azonenberg/integralstick/host-full/host-full.kicad_pcb

## KiCad design host-full/host-full.kicad_pcb (2019-11-11)

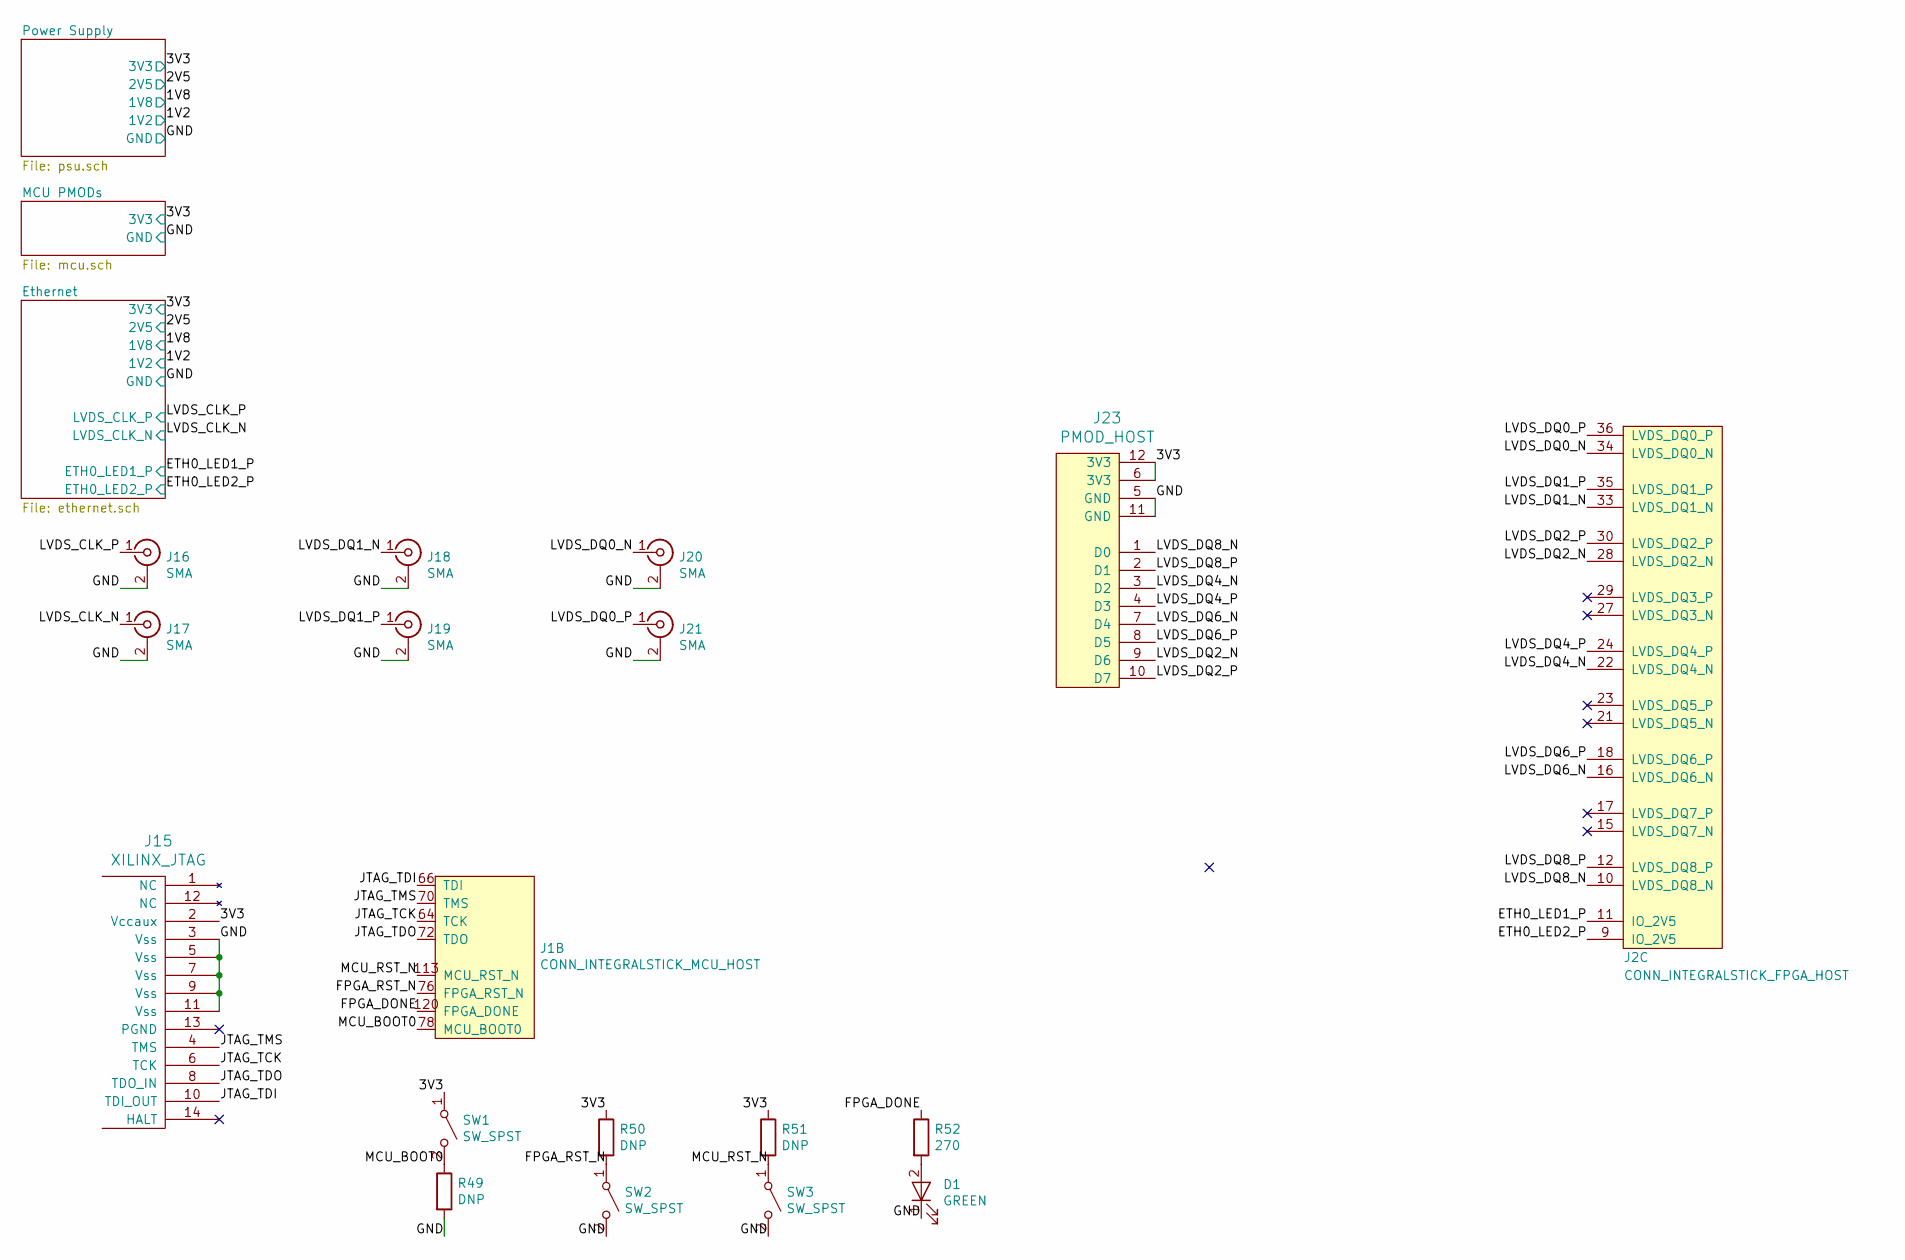
[picture p1: schematic host-full.sch, INTEGRALSTICK Full Host]

Parts:
D1: GREEN; EIA_0603_LED
J1: CONN_INTEGRALSTICK_MCU_HOST; CONN_SAMTEC_QSH-060-01-L-D-A
J2: CONN_INTEGRALSTICK_FPGA_HOST; CONN_SAMTEC_QSH-060-01-L-D-A
J15: XILINX_JTAG; XILINX_JTAG_PTH_MOLEX_0878311420
J16, J17, J18, J19, J20, J21: SMA; CONN_SMA_EDGE_SAMTEC_SMA_J_P_H_ST_EM1
J23: PMOD_HOST; CONN_HEADER_2.54MM_2x6_RA_PMOD_HOST
R49, R50, R51: DNP; EIA_0402_RES_NOSILK
R52: 270; EIA_0402_RES_NOSILK
SW1, SW2, SW3: SW_SPST; SWITCH_RAFI_MICON_5

Connections:
/3V3: J15.2 (Vccaux), J23.6 (3V3), J23.12 (3V3), R50.1, R51.1, SW1.1 (A); also elsewhere on the board
/ETH0_LED1_P: J2.11 (IO_2V5); also elsewhere on the board
/ETH0_LED2_P: J2.9 (IO_2V5); also elsewhere on the board
/FPGA_DONE: J1.120 (FPGA_DONE), R52.1
/FPGA_RST_N: J1.76 (FPGA_RST_N), R50.2, SW2.1 (A)
/GND: D1.1 (K), J15.3 (Vss), J15.5 (Vss), J15.7 (Vss), J15.9 (Vss), J15.11 (Vss), J16.2 (Ext), J17.2 (Ext), J18.2 (Ext), J19.2 (Ext), J20.2 (Ext), J21.2 (Ext), J23.5 (GND), J23.11 (GND), R49.2, SW2.2 (B), SW3.2 (B); also elsewhere on the board
/JTAG_TCK: J1.64 (TCK), J15.6 (TCK)
/JTAG_TDI: J1.66 (TDI), J15.10 (TDI_OUT)
/JTAG_TDO: J1.72 (TDO), J15.8 (TDO_IN)
/JTAG_TMS: J1.70 (TMS), J15.4 (TMS)
/LVDS_CLK_N: J17.1 (In); also elsewhere on the board
/LVDS_CLK_P: J16.1 (In); also elsewhere on the board
/LVDS_DQ0_N: J2.34 (LVDS_DQ0_N), J20.1 (In)
/LVDS_DQ0_P: J2.36 (LVDS_DQ0_P), J21.1 (In)
/LVDS_DQ1_N: J2.33 (LVDS_DQ1_N), J18.1 (In)
/LVDS_DQ1_P: J2.35 (LVDS_DQ1_P), J19.1 (In)
/LVDS_DQ2_N: J2.28 (LVDS_DQ2_N), J23.9 (D6)
/LVDS_DQ2_P: J2.30 (LVDS_DQ2_P), J23.10 (D7)
/LVDS_DQ4_N: J2.22 (LVDS_DQ4_N), J23.3 (D2)
/LVDS_DQ4_P: J2.24 (LVDS_DQ4_P), J23.4 (D3)
/LVDS_DQ6_N: J2.16 (LVDS_DQ6_N), J23.7 (D4)
/LVDS_DQ6_P: J2.18 (LVDS_DQ6_P), J23.8 (D5)
/LVDS_DQ8_N: J2.10 (LVDS_DQ8_N), J23.1 (D0)
/LVDS_DQ8_P: J2.12 (LVDS_DQ8_P), J23.2 (D1)
/MCU_BOOT0: J1.78 (MCU_BOOT0), R49.1, SW1.2 (B)
/MCU_RST_N: J1.113 (MCU_RST_N), R51.2, SW3.1 (A)
unnamed: D1.2 (A), R52.2

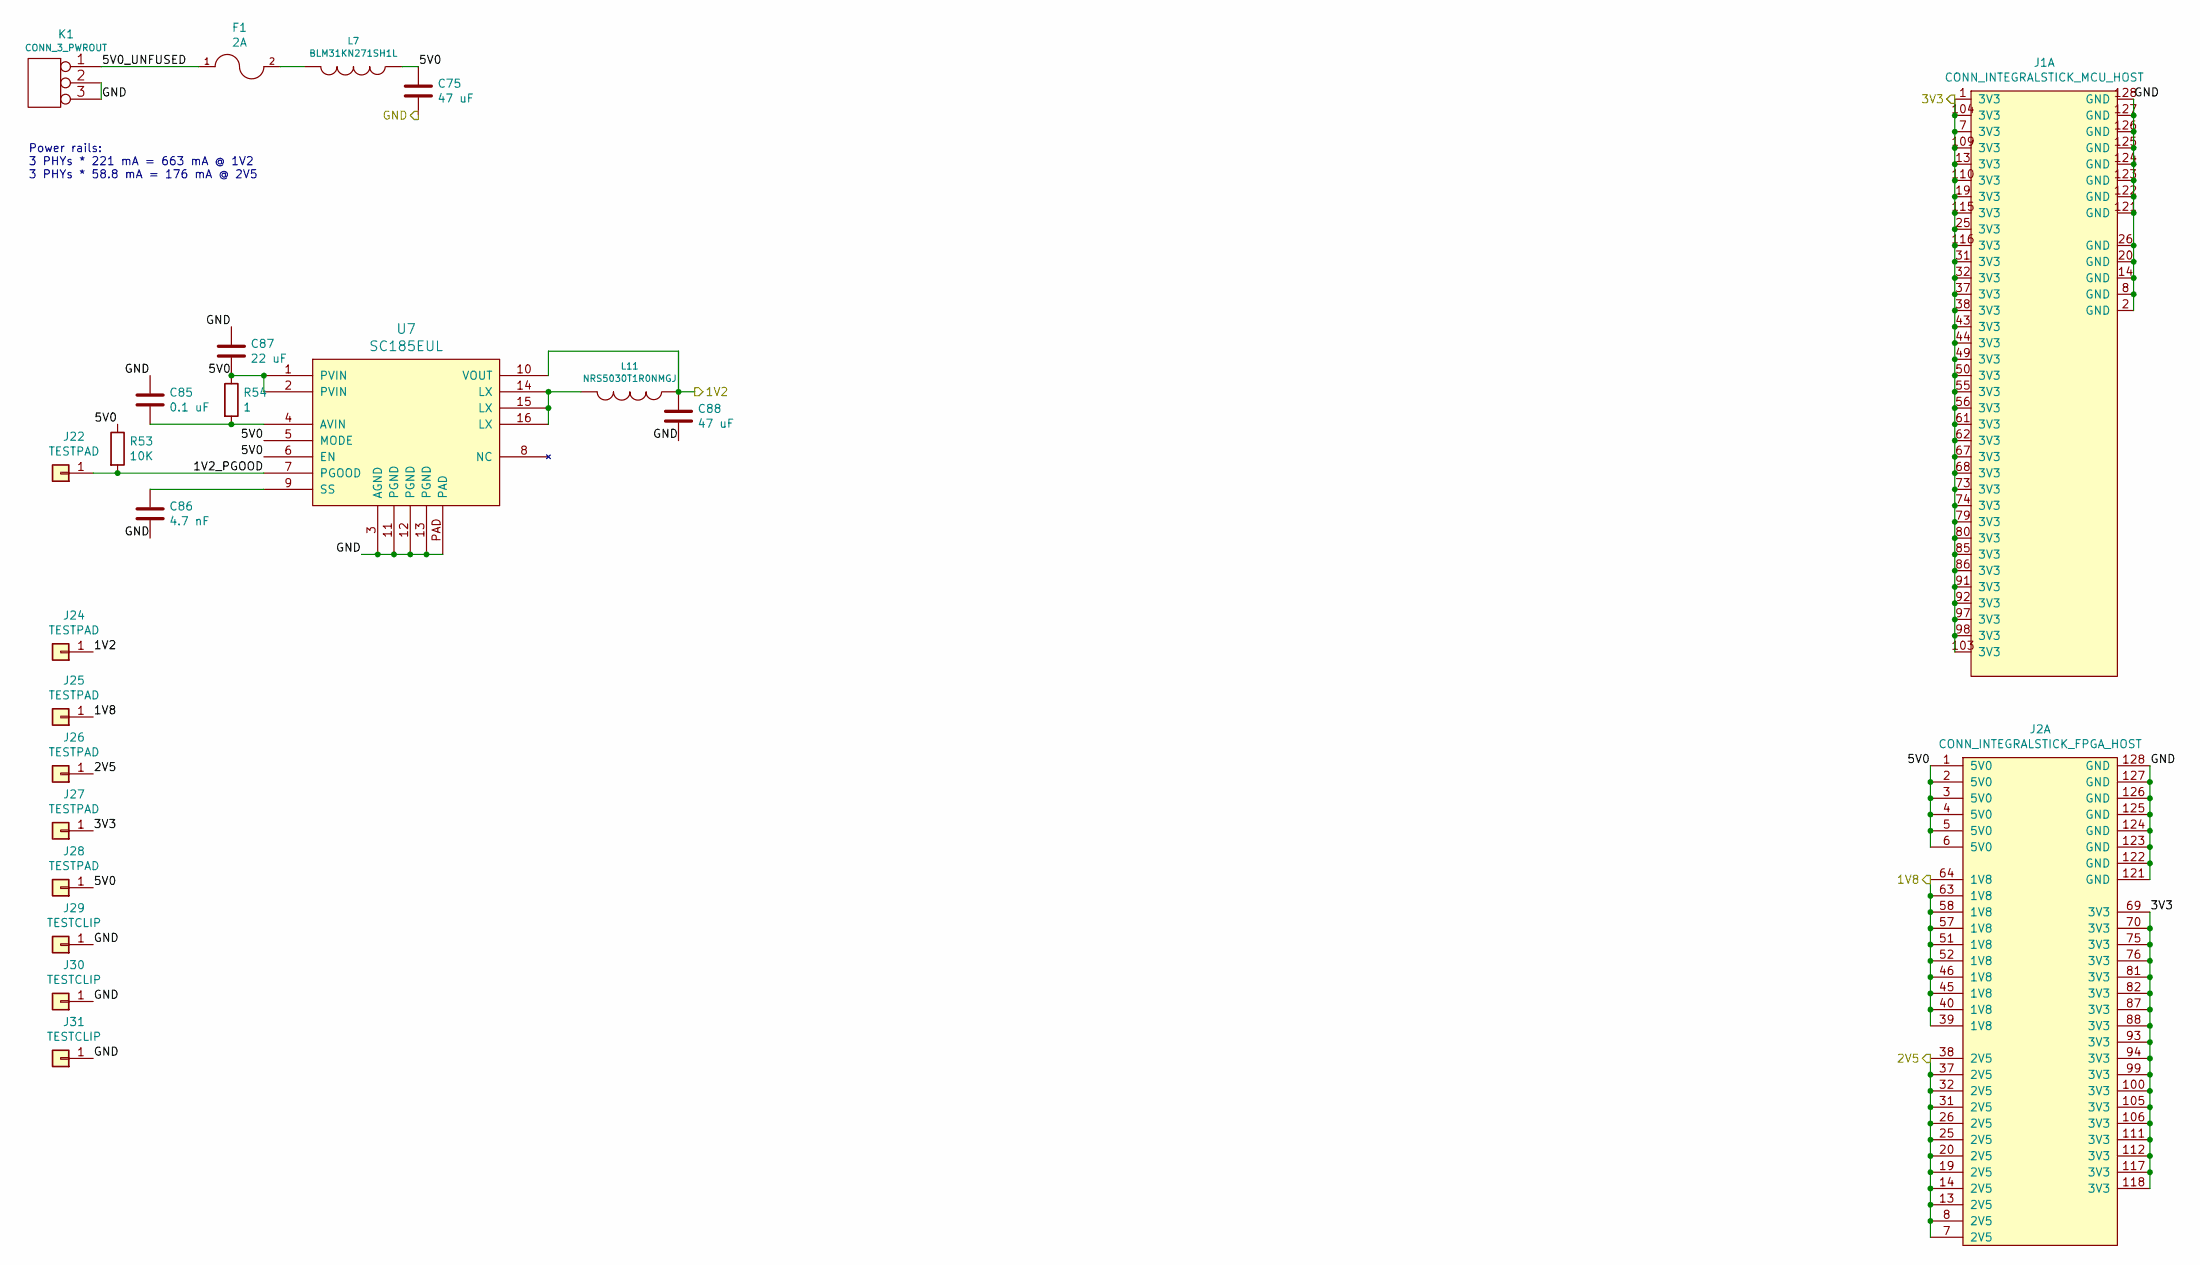
[picture p2: schematic psu.sch, INTEGRALSTICK Full Host]

Parts:
C75, C88: 47 uF; EIA_1210_CAP_NOSILK
C85: 0.1 uF; EIA_0402_CAP_NOSILK
C86: 4.7 nF; EIA_0603_CAP_NOSILK
C87: 22 uF; EIA_1210_CAP_NOSILK
F1: 2A; EIA_0603_RES_NOSILK
J1: CONN_INTEGRALSTICK_MCU_HOST; CONN_SAMTEC_QSH-060-01-L-D-A
J2: CONN_INTEGRALSTICK_FPGA_HOST; CONN_SAMTEC_QSH-060-01-L-D-A
J22, J24, J25, J26, J27, J28: TESTPAD; TESTPOINT_SMT_0.5MM
J29, J30, J31: TESTCLIP; TESTPOINT_SMT_KEYSTONE_5016
K1: CONN_3_PWROUT; CONN_CUI_PJ-058BH_HIPWR_BARREL_NOSLOT
L7: BLM31KN271SH1L; EIA_1206_CAP_NOSILK
L11: NRS5030T1R0NMGJ; INDUCTOR_YUDEN_NRS5030
R53: 10K; EIA_0402_RES_NOSILK
R54: 1; EIA_0402_RES_NOSILK
U7: SC185EUL; QFN_16_0.5MM_3x3MM

Connections:
/1V2: C88.1, J24.1, L11.1, U7.10 (VOUT); also elsewhere on the board
/1V8: J2.39 (1V8), J2.40 (1V8), J2.45 (1V8), J2.46 (1V8), J2.51 (1V8), J2.52 (1V8), J2.57 (1V8), J2.58 (1V8), J2.63 (1V8), J2.64 (1V8), J25.1; also elsewhere on the board
/2V5: J2.7 (2V5), J2.8 (2V5), J2.13 (2V5), J2.14 (2V5), J2.19 (2V5), J2.20 (2V5), J2.25 (2V5), J2.26 (2V5), J2.31 (2V5), J2.32 (2V5), J2.37 (2V5), J2.38 (2V5), J26.1; also elsewhere on the board
/3V3: J1.1 (3V3), J1.7 (3V3), J1.13 (3V3), J1.19 (3V3), J1.25 (3V3), J1.31 (3V3), J1.32 (3V3), J1.37 (3V3), J1.38 (3V3), J1.43 (3V3), J1.44 (3V3), J1.49 (3V3), J1.50 (3V3), J1.55 (3V3), J1.56 (3V3), J1.61 (3V3), J1.62 (3V3), J1.67 (3V3), J1.68 (3V3), J1.73 (3V3), J1.74 (3V3), J1.79 (3V3), J1.80 (3V3), J1.85 (3V3), J1.86 (3V3), J1.91 (3V3), J1.92 (3V3), J1.97 (3V3), J1.98 (3V3), J1.103 (3V3), J1.104 (3V3), J1.109 (3V3), J1.110 (3V3), J1.115 (3V3), J1.116 (3V3), J2.69 (3V3), J2.70 (3V3), J2.75 (3V3), J2.76 (3V3), J2.81 (3V3), J2.82 (3V3), J2.87 (3V3), J2.88 (3V3), J2.93 (3V3), J2.94 (3V3), J2.99 (3V3), J2.100 (3V3), J2.105 (3V3), J2.106 (3V3), J2.111 (3V3), J2.112 (3V3), J2.117 (3V3), J2.118 (3V3), J27.1; also elsewhere on the board
/GND: C75.2, C85.1, C86.2, C87.1, C88.2, J1.2 (GND), J1.8 (GND), J1.14 (GND), J1.20 (GND), J1.26 (GND), J1.121 (GND), J1.122 (GND), J1.123 (GND), J1.124 (GND), J1.125 (GND), J1.126 (GND), J1.127 (GND), J1.128 (GND), J2.121 (GND), J2.122 (GND), J2.123 (GND), J2.124 (GND), J2.125 (GND), J2.126 (GND), J2.127 (GND), J2.128 (GND), J29.1, J30.1, J31.1, K1.2 (PM), K1.3, U7.3 (AGND), U7.11 (PGND), U7.12 (PGND), U7.13 (PGND), U7.PAD; also elsewhere on the board
/Power Supply/1V2_PGOOD: J22.1, R53.2, U7.7 (PGOOD)
/Power Supply/5V0: C75.1, C87.2, J2.1 (5V0), J2.2 (5V0), J2.3 (5V0), J2.4 (5V0), J2.5 (5V0), J2.6 (5V0), J28.1, L7.1, R53.1, R54.1, U7.1 (PVIN), U7.2 (PVIN), U7.5 (MODE), U7.6 (EN)
/Power Supply/5V0_UNFUSED: F1.1, K1.1
unnamed: C85.2, R54.2, U7.4 (AVIN)
unnamed: C86.1, U7.9 (SS)
unnamed: F1.2, L7.2
unnamed: L11.2, U7.14 (LX), U7.15 (LX), U7.16 (LX)

Notes on the sheet:
Power rails: 3 PHYs * 221 mA = 663 mA @ 1V2 3 PHYs * 58.8 mA = 176 mA @ 2V5

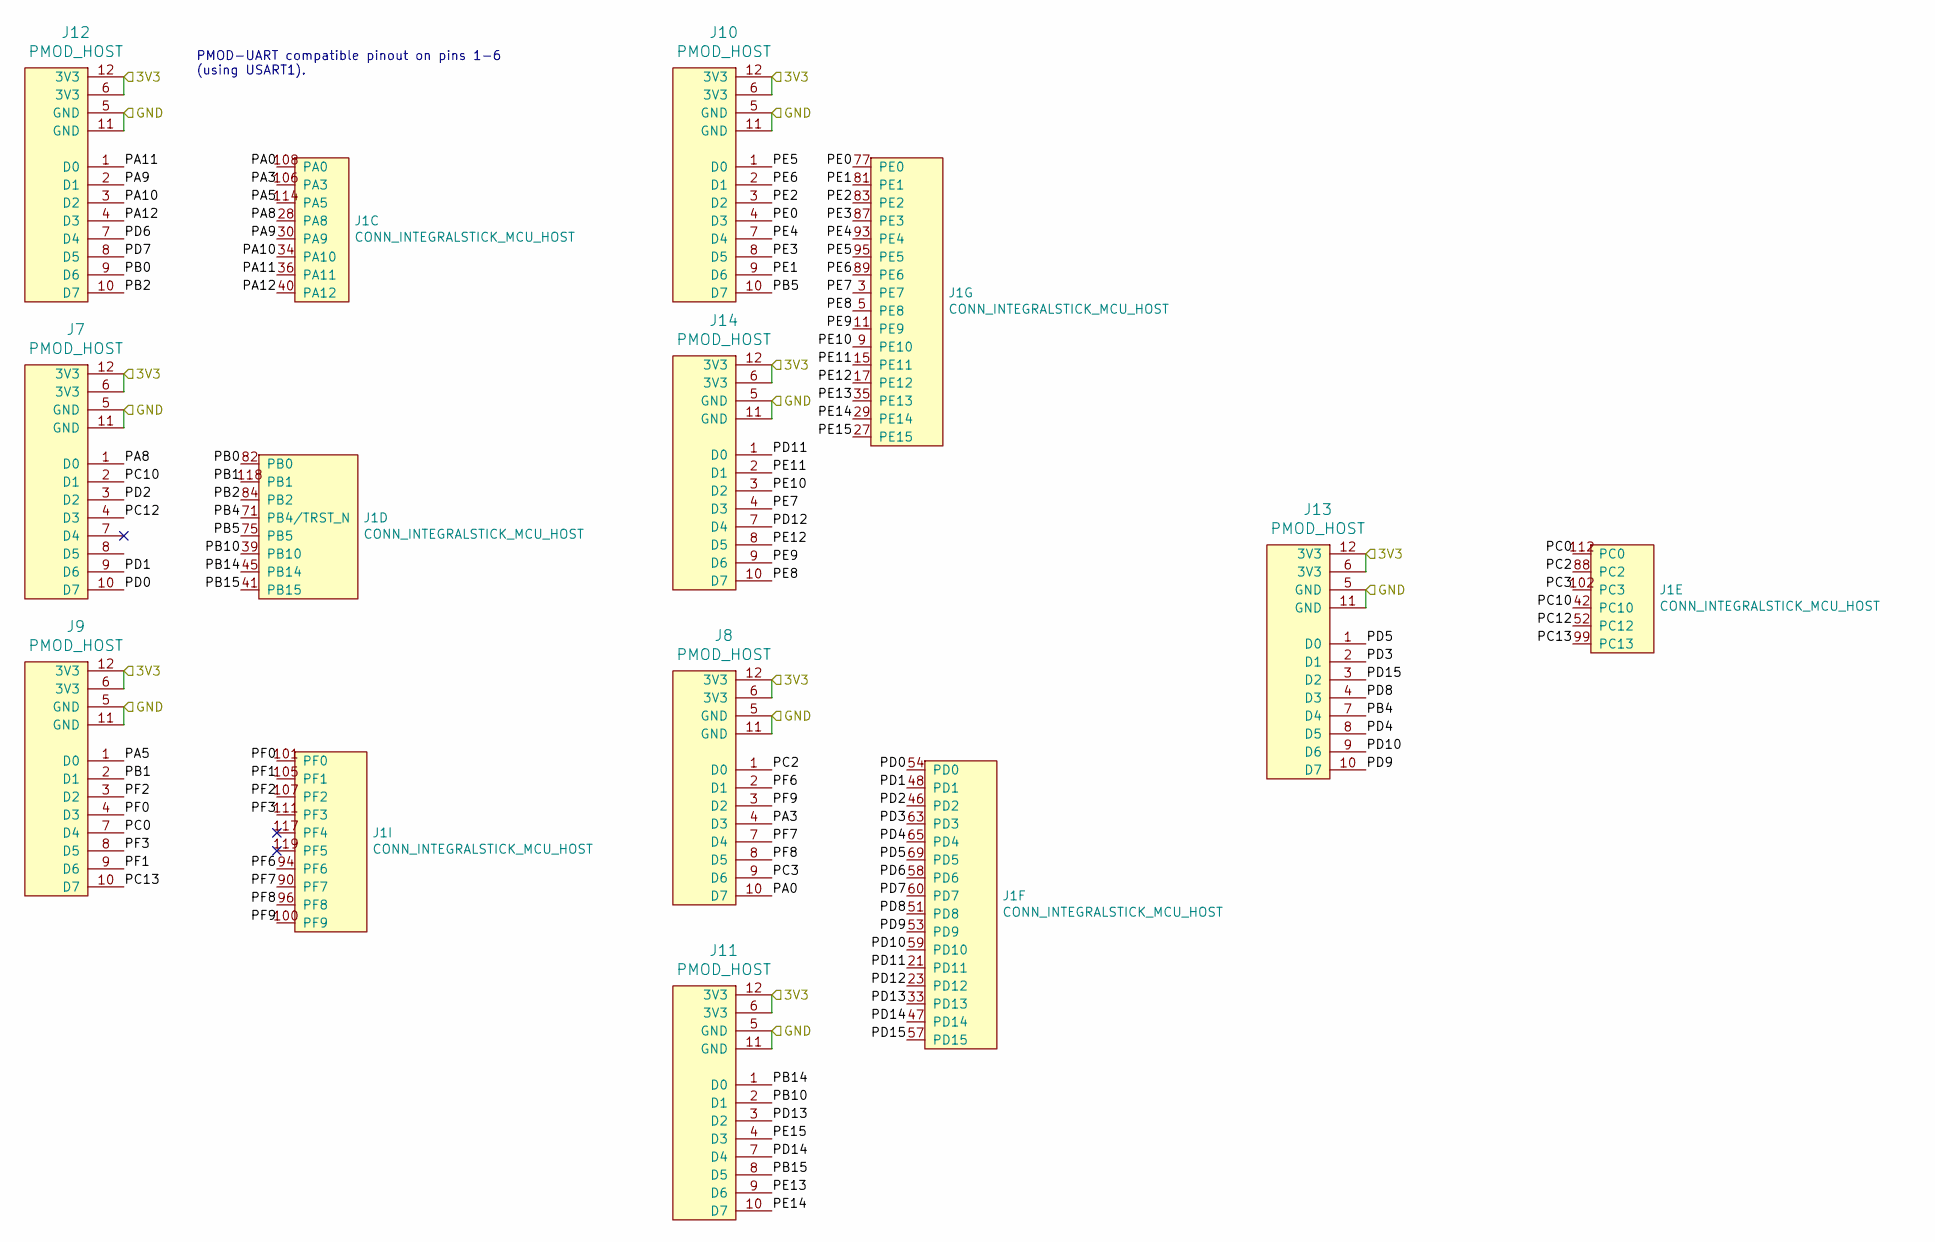
[picture p3: schematic mcu.sch, INTEGRALSTICK Full Host]

Parts:
J1: CONN_INTEGRALSTICK_MCU_HOST; CONN_SAMTEC_QSH-060-01-L-D-A
J7, J8, J9, J10, J11, J12, J13, J14: PMOD_HOST; CONN_HEADER_2.54MM_2x6_RA_PMOD_HOST

Connections:
/3V3: J7.6 (3V3), J7.12 (3V3), J8.6 (3V3), J8.12 (3V3), J9.6 (3V3), J9.12 (3V3), J10.6 (3V3), J10.12 (3V3), J11.6 (3V3), J11.12 (3V3), J12.6 (3V3), J12.12 (3V3), J13.6 (3V3), J13.12 (3V3), J14.6 (3V3), J14.12 (3V3); also elsewhere on the board
/GND: J7.5 (GND), J7.11 (GND), J8.5 (GND), J8.11 (GND), J9.5 (GND), J9.11 (GND), J10.5 (GND), J10.11 (GND), J11.5 (GND), J11.11 (GND), J12.5 (GND), J12.11 (GND), J13.5 (GND), J13.11 (GND), J14.5 (GND), J14.11 (GND); also elsewhere on the board
/MCU PMODs/PA0: J1.108 (PA0), J8.10 (D7)
/MCU PMODs/PA3: J1.106 (PA3), J8.4 (D3)
/MCU PMODs/PA5: J1.114 (PA5), J9.1 (D0)
/MCU PMODs/PA8: J1.28 (PA8), J7.1 (D0)
/MCU PMODs/PA9: J1.30 (PA9), J12.2 (D1)
/MCU PMODs/PA10: J1.34 (PA10), J12.3 (D2)
/MCU PMODs/PA11: J1.36 (PA11), J12.1 (D0)
/MCU PMODs/PA12: J1.40 (PA12), J12.4 (D3)
/MCU PMODs/PB0: J1.82 (PB0), J12.9 (D6)
/MCU PMODs/PB1: J1.118 (PB1), J9.2 (D1)
/MCU PMODs/PB2: J1.84 (PB2), J12.10 (D7)
/MCU PMODs/PB4: J1.71 (PB4/TRST_N), J13.7 (D4)
/MCU PMODs/PB5: J1.75 (PB5), J10.10 (D7)
/MCU PMODs/PB10: J1.39 (PB10), J11.2 (D1)
/MCU PMODs/PB14: J1.45 (PB14), J11.1 (D0)
/MCU PMODs/PB15: J1.41 (PB15), J11.8 (D5)
/MCU PMODs/PC0: J1.112 (PC0), J9.7 (D4)
/MCU PMODs/PC2: J1.88 (PC2), J8.1 (D0)
/MCU PMODs/PC3: J1.102 (PC3), J8.9 (D6)
/MCU PMODs/PC10: J1.42 (PC10), J7.2 (D1)
/MCU PMODs/PC12: J1.52 (PC12), J7.4 (D3)
/MCU PMODs/PC13: J1.99 (PC13), J9.10 (D7)
/MCU PMODs/PD0: J1.54 (PD0), J7.10 (D7)
/MCU PMODs/PD1: J1.48 (PD1), J7.9 (D6)
/MCU PMODs/PD2: J1.46 (PD2), J7.3 (D2)
/MCU PMODs/PD3: J1.63 (PD3), J13.2 (D1)
/MCU PMODs/PD4: J1.65 (PD4), J13.8 (D5)
/MCU PMODs/PD5: J1.69 (PD5), J13.1 (D0)
/MCU PMODs/PD6: J1.58 (PD6), J12.7 (D4)
/MCU PMODs/PD7: J1.60 (PD7), J12.8 (D5)
/MCU PMODs/PD8: J1.51 (PD8), J13.4 (D3)
/MCU PMODs/PD9: J1.53 (PD9), J13.10 (D7)
/MCU PMODs/PD10: J1.59 (PD10), J13.9 (D6)
/MCU PMODs/PD11: J1.21 (PD11), J14.1 (D0)
/MCU PMODs/PD12: J1.23 (PD12), J14.7 (D4)
/MCU PMODs/PD13: J1.33 (PD13), J11.3 (D2)
/MCU PMODs/PD14: J1.47 (PD14), J11.7 (D4)
/MCU PMODs/PD15: J1.57 (PD15), J13.3 (D2)
/MCU PMODs/PE0: J1.77 (PE0), J10.4 (D3)
/MCU PMODs/PE1: J1.81 (PE1), J10.9 (D6)
/MCU PMODs/PE2: J1.83 (PE2), J10.3 (D2)
/MCU PMODs/PE3: J1.87 (PE3), J10.8 (D5)
/MCU PMODs/PE4: J1.93 (PE4), J10.7 (D4)
/MCU PMODs/PE5: J1.95 (PE5), J10.1 (D0)
/MCU PMODs/PE6: J1.89 (PE6), J10.2 (D1)
/MCU PMODs/PE7: J1.3 (PE7), J14.4 (D3)
/MCU PMODs/PE8: J1.5 (PE8), J14.10 (D7)
/MCU PMODs/PE9: J1.11 (PE9), J14.9 (D6)
/MCU PMODs/PE10: J1.9 (PE10), J14.3 (D2)
/MCU PMODs/PE11: J1.15 (PE11), J14.2 (D1)
/MCU PMODs/PE12: J1.17 (PE12), J14.8 (D5)
/MCU PMODs/PE13: J1.35 (PE13), J11.9 (D6)
/MCU PMODs/PE14: J1.29 (PE14), J11.10 (D7)
/MCU PMODs/PE15: J1.27 (PE15), J11.4 (D3)
/MCU PMODs/PF0: J1.101 (PF0), J9.4 (D3)
/MCU PMODs/PF1: J1.105 (PF1), J9.9 (D6)
/MCU PMODs/PF2: J1.107 (PF2), J9.3 (D2)
/MCU PMODs/PF3: J1.111 (PF3), J9.8 (D5)
/MCU PMODs/PF6: J1.94 (PF6), J8.2 (D1)
/MCU PMODs/PF7: J1.90 (PF7), J8.7 (D4)
/MCU PMODs/PF8: J1.96 (PF8), J8.8 (D5)
/MCU PMODs/PF9: J1.100 (PF9), J8.3 (D2)

Notes on the sheet:
PMOD-UART compatible pinout on pins 1-6 (using USART1).
