azonenberg/integralstick/host-full/host-full.kicad_pcb

## KiCad design host-full/host-full.kicad_pcb (continued)

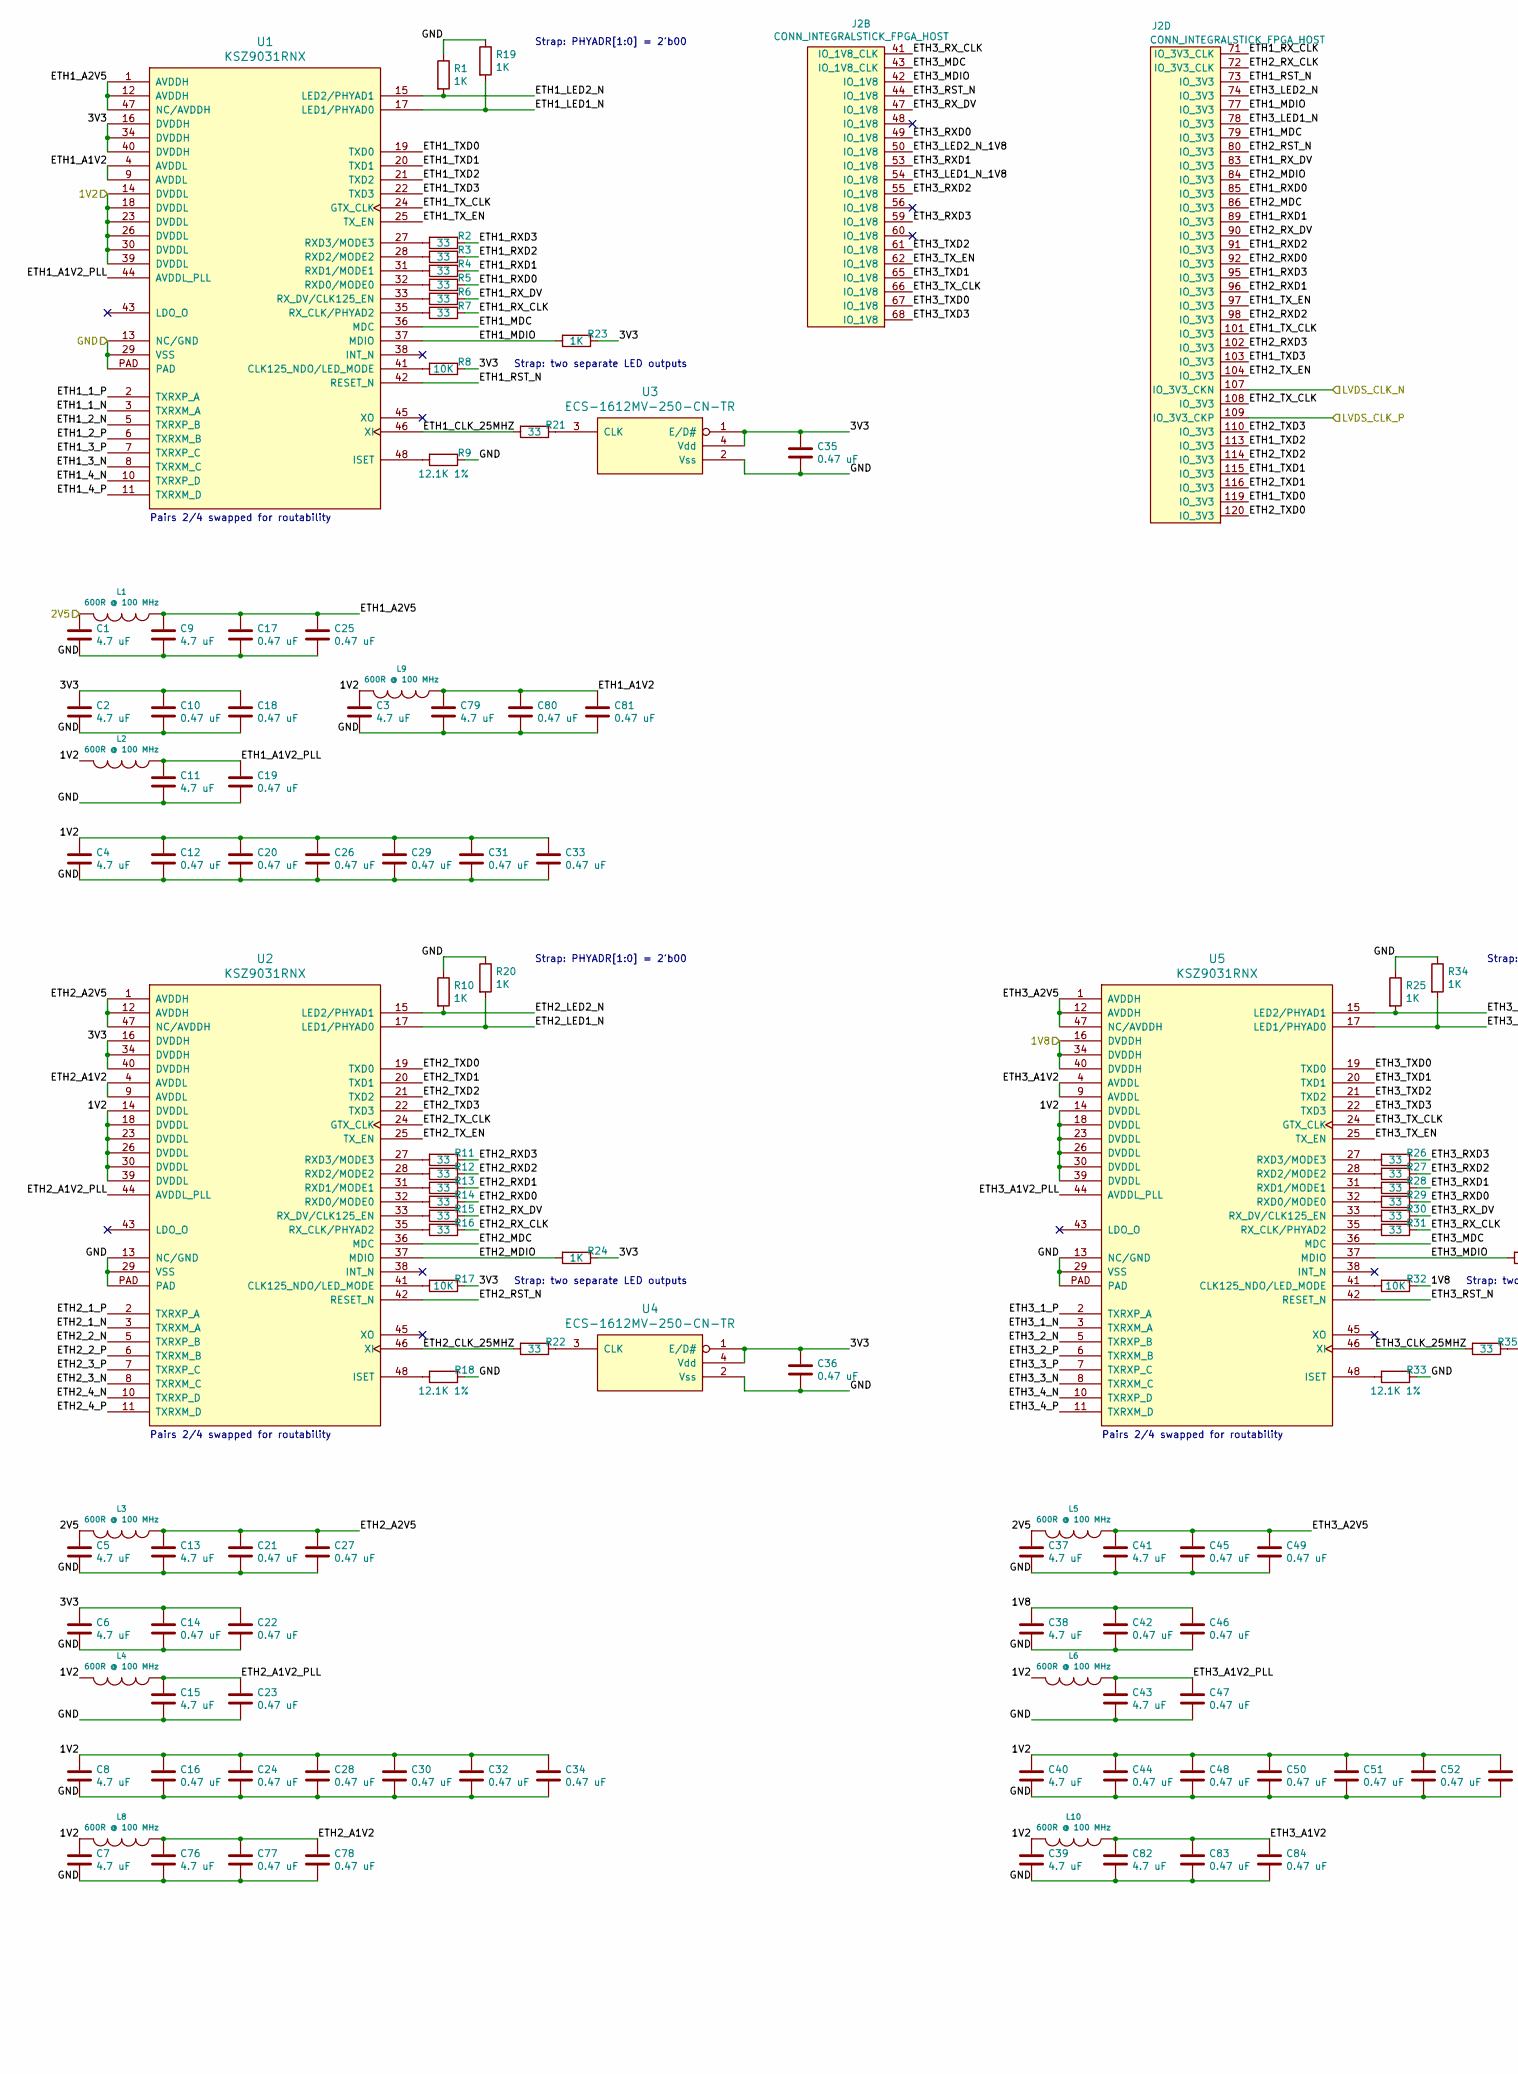
[picture p4: schematic ethernet.sch, INTEGRALSTICK Full Host, part in row 1, column 1]

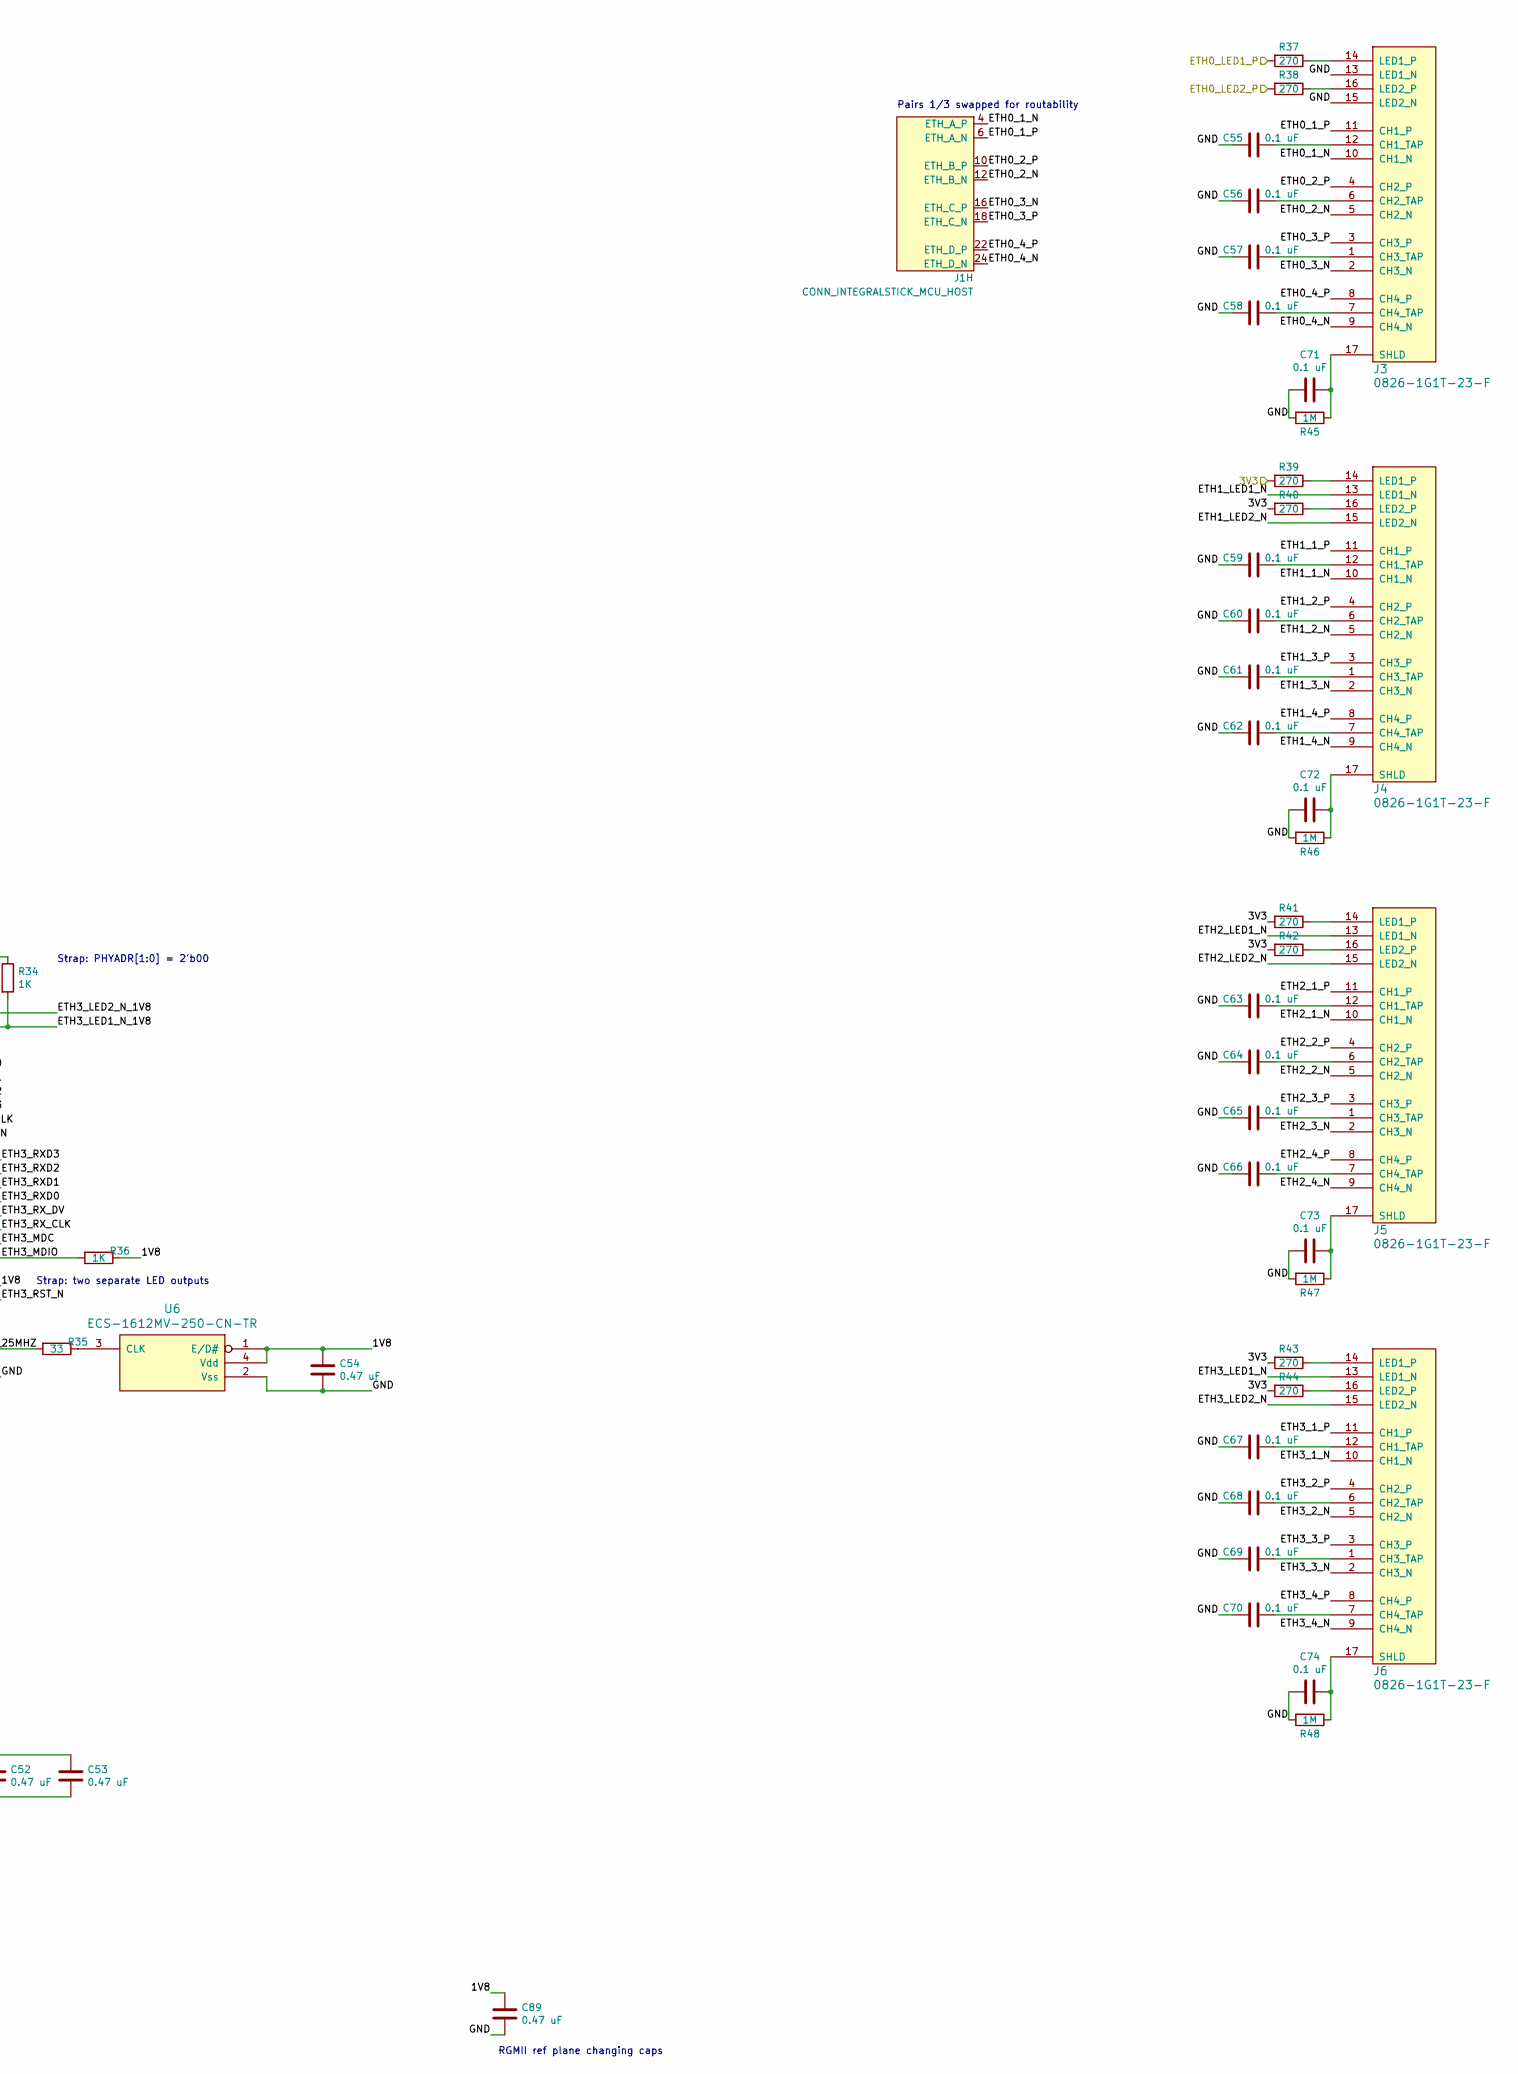
[picture p5: schematic ethernet.sch, INTEGRALSTICK Full Host, part in row 1, column 2]

Parts:
C1, C2, C3, C4, C5, C6, C7, C8, C9, C11, C13, C15, C37, C38, C39, C40, C41, C43, C76, C79, C82: 4.7 uF; EIA_0603_CAP_NOSILK
C10, C12, C14, C16, C17, C18, C19, C20, C21, C22, C23, C24, C25, C26, C27, C28, C29, C30, C31, C32, C33, C34, C35, C36, C42, C44, C45, C46, C47, C48, C49, C50, C51, C52, C53, C54, C77, C78, C80, C81, C83, C84, C89: 0.47 uF; EIA_0402_CAP_NOSILK
C55, C56, C57, C58, C59, C60, C61, C62, C63, C64, C65, C66, C67, C68, C69, C70, C71, C72, C73, C74: 0.1 uF; EIA_0402_CAP_NOSILK
J1: CONN_INTEGRALSTICK_MCU_HOST; CONN_SAMTEC_QSH-060-01-L-D-A
J2: CONN_INTEGRALSTICK_FPGA_HOST; CONN_SAMTEC_QSH-060-01-L-D-A
J3, J4, J5, J6: 0826-1G1T-23-F; CONN_BELFUSE_0826_1G1T_23_F
L1, L2, L3, L4, L5, L6, L8, L9, L10: 600R @ 100 MHz; EIA_0402_CAP_NOSILK
R1, R10, R19, R20, R23, R24, R25, R34, R36: 1K; EIA_0402_RES_NOSILK
R2, R3, R4, R5, R6, R7, R11, R12, R13, R14, R15, R16, R21, R22, R26, R27, R28, R29, R30, R31, R35: 33; EIA_0402_RES_NOSILK
R8, R17, R32: 10K; EIA_0402_RES_NOSILK
R9, R18, R33: 12.1K 1%; EIA_0402_RES_NOSILK
R37, R38, R39, R40, R41, R42, R43, R44: 270; EIA_0402_RES_NOSILK
R45, R46, R47, R48: 1M; EIA_0402_RES_NOSILK
U1, U2, U5: KSZ9031RNX; QFN_48_0.5MM_7x7MM
U3, U4, U6: ECS-1612MV-250-CN-TR; OSCILLATOR_1.6x1.2

Connections:
/1V2: C3.1, C4.1, C7.1, C8.1, C12.1, C16.1, C20.1, C24.1, C26.1, C28.1, C29.1, C30.1, C31.1, C32.1, C33.1, C34.1, C39.1, C40.1, C44.1, C48.1, C50.1, C51.1, C52.1, C53.1, L2.2, L4.2, L6.2, L8.2, L9.2, L10.2, U1.14 (DVDDL), U1.18 (DVDDL), U1.23 (DVDDL), U1.26 (DVDDL), U1.30 (DVDDL), U1.39 (DVDDL), U2.14 (DVDDL), U2.18 (DVDDL), U2.23 (DVDDL), U2.26 (DVDDL), U2.30 (DVDDL), U2.39 (DVDDL), U5.14 (DVDDL), U5.18 (DVDDL), U5.23 (DVDDL), U5.26 (DVDDL), U5.30 (DVDDL), U5.39 (DVDDL); also elsewhere on the board
/1V8: C38.1, C42.1, C46.1, C54.1, C89.1, R32.1, R36.1, U5.16 (DVDDH), U5.34 (DVDDH), U5.40 (DVDDH), U6.1 (E/D#), U6.4 (Vdd); also elsewhere on the board
/2V5: C1.1, C5.1, C37.1, L1.2, L3.2, L5.2; also elsewhere on the board
/3V3: C2.1, C6.1, C10.1, C14.1, C18.1, C22.1, C35.1, C36.1, R8.1, R17.1, R23.1, R24.1, R39.2, R40.2, R41.2, R42.2, R43.2, R44.2, U1.16 (DVDDH), U1.34 (DVDDH), U1.40 (DVDDH), U2.16 (DVDDH), U2.34 (DVDDH), U2.40 (DVDDH), U3.1 (E/D#), U3.4 (Vdd), U4.1 (E/D#), U4.4 (Vdd); also elsewhere on the board
/ETH0_LED1_P: R37.2; also elsewhere on the board
/ETH0_LED2_P: R38.2; also elsewhere on the board
/Ethernet/ETH0_1_N: J1.4 (ETH_A_P), J3.10 (CH1_N)
/Ethernet/ETH0_1_P: J1.6 (ETH_A_N), J3.11 (CH1_P)
/Ethernet/ETH0_2_N: J1.12 (ETH_B_N), J3.5 (CH2_N)
/Ethernet/ETH0_2_P: J1.10 (ETH_B_P), J3.4 (CH2_P)
/Ethernet/ETH0_3_N: J1.16 (ETH_C_P), J3.2 (CH3_N)
/Ethernet/ETH0_3_P: J1.18 (ETH_C_N), J3.3 (CH3_P)
/Ethernet/ETH0_4_N: J1.24 (ETH_D_N), J3.9 (CH4_N)
/Ethernet/ETH0_4_P: J1.22 (ETH_D_P), J3.8 (CH4_P)
/Ethernet/ETH1_1_N: J4.10 (CH1_N), U1.3 (TXRXM_A)
/Ethernet/ETH1_1_P: J4.11 (CH1_P), U1.2 (TXRXP_A)
/Ethernet/ETH1_2_N: J4.5 (CH2_N), U1.5 (TXRXP_B)
/Ethernet/ETH1_2_P: J4.4 (CH2_P), U1.6 (TXRXM_B)
/Ethernet/ETH1_3_N: J4.2 (CH3_N), U1.8 (TXRXM_C)
/Ethernet/ETH1_3_P: J4.3 (CH3_P), U1.7 (TXRXP_C)
/Ethernet/ETH1_4_N: J4.9 (CH4_N), U1.10 (TXRXP_D)
/Ethernet/ETH1_4_P: J4.8 (CH4_P), U1.11 (TXRXM_D)
/Ethernet/ETH1_A1V2: C79.1, C80.1, C81.1, L9.1, U1.4 (AVDDL), U1.9 (AVDDL)
/Ethernet/ETH1_A1V2_PLL: C11.1, C19.1, L2.1, U1.44 (AVDDL_PLL)
/Ethernet/ETH1_A2V5: C9.1, C17.1, C25.1, L1.1, U1.1 (AVDDH), U1.12 (AVDDH), U1.47 (NC/AVDDH)
/Ethernet/ETH1_CLK_25MHZ: R21.2, U1.46 (XI)
/Ethernet/ETH1_LED1_N: J4.13 (LED1_N), R19.2, U1.17 (LED1/PHYAD0)
/Ethernet/ETH1_LED2_N: J4.15 (LED2_N), R1.2, U1.15 (LED2/PHYAD1)
/Ethernet/ETH1_MDC: J2.79 (IO_3V3), U1.36 (MDC)
/Ethernet/ETH1_MDIO: J2.77 (IO_3V3), R23.2, U1.37 (MDIO)
/Ethernet/ETH1_RST_N: J2.73 (IO_3V3), U1.42 (RESET_N)
/Ethernet/ETH1_RXD0: J2.85 (IO_3V3), R5.1
/Ethernet/ETH1_RXD1: J2.89 (IO_3V3), R4.1
/Ethernet/ETH1_RXD2: J2.91 (IO_3V3), R3.1
/Ethernet/ETH1_RXD3: J2.95 (IO_3V3), R2.1
/Ethernet/ETH1_RX_CLK: J2.71 (IO_3V3_CLK), R7.1
/Ethernet/ETH1_RX_DV: J2.83 (IO_3V3), R6.1
/Ethernet/ETH1_TXD0: J2.119 (IO_3V3), U1.19 (TXD0)
/Ethernet/ETH1_TXD1: J2.115 (IO_3V3), U1.20 (TXD1)
/Ethernet/ETH1_TXD2: J2.113 (IO_3V3), U1.21 (TXD2)
/Ethernet/ETH1_TXD3: J2.103 (IO_3V3), U1.22 (TXD3)
/Ethernet/ETH1_TX_CLK: J2.101 (IO_3V3), U1.24 (GTX_CLK)
/Ethernet/ETH1_TX_EN: J2.97 (IO_3V3), U1.25 (TX_EN)
/Ethernet/ETH2_1_N: J5.10 (CH1_N), U2.3 (TXRXM_A)
/Ethernet/ETH2_1_P: J5.11 (CH1_P), U2.2 (TXRXP_A)
/Ethernet/ETH2_2_N: J5.5 (CH2_N), U2.5 (TXRXP_B)
/Ethernet/ETH2_2_P: J5.4 (CH2_P), U2.6 (TXRXM_B)
/Ethernet/ETH2_3_N: J5.2 (CH3_N), U2.8 (TXRXM_C)
/Ethernet/ETH2_3_P: J5.3 (CH3_P), U2.7 (TXRXP_C)
/Ethernet/ETH2_4_N: J5.9 (CH4_N), U2.10 (TXRXP_D)
/Ethernet/ETH2_4_P: J5.8 (CH4_P), U2.11 (TXRXM_D)
/Ethernet/ETH2_A1V2: C76.1, C77.1, C78.1, L8.1, U2.4 (AVDDL), U2.9 (AVDDL)
/Ethernet/ETH2_A1V2_PLL: C15.1, C23.1, L4.1, U2.44 (AVDDL_PLL)
/Ethernet/ETH2_A2V5: C13.1, C21.1, C27.1, L3.1, U2.1 (AVDDH), U2.12 (AVDDH), U2.47 (NC/AVDDH)
/Ethernet/ETH2_CLK_25MHZ: R22.2, U2.46 (XI)
/Ethernet/ETH2_LED1_N: J5.13 (LED1_N), R20.2, U2.17 (LED1/PHYAD0)
/Ethernet/ETH2_LED2_N: J5.15 (LED2_N), R10.2, U2.15 (LED2/PHYAD1)
/Ethernet/ETH2_MDC: J2.86 (IO_3V3), U2.36 (MDC)
/Ethernet/ETH2_MDIO: J2.84 (IO_3V3), R24.2, U2.37 (MDIO)
/Ethernet/ETH2_RST_N: J2.80 (IO_3V3), U2.42 (RESET_N)
/Ethernet/ETH2_RXD0: J2.92 (IO_3V3), R14.1
/Ethernet/ETH2_RXD1: J2.96 (IO_3V3), R13.1
/Ethernet/ETH2_RXD2: J2.98 (IO_3V3), R12.1
/Ethernet/ETH2_RXD3: J2.102 (IO_3V3), R11.1
/Ethernet/ETH2_RX_CLK: J2.72 (IO_3V3_CLK), R16.1
/Ethernet/ETH2_RX_DV: J2.90 (IO_3V3), R15.1
/Ethernet/ETH2_TXD0: J2.120 (IO_3V3), U2.19 (TXD0)
/Ethernet/ETH2_TXD1: J2.116 (IO_3V3), U2.20 (TXD1)
/Ethernet/ETH2_TXD2: J2.114 (IO_3V3), U2.21 (TXD2)
/Ethernet/ETH2_TXD3: J2.110 (IO_3V3), U2.22 (TXD3)
/Ethernet/ETH2_TX_CLK: J2.108 (IO_3V3), U2.24 (GTX_CLK)
/Ethernet/ETH2_TX_EN: J2.104 (IO_3V3), U2.25 (TX_EN)
/Ethernet/ETH3_1_N: J6.10 (CH1_N), U5.3 (TXRXM_A)
/Ethernet/ETH3_1_P: J6.11 (CH1_P), U5.2 (TXRXP_A)
/Ethernet/ETH3_2_N: J6.5 (CH2_N), U5.5 (TXRXP_B)
/Ethernet/ETH3_2_P: J6.4 (CH2_P), U5.6 (TXRXM_B)
/Ethernet/ETH3_3_N: J6.2 (CH3_N), U5.8 (TXRXM_C)
/Ethernet/ETH3_3_P: J6.3 (CH3_P), U5.7 (TXRXP_C)
/Ethernet/ETH3_4_N: J6.9 (CH4_N), U5.10 (TXRXP_D)
/Ethernet/ETH3_4_P: J6.8 (CH4_P), U5.11 (TXRXM_D)
/Ethernet/ETH3_A1V2: C82.1, C83.1, C84.1, L10.1, U5.4 (AVDDL), U5.9 (AVDDL)
/Ethernet/ETH3_A1V2_PLL: C43.1, C47.1, L6.1, U5.44 (AVDDL_PLL)
/Ethernet/ETH3_A2V5: C41.1, C45.1, C49.1, L5.1, U5.1 (AVDDH), U5.12 (AVDDH), U5.47 (NC/AVDDH)
/Ethernet/ETH3_CLK_25MHZ: R35.2, U5.46 (XI)
/Ethernet/ETH3_LED1_N: J2.78 (IO_3V3), J6.13 (LED1_N)
/Ethernet/ETH3_LED1_N_1V8: J2.54 (IO_1V8), R34.2, U5.17 (LED1/PHYAD0)
/Ethernet/ETH3_LED2_N: J2.74 (IO_3V3), J6.15 (LED2_N)
/Ethernet/ETH3_LED2_N_1V8: J2.50 (IO_1V8), R25.2, U5.15 (LED2/PHYAD1)
/Ethernet/ETH3_MDC: J2.43 (IO_1V8_CLK), U5.36 (MDC)
/Ethernet/ETH3_MDIO: J2.42 (IO_1V8), R36.2, U5.37 (MDIO)
/Ethernet/ETH3_RST_N: J2.44 (IO_1V8), U5.42 (RESET_N)
/Ethernet/ETH3_RXD0: J2.49 (IO_1V8), R29.1
/Ethernet/ETH3_RXD1: J2.53 (IO_1V8), R28.1
/Ethernet/ETH3_RXD2: J2.55 (IO_1V8), R27.1
/Ethernet/ETH3_RXD3: J2.59 (IO_1V8), R26.1
/Ethernet/ETH3_RX_CLK: J2.41 (IO_1V8_CLK), R31.1
/Ethernet/ETH3_RX_DV: J2.47 (IO_1V8), R30.1
/Ethernet/ETH3_TXD0: J2.67 (IO_1V8), U5.19 (TXD0)
/Ethernet/ETH3_TXD1: J2.65 (IO_1V8), U5.20 (TXD1)
/Ethernet/ETH3_TXD2: J2.61 (IO_1V8), U5.21 (TXD2)
/Ethernet/ETH3_TXD3: J2.68 (IO_1V8), U5.22 (TXD3)
/Ethernet/ETH3_TX_CLK: J2.66 (IO_1V8), U5.24 (GTX_CLK)
/Ethernet/ETH3_TX_EN: J2.62 (IO_1V8), U5.25 (TX_EN)
/GND: C1.2, C2.2, C3.2, C4.2, C5.2, C6.2, C7.2, C8.2, C9.2, C10.2, C11.2, C12.2, C13.2, C14.2, C15.2, C16.2, C17.2, C18.2, C19.2, C20.2, C21.2, C22.2, C23.2, C24.2, C25.2, C26.2, C27.2, C28.2, C29.2, C30.2, C31.2, C32.2, C33.2, C34.2, C35.2, C36.2, C37.2, C38.2, C39.2, C40.2, C41.2, C42.2, C43.2, C44.2, C45.2, C46.2, C47.2, C48.2, C49.2, C50.2, C51.2, C52.2, C53.2, C54.2, C55.2, C56.2, C57.2, C58.2, C59.2, C60.2, C61.2, C62.2, C63.2, C64.2, C65.2, C66.2, C67.2, C68.2, C69.2, C70.2, C71.2, C72.2, C73.2, C74.2, C76.2, C77.2, C78.2, C79.2, C80.2, C81.2, C82.2, C83.2, C84.2, C89.2, J3.13 (LED1_N), J3.15 (LED2_N), R1.1, R9.1, R10.1, R18.1, R19.1, R20.1, R25.1, R33.1, R34.1, R45.2, R46.2, R47.2, R48.2, U1.13 (NC/GND), U1.29 (VSS), U1.PAD, U2.13 (NC/GND), U2.29 (VSS), U2.PAD, U3.2 (Vss), U4.2 (Vss), U5.13 (NC/GND), U5.29 (VSS), U5.PAD, U6.2 (Vss); also elsewhere on the board
/LVDS_CLK_N: J2.107 (IO_3V3_CKN); also elsewhere on the board
/LVDS_CLK_P: J2.109 (IO_3V3_CKP); also elsewhere on the board
unnamed: C55.1, J3.12 (CH1_TAP)
unnamed: C56.1, J3.6 (CH2_TAP)
unnamed: C57.1, J3.1 (CH3_TAP)
unnamed: C58.1, J3.7 (CH4_TAP)
unnamed: C59.1, J4.12 (CH1_TAP)
unnamed: C60.1, J4.6 (CH2_TAP)
unnamed: C61.1, J4.1 (CH3_TAP)
unnamed: C62.1, J4.7 (CH4_TAP)
unnamed: C63.1, J5.12 (CH1_TAP)
unnamed: C64.1, J5.6 (CH2_TAP)
unnamed: C65.1, J5.1 (CH3_TAP)
unnamed: C66.1, J5.7 (CH4_TAP)
unnamed: C67.1, J6.12 (CH1_TAP)
unnamed: C68.1, J6.6 (CH2_TAP)
unnamed: C69.1, J6.1 (CH3_TAP)
unnamed: C70.1, J6.7 (CH4_TAP)
unnamed: C71.1, J3.17 (SHLD), R45.1
unnamed: C72.1, J4.17 (SHLD), R46.1
unnamed: C73.1, J5.17 (SHLD), R47.1
unnamed: C74.1, J6.17 (SHLD), R48.1
unnamed: J3.14 (LED1_P), R37.1
unnamed: J3.16 (LED2_P), R38.1
unnamed: J4.14 (LED1_P), R39.1
unnamed: J4.16 (LED2_P), R40.1
unnamed: J5.14 (LED1_P), R41.1
unnamed: J5.16 (LED2_P), R42.1
unnamed: J6.14 (LED1_P), R43.1
unnamed: J6.16 (LED2_P), R44.1
unnamed: R2.2, U1.27 (RXD3/MODE3)
unnamed: R3.2, U1.28 (RXD2/MODE2)
unnamed: R4.2, U1.31 (RXD1/MODE1)
unnamed: R5.2, U1.32 (RXD0/MODE0)
unnamed: R6.2, U1.33 (RX_DV/CLK125_EN)
unnamed: R7.2, U1.35 (RX_CLK/PHYAD2)
unnamed: R8.2, U1.41 (CLK125_NDO/LED_MODE)
unnamed: R9.2, U1.48 (ISET)
unnamed: R11.2, U2.27 (RXD3/MODE3)
unnamed: R12.2, U2.28 (RXD2/MODE2)
unnamed: R13.2, U2.31 (RXD1/MODE1)
unnamed: R14.2, U2.32 (RXD0/MODE0)
unnamed: R15.2, U2.33 (RX_DV/CLK125_EN)
unnamed: R16.2, U2.35 (RX_CLK/PHYAD2)
unnamed: R17.2, U2.41 (CLK125_NDO/LED_MODE)
unnamed: R18.2, U2.48 (ISET)
unnamed: R21.1, U3.3 (CLK)
unnamed: R22.1, U4.3 (CLK)
unnamed: R26.2, U5.27 (RXD3/MODE3)
unnamed: R27.2, U5.28 (RXD2/MODE2)
unnamed: R28.2, U5.31 (RXD1/MODE1)
unnamed: R29.2, U5.32 (RXD0/MODE0)
unnamed: R30.2, U5.33 (RX_DV/CLK125_EN)
unnamed: R31.2, U5.35 (RX_CLK/PHYAD2)
unnamed: R32.2, U5.41 (CLK125_NDO/LED_MODE)
unnamed: R33.2, U5.48 (ISET)
unnamed: R35.1, U6.3 (CLK)

Notes on the sheet:
Strap: PHYADR[1:0] = 2'b00
Strap: two separate LED outputs
Pairs 2/4 swapped for routability
Pairs 1/3 swapped for routability
RGMII ref plane changing caps

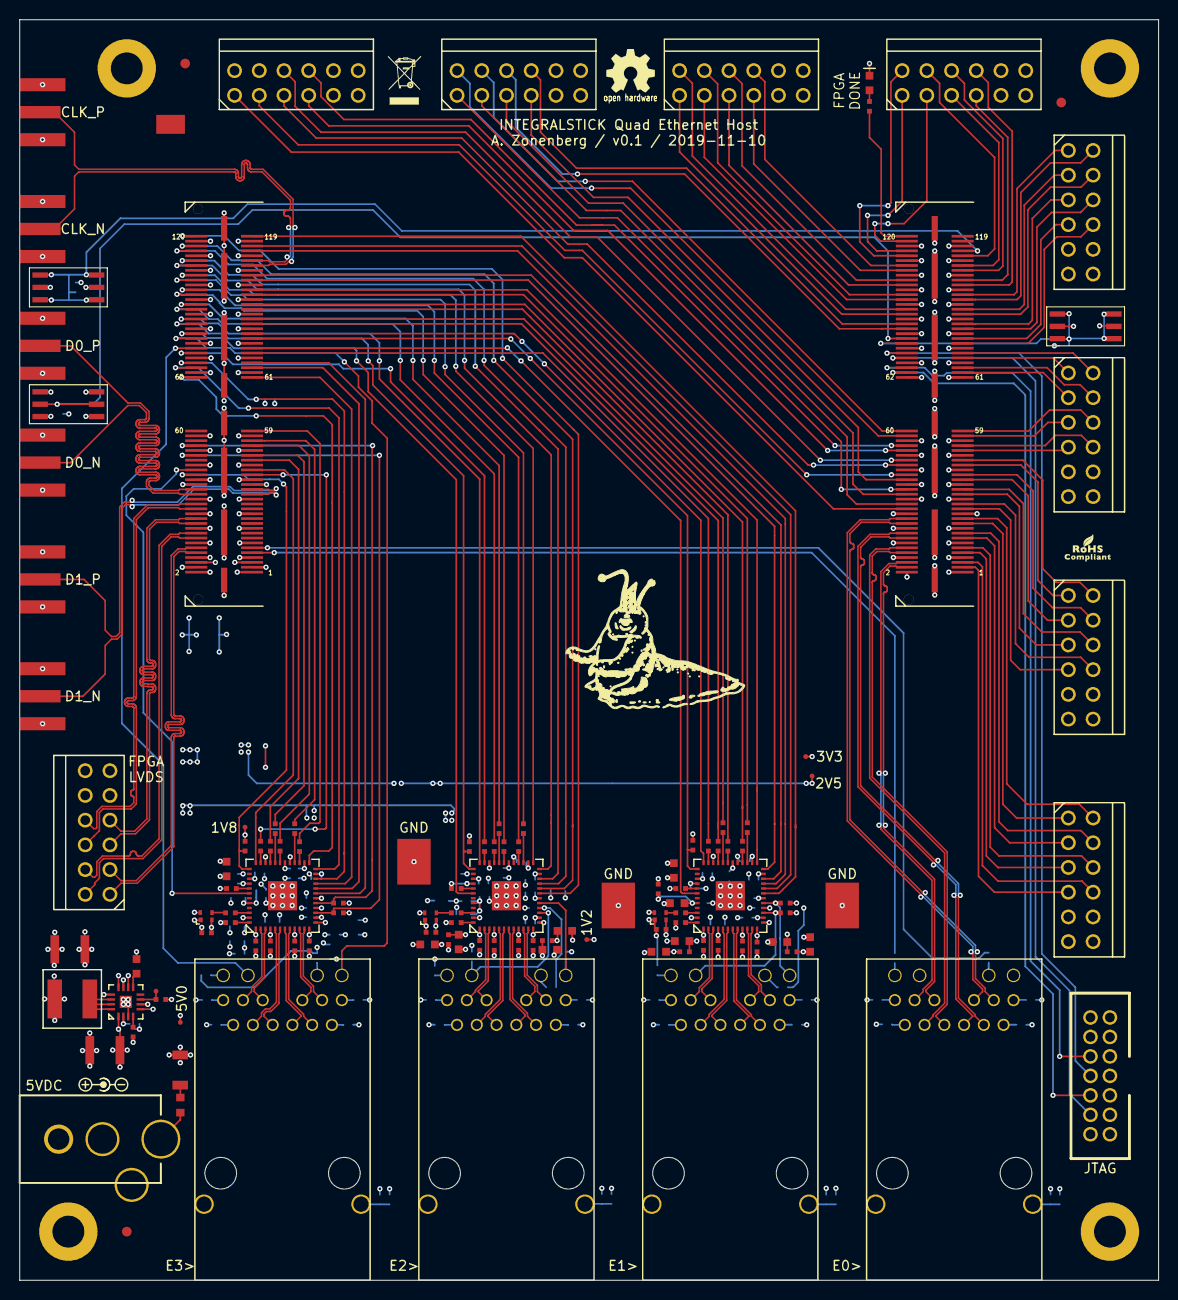
[picture p6: board host-full.kicad_pcb from above]

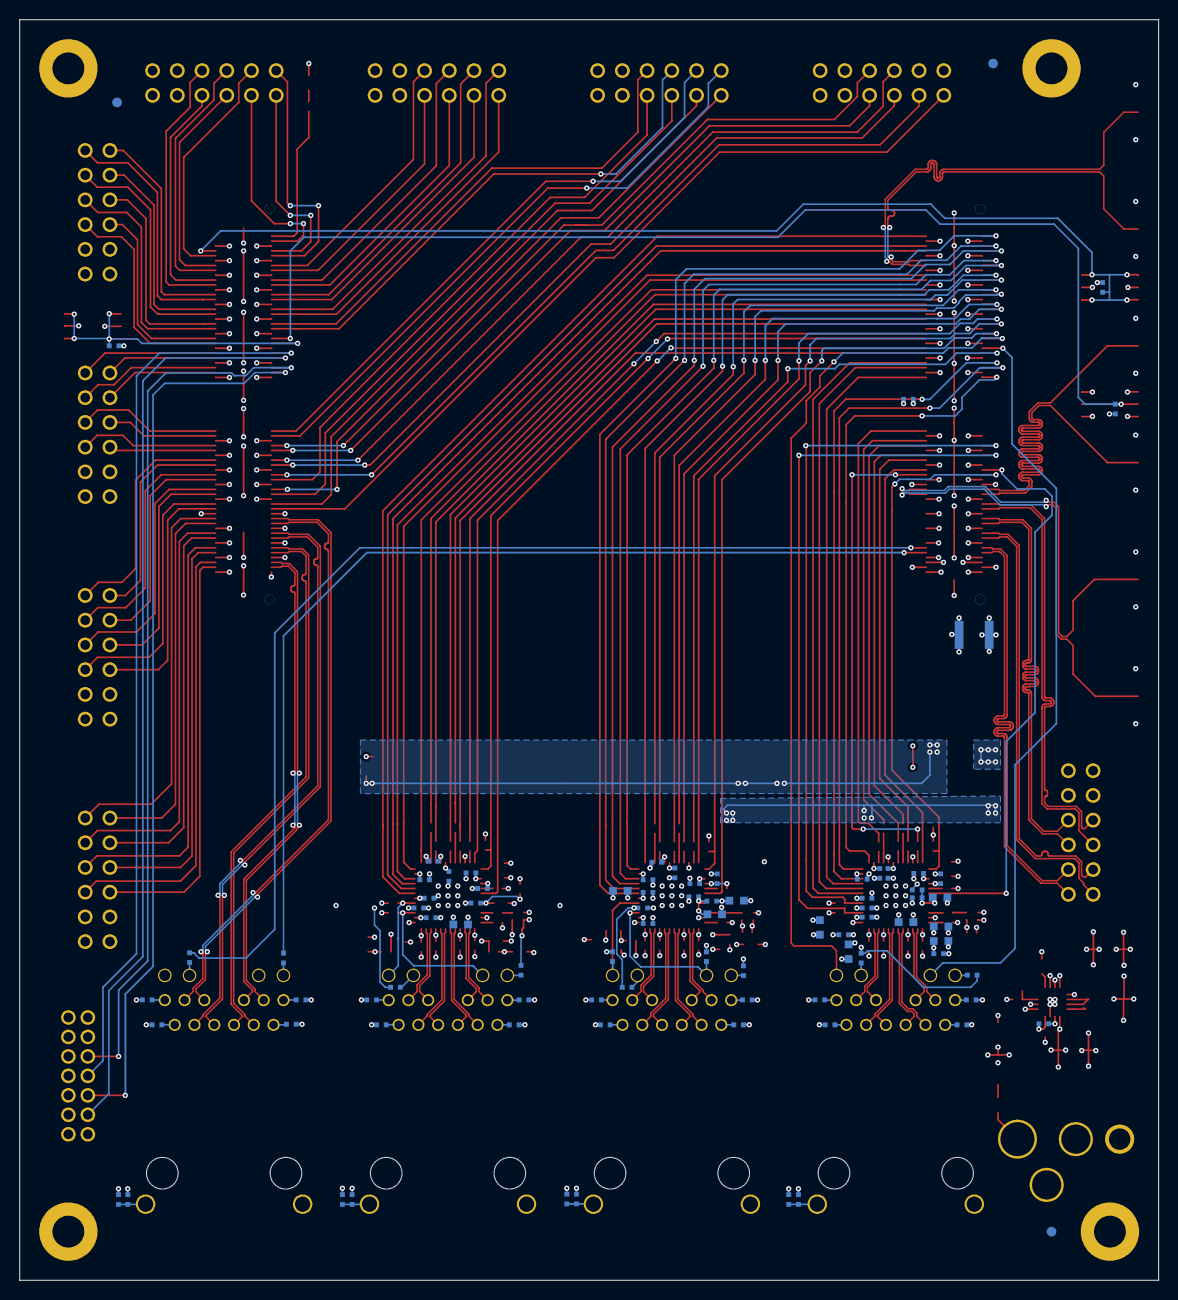
[picture p7: board host-full.kicad_pcb from below]

Board: 4 copper layers, 117.0 x 129.5 mm, 204 parts (84 on the bottom side), 251 nets.

Other parts of the board:
FIDUCIAL_1MM, FIDUCIAL_1MM#2, FIDUCIAL_1MM#3, FIDUCIAL_1MM#4, FIDUCIAL_1MM#5, FIDUCIAL_1MM#6: VAL**; FIDUCIAL_1MM
