azonenberg/integralstick/mintest-right/mintest-right.kicad_pcb

## KiCad design mintest-right/mintest-right.kicad_pcb (2019-01-11)

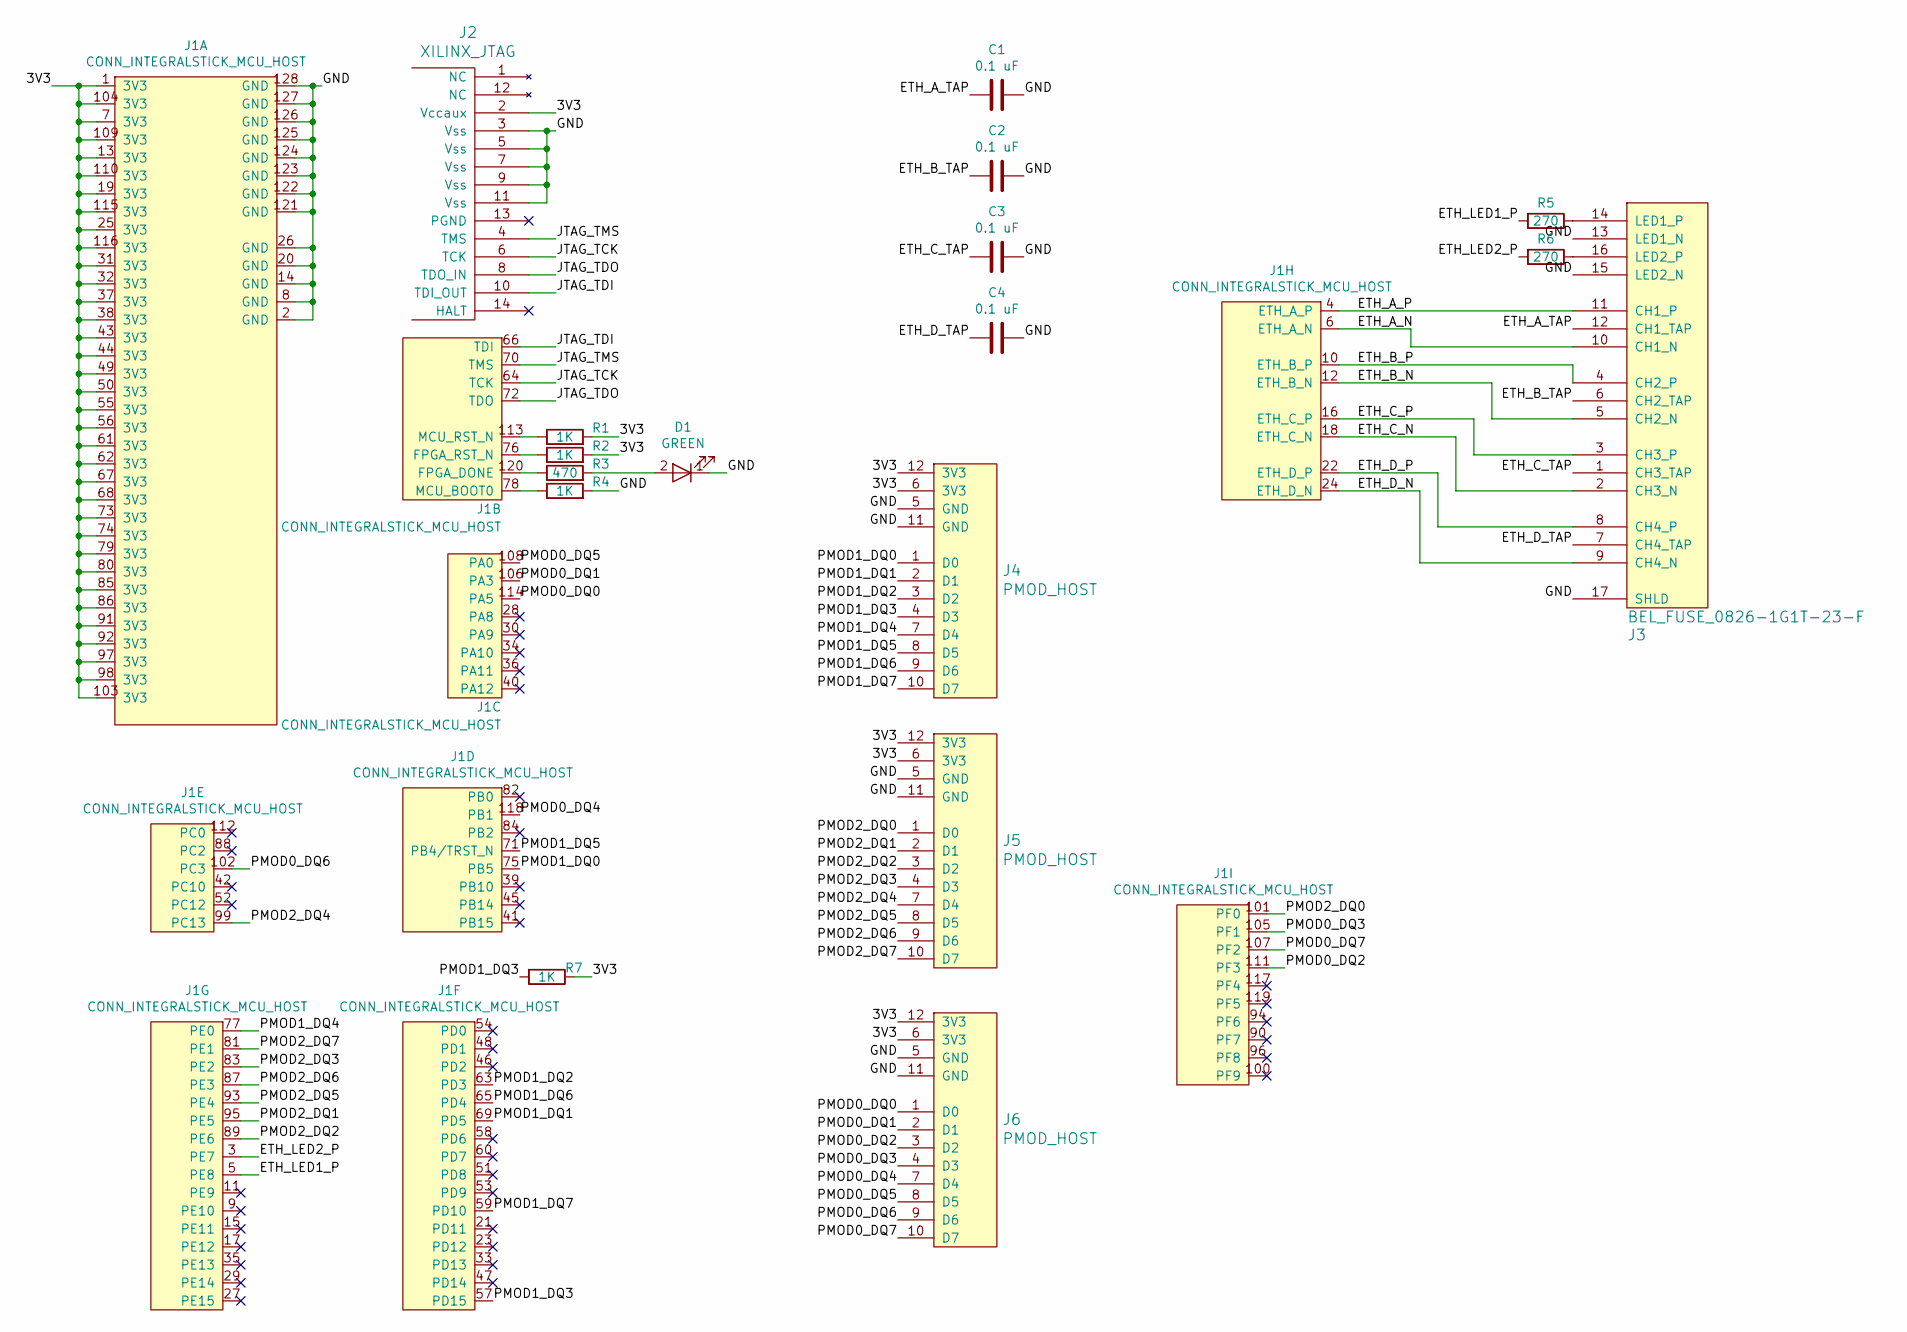
[picture p8: schematic mintest-right.sch, INTEGRALSTICK Minimal Right Breakout]

Parts:
C1, C2, C3, C4: 0.1 uF; EIA_0402_CAP_NOSILK
D1: GREEN; EIA_0603_LED
J1: CONN_INTEGRALSTICK_MCU_HOST; CONN_SAMTEC_QSH-060-01-L-D-A
J2: XILINX_JTAG; XILINX_JTAG_PTH_MOLEX_0878311420
J3: BEL_FUSE_0826-1G1T-23-F; CONN_BELFUSE_0826_1G1T_23_F
J4, J5, J6: PMOD_HOST; CONN_HEADER_2.54MM_2x6_RA_PMOD_HOST
R1, R2, R4, R7: 1K; EIA_0402_RES_NOSILK
R3: 470; EIA_0402_RES_NOSILK
R5, R6: 270; EIA_0402_RES_NOSILK

Connections:
/3V3: J1.1 (3V3), J1.7 (3V3), J1.13 (3V3), J1.19 (3V3), J1.25 (3V3), J1.31 (3V3), J1.32 (3V3), J1.37 (3V3), J1.38 (3V3), J1.43 (3V3), J1.44 (3V3), J1.49 (3V3), J1.50 (3V3), J1.55 (3V3), J1.56 (3V3), J1.61 (3V3), J1.62 (3V3), J1.67 (3V3), J1.68 (3V3), J1.73 (3V3), J1.74 (3V3), J1.79 (3V3), J1.80 (3V3), J1.85 (3V3), J1.86 (3V3), J1.91 (3V3), J1.92 (3V3), J1.97 (3V3), J1.98 (3V3), J1.103 (3V3), J1.104 (3V3), J1.109 (3V3), J1.110 (3V3), J1.115 (3V3), J1.116 (3V3), J2.2 (Vccaux), J4.6 (3V3), J4.12 (3V3), J5.6 (3V3), J5.12 (3V3), J6.6 (3V3), J6.12 (3V3), R1.2, R2.2, R7.1
/ETH_A_N: J1.6 (ETH_A_N), J3.10 (CH1_N)
/ETH_A_P: J1.4 (ETH_A_P), J3.11 (CH1_P)
/ETH_A_TAP: C1.2, J3.12 (CH1_TAP)
/ETH_B_N: J1.12 (ETH_B_N), J3.5 (CH2_N)
/ETH_B_P: J1.10 (ETH_B_P), J3.4 (CH2_P)
/ETH_B_TAP: C2.2, J3.6 (CH2_TAP)
/ETH_C_N: J1.18 (ETH_C_N), J3.2 (CH3_N)
/ETH_C_P: J1.16 (ETH_C_P), J3.3 (CH3_P)
/ETH_C_TAP: C3.2, J3.1 (CH3_TAP)
/ETH_D_N: J1.24 (ETH_D_N), J3.9 (CH4_N)
/ETH_D_P: J1.22 (ETH_D_P), J3.8 (CH4_P)
/ETH_D_TAP: C4.2, J3.7 (CH4_TAP)
/ETH_LED1_P: J1.5 (PE8), R5.2
/ETH_LED2_P: J1.3 (PE7), R6.2
/GND: C1.1, C2.1, C3.1, C4.1, D1.1 (K), J1.2 (GND), J1.8 (GND), J1.14 (GND), J1.20 (GND), J1.26 (GND), J1.121 (GND), J1.122 (GND), J1.123 (GND), J1.124 (GND), J1.125 (GND), J1.126 (GND), J1.127 (GND), J1.128 (GND), J2.3 (Vss), J2.5 (Vss), J2.7 (Vss), J2.9 (Vss), J2.11 (Vss), J3.13 (LED1_N), J3.15 (LED2_N), J3.17 (SHLD), J4.5 (GND), J4.11 (GND), J5.5 (GND), J5.11 (GND), J6.5 (GND), J6.11 (GND), R4.2
/JTAG_TCK: J1.64 (TCK), J2.6 (TCK)
/JTAG_TDI: J1.66 (TDI), J2.10 (TDI_OUT)
/JTAG_TDO: J1.72 (TDO), J2.8 (TDO_IN)
/JTAG_TMS: J1.70 (TMS), J2.4 (TMS)
/PMOD0_DQ0: J1.114 (PA5), J6.1 (D0)
/PMOD0_DQ1: J1.106 (PA3), J6.2 (D1)
/PMOD0_DQ2: J1.111 (PF3), J6.3 (D2)
/PMOD0_DQ3: J1.105 (PF1), J6.4 (D3)
/PMOD0_DQ4: J1.118 (PB1), J6.7 (D4)
/PMOD0_DQ5: J1.108 (PA0), J6.8 (D5)
/PMOD0_DQ6: J1.102 (PC3), J6.9 (D6)
/PMOD0_DQ7: J1.107 (PF2), J6.10 (D7)
/PMOD1_DQ0: J1.75 (PB5), J4.1 (D0)
/PMOD1_DQ1: J1.69 (PD5), J4.2 (D1)
/PMOD1_DQ2: J1.63 (PD3), J4.3 (D2)
/PMOD1_DQ3: J1.57 (PD15), J4.4 (D3), R7.2
/PMOD1_DQ4: J1.77 (PE0), J4.7 (D4)
/PMOD1_DQ5: J1.71 (PB4/TRST_N), J4.8 (D5)
/PMOD1_DQ6: J1.65 (PD4), J4.9 (D6)
/PMOD1_DQ7: J1.59 (PD10), J4.10 (D7)
/PMOD2_DQ0: J1.101 (PF0), J5.1 (D0)
/PMOD2_DQ1: J1.95 (PE5), J5.2 (D1)
/PMOD2_DQ2: J1.89 (PE6), J5.3 (D2)
/PMOD2_DQ3: J1.83 (PE2), J5.4 (D3)
/PMOD2_DQ4: J1.99 (PC13), J5.7 (D4)
/PMOD2_DQ5: J1.93 (PE4), J5.8 (D5)
/PMOD2_DQ6: J1.87 (PE3), J5.9 (D6)
/PMOD2_DQ7: J1.81 (PE1), J5.10 (D7)
unnamed: D1.2 (A), R3.2
unnamed: J1.76 (FPGA_RST_N), R2.1
unnamed: J1.78 (MCU_BOOT0), R4.1
unnamed: J1.113 (MCU_RST_N), R1.1
unnamed: J1.120 (FPGA_DONE), R3.1
unnamed: J3.14 (LED1_P), R5.1
unnamed: J3.16 (LED2_P), R6.1

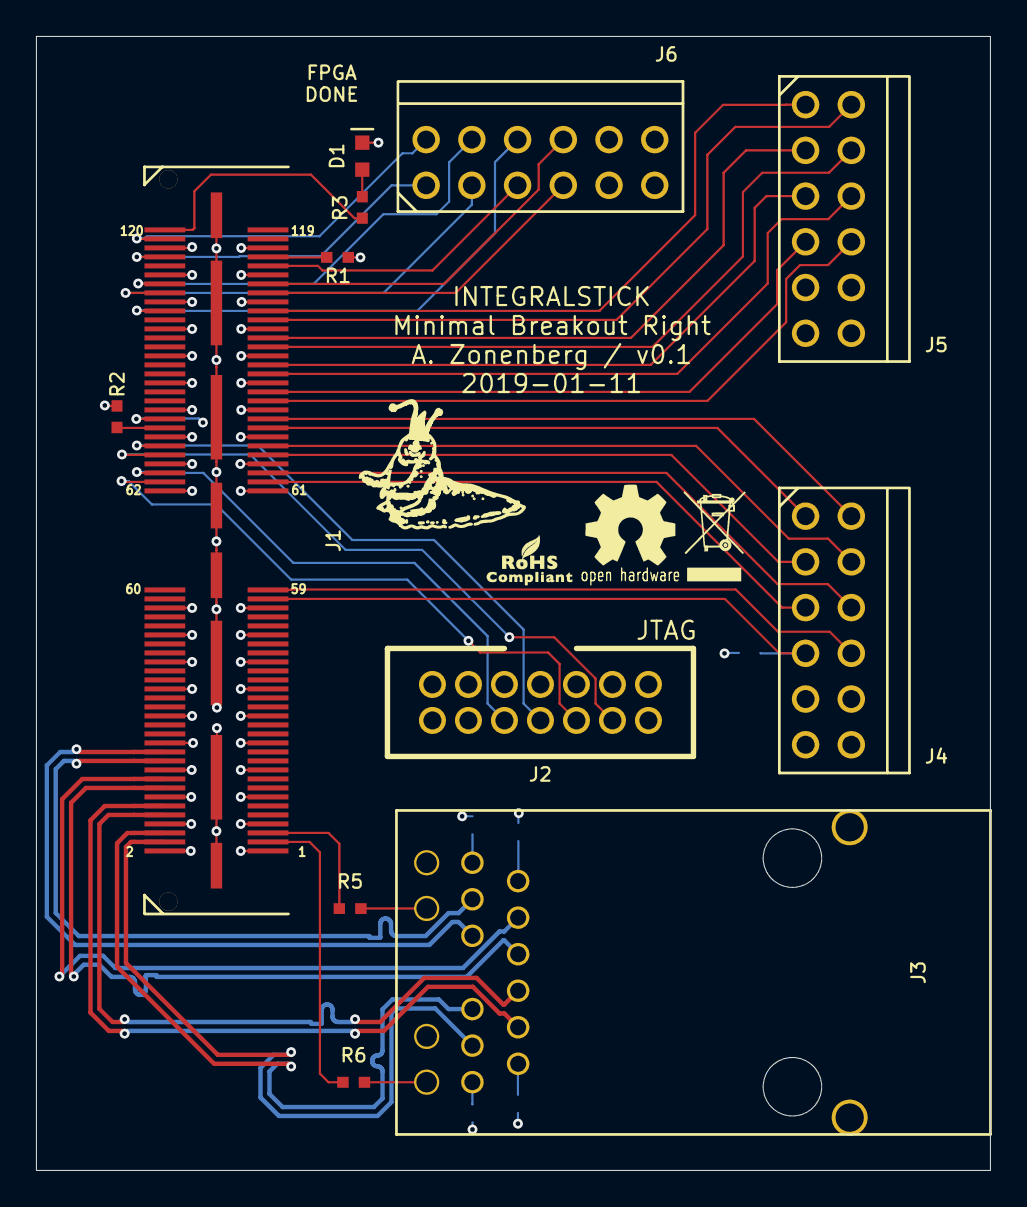
[picture p9: board mintest-right.kicad_pcb from above]

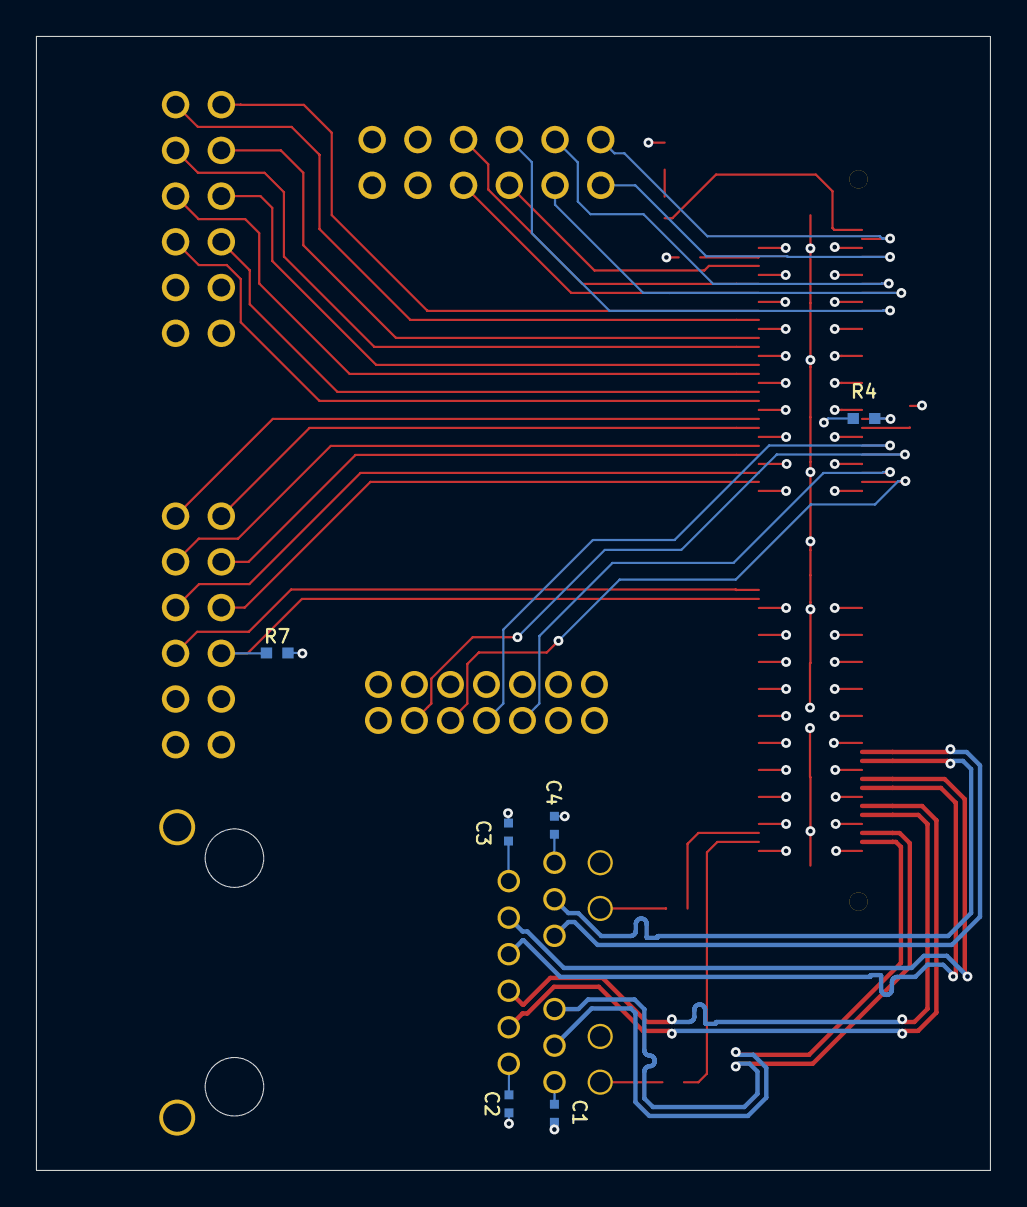
[picture p10: board mintest-right.kicad_pcb from below]

Board: 4 copper layers, 53.0 x 63.0 mm, 18 parts (6 on the bottom side), 51 nets.
