azonenberg/integralstick/mintest-left/mintest-left.kicad_pcb

## KiCad design mintest-left/mintest-left.kicad_pcb (2019-01-11)

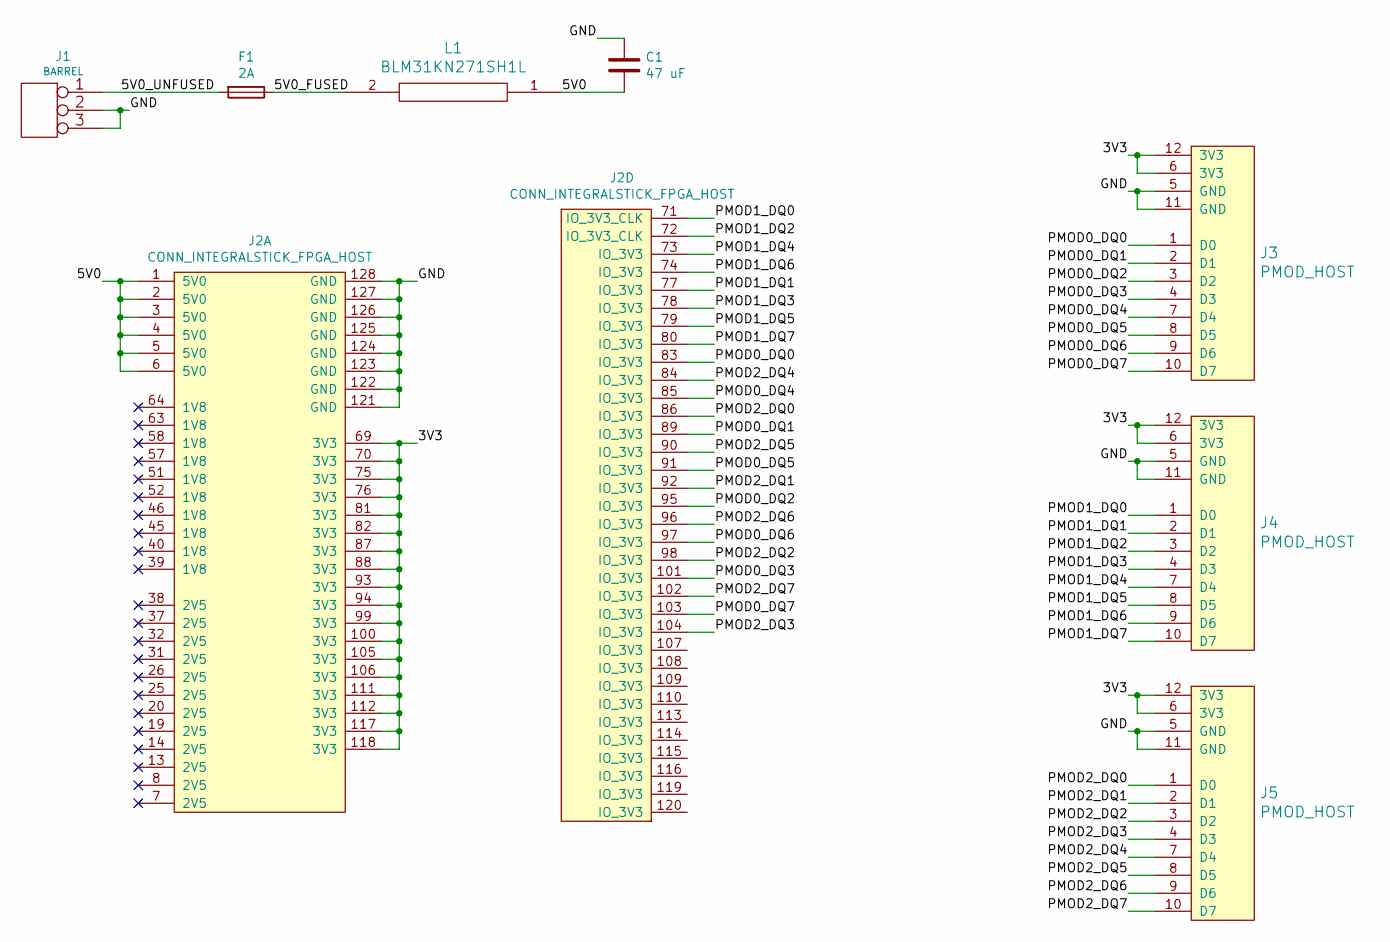
[picture p11: schematic mintest-left.sch, INTEGRALSTICK Minimal Left Breakout]

Parts:
C1: 47 uF; EIA_1210_CAP_NOSILK
F1: 2A; EIA_0603_CAP_NOSILK
J1: BARREL; CONN_CUI_PJ-058BH_HIPWR_BARREL_NOSLOT
J2: CONN_INTEGRALSTICK_FPGA_HOST; CONN_SAMTEC_QSH-060-01-L-D-A
J3, J4, J5: PMOD_HOST; CONN_HEADER_2.54MM_2x6_RA_PMOD_HOST
L1: BLM31KN271SH1L; EIA_1206_CAP_NOSILK

Connections:
/3V3: J2.69 (3V3), J2.70 (3V3), J2.75 (3V3), J2.76 (3V3), J2.81 (3V3), J2.82 (3V3), J2.87 (3V3), J2.88 (3V3), J2.93 (3V3), J2.94 (3V3), J2.99 (3V3), J2.100 (3V3), J2.105 (3V3), J2.106 (3V3), J2.111 (3V3), J2.112 (3V3), J2.117 (3V3), J2.118 (3V3), J3.6 (3V3), J3.12 (3V3), J4.6 (3V3), J4.12 (3V3), J5.6 (3V3), J5.12 (3V3)
/5V0: C1.2, J2.1 (5V0), J2.2 (5V0), J2.3 (5V0), J2.4 (5V0), J2.5 (5V0), J2.6 (5V0), L1.1
/5V0_FUSED: F1.1, L1.2
/5V0_UNFUSED: F1.2, J1.1
/GND: C1.1, J1.2 (PM), J1.3, J2.121 (GND), J2.122 (GND), J2.123 (GND), J2.124 (GND), J2.125 (GND), J2.126 (GND), J2.127 (GND), J2.128 (GND), J3.5 (GND), J3.11 (GND), J4.5 (GND), J4.11 (GND), J5.5 (GND), J5.11 (GND)
/PMOD0_DQ0: J2.83 (IO_3V3), J3.1 (D0)
/PMOD0_DQ1: J2.89 (IO_3V3), J3.2 (D1)
/PMOD0_DQ2: J2.95 (IO_3V3), J3.3 (D2)
/PMOD0_DQ3: J2.101 (IO_3V3), J3.4 (D3)
/PMOD0_DQ4: J2.85 (IO_3V3), J3.7 (D4)
/PMOD0_DQ5: J2.91 (IO_3V3), J3.8 (D5)
/PMOD0_DQ6: J2.97 (IO_3V3), J3.9 (D6)
/PMOD0_DQ7: J2.103 (IO_3V3), J3.10 (D7)
/PMOD1_DQ0: J2.71 (IO_3V3_CLK), J4.1 (D0)
/PMOD1_DQ1: J2.77 (IO_3V3), J4.2 (D1)
/PMOD1_DQ2: J2.72 (IO_3V3_CLK), J4.3 (D2)
/PMOD1_DQ3: J2.78 (IO_3V3), J4.4 (D3)
/PMOD1_DQ4: J2.73 (IO_3V3), J4.7 (D4)
/PMOD1_DQ5: J2.79 (IO_3V3), J4.8 (D5)
/PMOD1_DQ6: J2.74 (IO_3V3), J4.9 (D6)
/PMOD1_DQ7: J2.80 (IO_3V3), J4.10 (D7)
/PMOD2_DQ0: J2.86 (IO_3V3), J5.1 (D0)
/PMOD2_DQ1: J2.92 (IO_3V3), J5.2 (D1)
/PMOD2_DQ2: J2.98 (IO_3V3), J5.3 (D2)
/PMOD2_DQ3: J2.104 (IO_3V3), J5.4 (D3)
/PMOD2_DQ4: J2.84 (IO_3V3), J5.7 (D4)
/PMOD2_DQ5: J2.90 (IO_3V3), J5.8 (D5)
/PMOD2_DQ6: J2.96 (IO_3V3), J5.9 (D6)
/PMOD2_DQ7: J2.102 (IO_3V3), J5.10 (D7)

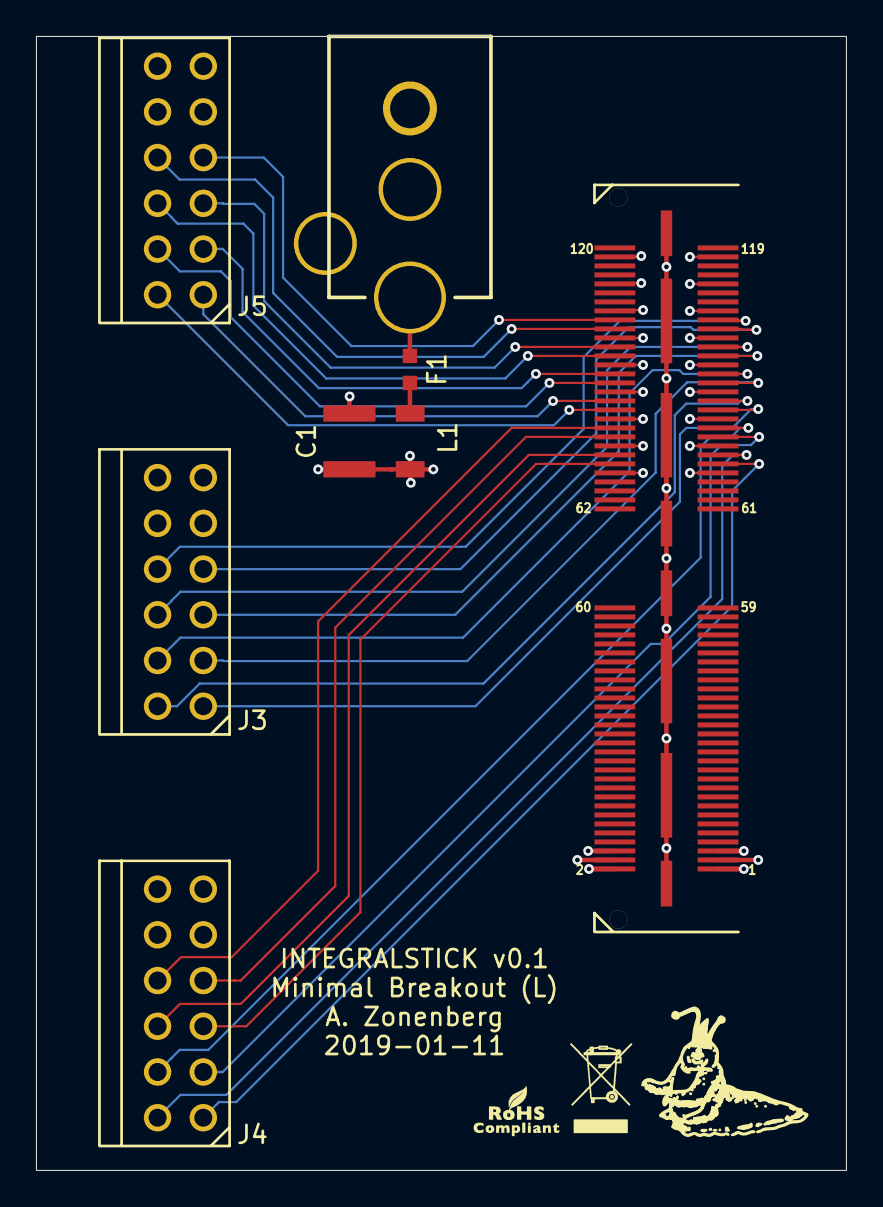
[picture p12: board mintest-left.kicad_pcb from above]

Board: 4 copper layers, 45.0 x 63.0 mm, 8 parts (0 on the bottom side), 29 nets.
