azonenberg/integralstick/pcb/integralstick.kicad_pcb

## KiCad design pcb/integralstick.kicad_pcb (2018-12-03)

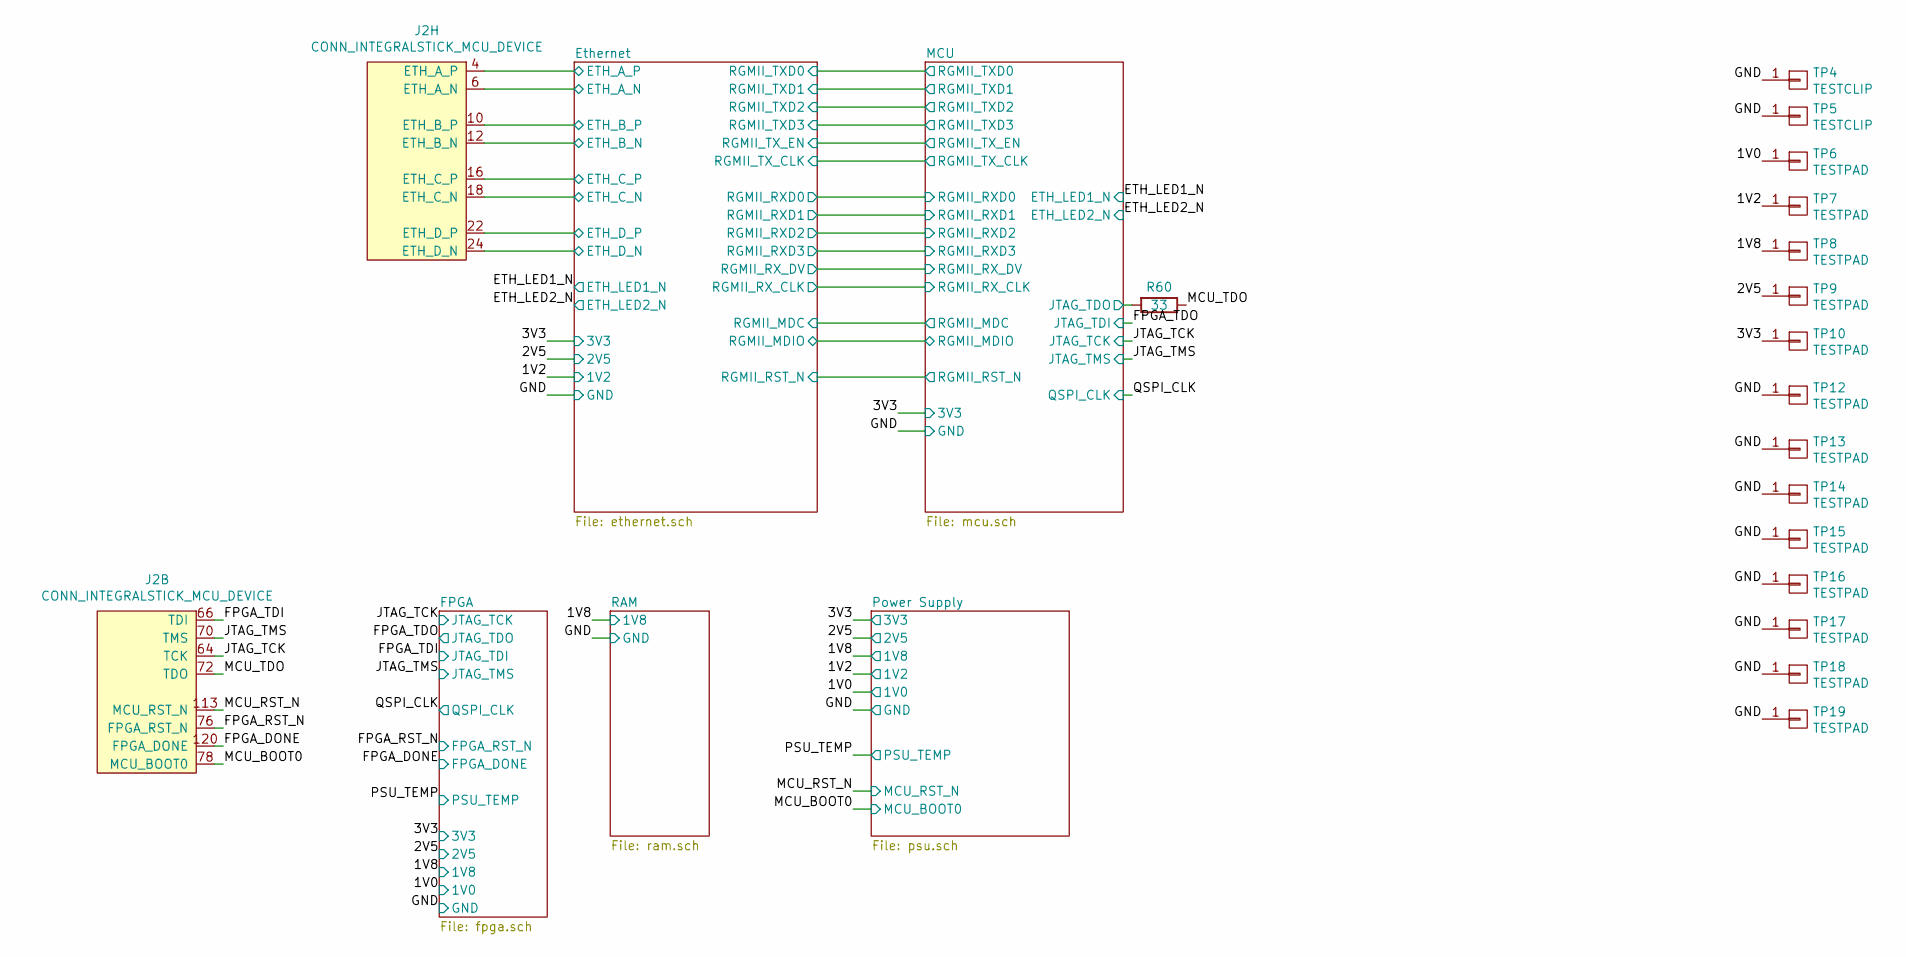
[picture p13: schematic integralstick.sch, INTEGRALSTICK Compute Module]

Parts:
J2: CONN_INTEGRALSTICK_MCU_DEVICE; CONN_SAMTEC_QTH-060-01-L-D-A
R60: 33; EIA_0402_RES_NOSILK
TP4, TP5: TESTCLIP; TESTPOINT_SMT_KEYSTONE_5016
TP6, TP7, TP8, TP9, TP10: TESTPAD; TESTPOINT_SMT_0.5MM
TP12, TP13, TP14, TP15, TP16, TP17, TP18, TP19: TESTPAD; TESTPOINT_BARETRACE_328UM

Connections:
/1V0: TP6.1; also elsewhere on the board
/1V2: TP7.1; also elsewhere on the board
/1V8: TP8.1; also elsewhere on the board
/2V5: TP9.1; also elsewhere on the board
/3V3: TP10.1; also elsewhere on the board
/Ethernet/ETH_A_N: J2.6 (ETH_A_N); also elsewhere on the board
/Ethernet/ETH_A_P: J2.4 (ETH_A_P); also elsewhere on the board
/Ethernet/ETH_B_N: J2.12 (ETH_B_N); also elsewhere on the board
/Ethernet/ETH_B_P: J2.10 (ETH_B_P); also elsewhere on the board
/Ethernet/ETH_C_N: J2.18 (ETH_C_N); also elsewhere on the board
/Ethernet/ETH_C_P: J2.16 (ETH_C_P); also elsewhere on the board
/Ethernet/ETH_D_N: J2.24 (ETH_D_N); also elsewhere on the board
/Ethernet/ETH_D_P: J2.22 (ETH_D_P); also elsewhere on the board
/FPGA_DONE: J2.120 (FPGA_DONE); also elsewhere on the board
/FPGA_RST_N: J2.76 (FPGA_RST_N); also elsewhere on the board
/FPGA_TDI: J2.66 (TDI); also elsewhere on the board
/GND: TP4.1, TP5.1, TP12.1, TP13.1, TP14.1, TP15.1, TP16.1, TP17.1, TP18.1, TP19.1; also elsewhere on the board
/JTAG_TCK: J2.64 (TCK); also elsewhere on the board
/JTAG_TMS: J2.70 (TMS); also elsewhere on the board
/MCU/JTAG_TDO: R60.2; also elsewhere on the board
/MCU_BOOT0: J2.78 (MCU_BOOT0); also elsewhere on the board
/MCU_RST_N: J2.113 (MCU_RST_N); also elsewhere on the board
/MCU_TDO: J2.72 (TDO), R60.1

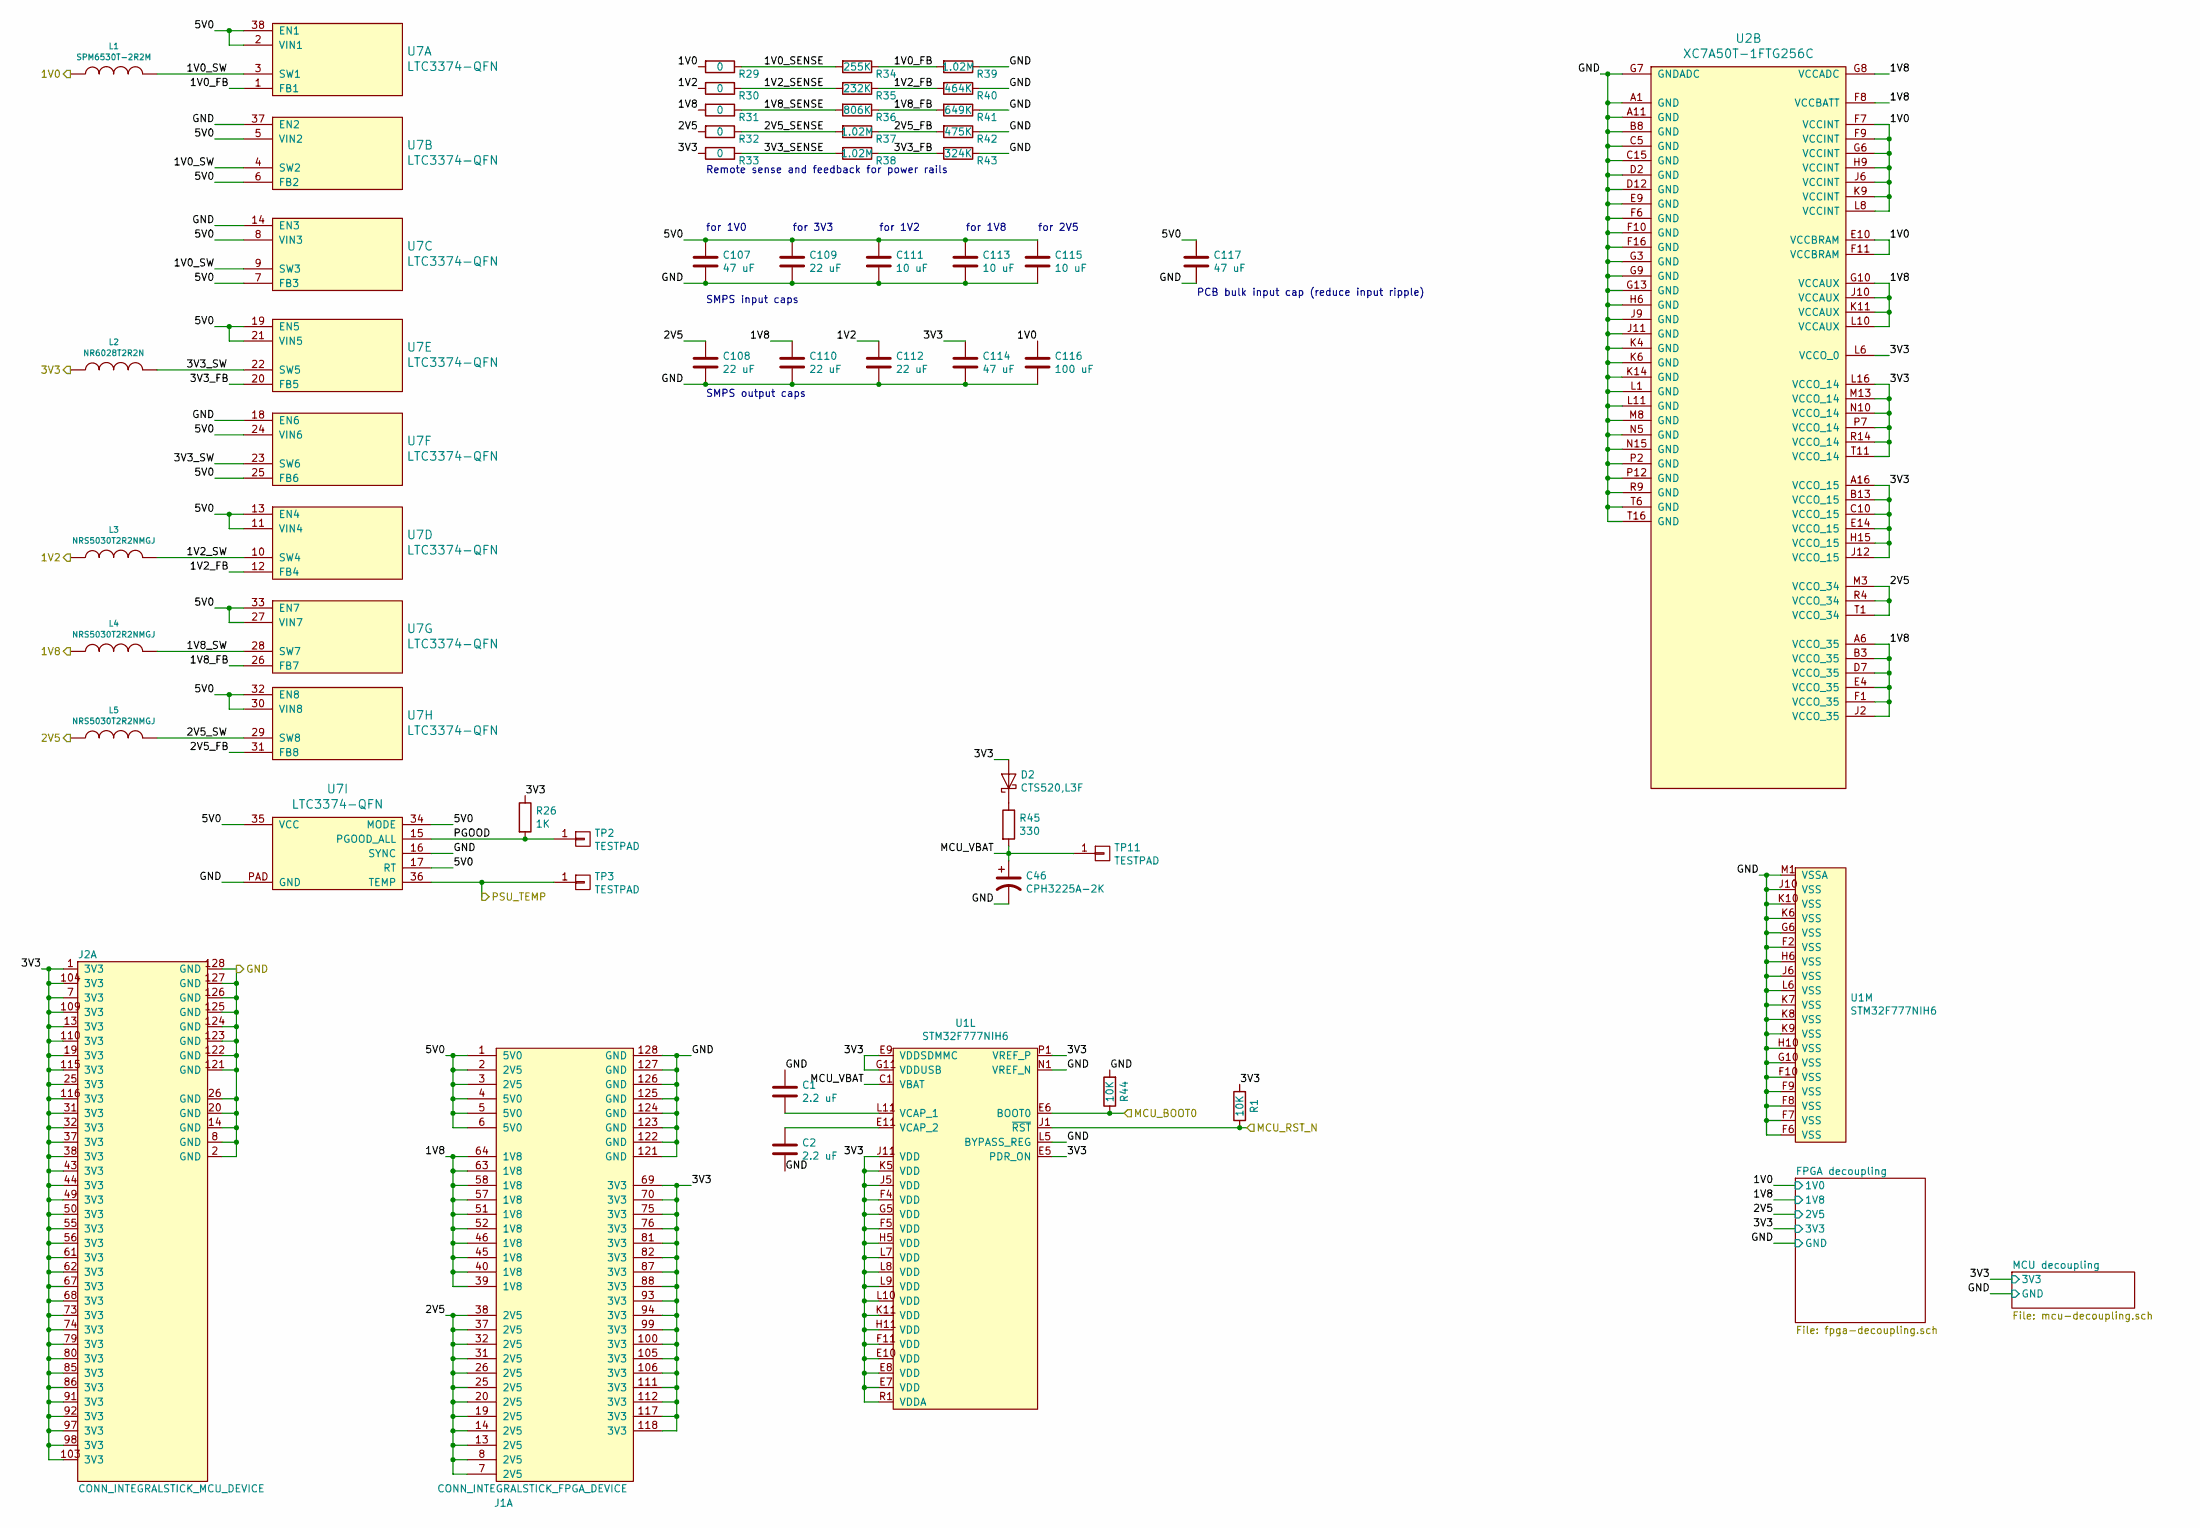
[picture p14: schematic psu.sch, INTEGRALSTICK Compute Module]

Parts:
C1, C2: 2.2 uF; EIA_0603_CAP_NOSILK
C46: CPH3225A-2K; CAP_SEIKO_CPH3225A
C107, C114, C117: 47 uF; EIA_1210_CAP_NOSILK
C108, C109, C110, C112: 22 uF; EIA_1206_CAP_NOSILK
C111, C113, C115: 10 uF; EIA_1206_CAP_NOSILK
C116: 100 uF; EIA_1210_CAP_NOSILK
D2: CTS520,L3F‎; SOD882
J1: CONN_INTEGRALSTICK_FPGA_DEVICE; CONN_SAMTEC_QTH-060-01-L-D-A
J2: CONN_INTEGRALSTICK_MCU_DEVICE; CONN_SAMTEC_QTH-060-01-L-D-A
L1: SPM6530T-2R2M; INDUCTOR_TDK_SPM6530
L2: NR6028T2R2N; INDUCTOR_YUDEN_NR6028
L3, L4, L5: NRS5030T2R2NMGJ; INDUCTOR_YUDEN_NRS5030
R1, R44: 10K; EIA_0402_RES_NOSILK
R26: 1K; EIA_0402_RES_NOSILK
R29, R30, R31, R32, R33: 0; EIA_0402_RES_NOSILK
R34: 255K; EIA_0402_RES_NOSILK
R35: 232K; EIA_0402_RES_NOSILK
R36: 806K; EIA_0402_RES_NOSILK
R37, R38, R39: 1.02M; EIA_0402_RES_NOSILK
R40: 464K; EIA_0402_RES_NOSILK
R41: 649K; EIA_0402_RES_NOSILK
R42: 475K; EIA_0402_RES_NOSILK
R43: 324K; EIA_0402_RES_NOSILK
R45: 330; EIA_0402_RES_NOSILK
TP2, TP3, TP11: TESTPAD; TESTPOINT_SMT_0.5MM
U1: STM32F777NIH6‎; BGA_216_13x13_DEPOP3x3_0.8MM
U2: XC7A50T-1FTG256C; BGA_256_17x17_FULLARRAY_1MM_0.4MM_FTG256
U7: LTC3374-QFN; QFN_38_0.5MM_5x7MM

Connections:
/1V0: C116.1, L1.1, R29.2, U2.E10 (VCCBRAM), U2.F7 (VCCINT), U2.F9 (VCCINT), U2.F11 (VCCBRAM), U2.G6 (VCCINT), U2.H9 (VCCINT), U2.J6 (VCCINT), U2.K9 (VCCINT), U2.L8 (VCCINT); also elsewhere on the board
/1V2: C112.1, L3.1, R30.2; also elsewhere on the board
/1V8: C110.1, J1.39 (1V8), J1.40 (1V8), J1.45 (1V8), J1.46 (1V8), J1.51 (1V8), J1.52 (1V8), J1.57 (1V8), J1.58 (1V8), J1.63 (1V8), J1.64 (1V8), L4.1, R31.2, U2.A6 (VCCO_35), U2.B3 (VCCO_35), U2.D7 (VCCO_35), U2.E4 (VCCO_35), U2.F1 (VCCO_35), U2.F8 (VCCBATT), U2.G8 (VCCADC), U2.G10 (VCCAUX), U2.J2 (VCCO_35), U2.J10 (VCCAUX), U2.K11 (VCCAUX), U2.L10 (VCCAUX); also elsewhere on the board
/2V5: C108.1, J1.7 (2V5), J1.8 (2V5), J1.13 (2V5), J1.14 (2V5), J1.19 (2V5), J1.20 (2V5), J1.25 (2V5), J1.26 (2V5), J1.31 (2V5), J1.32 (2V5), J1.37 (2V5), J1.38 (2V5), L5.1, R32.2, U2.M3 (VCCO_34), U2.R4 (VCCO_34), U2.T1 (VCCO_34); also elsewhere on the board
/3V3: C114.1, D2.2 (A), J1.69 (3V3), J1.70 (3V3), J1.75 (3V3), J1.76 (3V3), J1.81 (3V3), J1.82 (3V3), J1.87 (3V3), J1.88 (3V3), J1.93 (3V3), J1.94 (3V3), J1.99 (3V3), J1.100 (3V3), J1.105 (3V3), J1.106 (3V3), J1.111 (3V3), J1.112 (3V3), J1.117 (3V3), J1.118 (3V3), J2.1 (3V3), J2.7 (3V3), J2.13 (3V3), J2.19 (3V3), J2.25 (3V3), J2.31 (3V3), J2.32 (3V3), J2.37 (3V3), J2.38 (3V3), J2.43 (3V3), J2.44 (3V3), J2.49 (3V3), J2.50 (3V3), J2.55 (3V3), J2.56 (3V3), J2.61 (3V3), J2.62 (3V3), J2.67 (3V3), J2.68 (3V3), J2.73 (3V3), J2.74 (3V3), J2.79 (3V3), J2.80 (3V3), J2.85 (3V3), J2.86 (3V3), J2.91 (3V3), J2.92 (3V3), J2.97 (3V3), J2.98 (3V3), J2.103 (3V3), J2.104 (3V3), J2.109 (3V3), J2.110 (3V3), J2.115 (3V3), J2.116 (3V3), L2.1, R1.2, R26.1, R33.2, U1.E5 (PDR_ON), U1.E7 (VDD), U1.E8 (VDD), U1.E9 (VDDSDMMC), U1.E10 (VDD), U1.F4 (VDD), U1.F5 (VDD), U1.F11 (VDD), U1.G5 (VDD), U1.G11 (VDDUSB), U1.H5 (VDD), U1.H11 (VDD), U1.J5 (VDD), U1.J11 (VDD), U1.K5 (VDD), U1.K11 (VDD), U1.L7 (VDD), U1.L8 (VDD), U1.L9 (VDD), U1.L10 (VDD), U1.P1 (VREF_P), U1.R1 (VDDA), U2.A16 (VCCO_15), U2.B13 (VCCO_15), U2.C10 (VCCO_15), U2.E14 (VCCO_15), U2.H15 (VCCO_15), U2.J12 (VCCO_15), U2.L6 (VCCO_0), U2.L16 (VCCO_14), U2.M13 (VCCO_14), U2.N10 (VCCO_14), U2.P7 (VCCO_14), U2.R14 (VCCO_14), U2.T11 (VCCO_14); also elsewhere on the board
/GND: C1.1, C2.2, C46.2, C107.2, C108.2, C109.2, C110.2, C111.2, C112.2, C113.2, C114.2, C115.2, C116.2, C117.2, J1.121 (GND), J1.122 (GND), J1.123 (GND), J1.124 (GND), J1.125 (GND), J1.126 (GND), J1.127 (GND), J1.128 (GND), J2.2 (GND), J2.8 (GND), J2.14 (GND), J2.20 (GND), J2.26 (GND), J2.121 (GND), J2.122 (GND), J2.123 (GND), J2.124 (GND), J2.125 (GND), J2.126 (GND), J2.127 (GND), J2.128 (GND), R39.1, R40.1, R41.1, R42.1, R43.1, R44.2, U1.F2 (VSS), U1.F6 (VSS), U1.F7 (VSS), U1.F8 (VSS), U1.F9 (VSS), U1.F10 (VSS), U1.G6 (VSS), U1.G10 (VSS), U1.H6 (VSS), U1.H10 (VSS), U1.J6 (VSS), U1.J10 (VSS), U1.K6 (VSS), U1.K7 (VSS), U1.K8 (VSS), U1.K9 (VSS), U1.K10 (VSS), U1.L5 (BYPASS_REG), U1.L6 (VSS), U1.M1 (VSSA), U1.N1 (VREF_N), U2.A1 (GND), U2.A11 (GND), U2.B8 (GND), U2.C5 (GND), U2.C15 (GND), U2.D2 (GND), U2.D12 (GND), U2.E9 (GND), U2.F6 (GND), U2.F10 (GND), U2.F16 (GND), U2.G3 (GND), U2.G7 (GNDADC), U2.G9 (GND), U2.G13 (GND), U2.H6 (GND), U2.J9 (GND), U2.J11 (GND), U2.K4 (GND), U2.K6 (GND), U2.K14 (GND), U2.L1 (GND), U2.L11 (GND), U2.M8 (GND), U2.N5 (GND), U2.N15 (GND), U2.P2 (GND), U2.P12 (GND), U2.R9 (GND), U2.T6 (GND), U2.T16 (GND), U7.14 (EN3), U7.16 (SYNC), U7.18 (EN6), U7.37 (EN2), U7.PAD (GND); also elsewhere on the board
/MCU_BOOT0: R44.1, U1.E6 (BOOT0); also elsewhere on the board
/MCU_RST_N: R1.1, U1.J1 (~RST); also elsewhere on the board
/PSU_TEMP: TP3.1, U7.36 (TEMP); also elsewhere on the board
/Power Supply/1V0_FB: R34.1, R39.2, U7.1 (FB1)
/Power Supply/1V0_SENSE: R29.1, R34.2
/Power Supply/1V0_SW: L1.2, U7.3 (SW1), U7.4 (SW2), U7.9 (SW3)
/Power Supply/1V2_FB: R35.1, R40.2, U7.12 (FB4)
/Power Supply/1V2_SENSE: R30.1, R35.2
/Power Supply/1V2_SW: L3.2, U7.10 (SW4)
/Power Supply/1V8_FB: R36.1, R41.2, U7.26 (FB7)
/Power Supply/1V8_SENSE: R31.1, R36.2
/Power Supply/1V8_SW: L4.2, U7.28 (SW7)
/Power Supply/2V5_FB: R37.1, R42.2, U7.31 (FB8)
/Power Supply/2V5_SENSE: R32.1, R37.2
/Power Supply/2V5_SW: L5.2, U7.29 (SW8)
/Power Supply/3V3_FB: R38.1, R43.2, U7.20 (FB5)
/Power Supply/3V3_SENSE: R33.1, R38.2
/Power Supply/3V3_SW: L2.2, U7.22 (SW5), U7.23 (SW6)
/Power Supply/5V0: C107.1, C109.1, C111.1, C113.1, C115.1, C117.1, J1.1 (5V0), J1.2 (2V5), J1.3 (2V5), J1.4 (5V0), J1.5 (5V0), J1.6 (5V0), U7.2 (VIN1), U7.5 (VIN2), U7.6 (FB2), U7.7 (FB3), U7.8 (VIN3), U7.11 (VIN4), U7.13 (EN4), U7.17 (RT), U7.19 (EN5), U7.21 (VIN5), U7.24 (VIN6), U7.25 (FB6), U7.27 (VIN7), U7.30 (VIN8), U7.32 (EN8), U7.33 (EN7), U7.34 (MODE), U7.35 (VCC), U7.38 (EN1)
/Power Supply/MCU_VBAT: C46.1, R45.2, TP11.1, U1.C1 (VBAT)
/Power Supply/PGOOD: R26.2, TP2.1, U7.15 (PGOOD_ALL)
unnamed: C1.2, U1.L11 (VCAP_1)
unnamed: C2.1, U1.E11 (VCAP_2)
unnamed: D2.1 (K), R45.1

Notes on the sheet:
SMPS input caps
Remote sense and feedback for power rails
for 1V0
for 3V3
for 1V2
for 1V8
for 2V5
PCB bulk input cap (reduce input ripple)
SMPS output caps

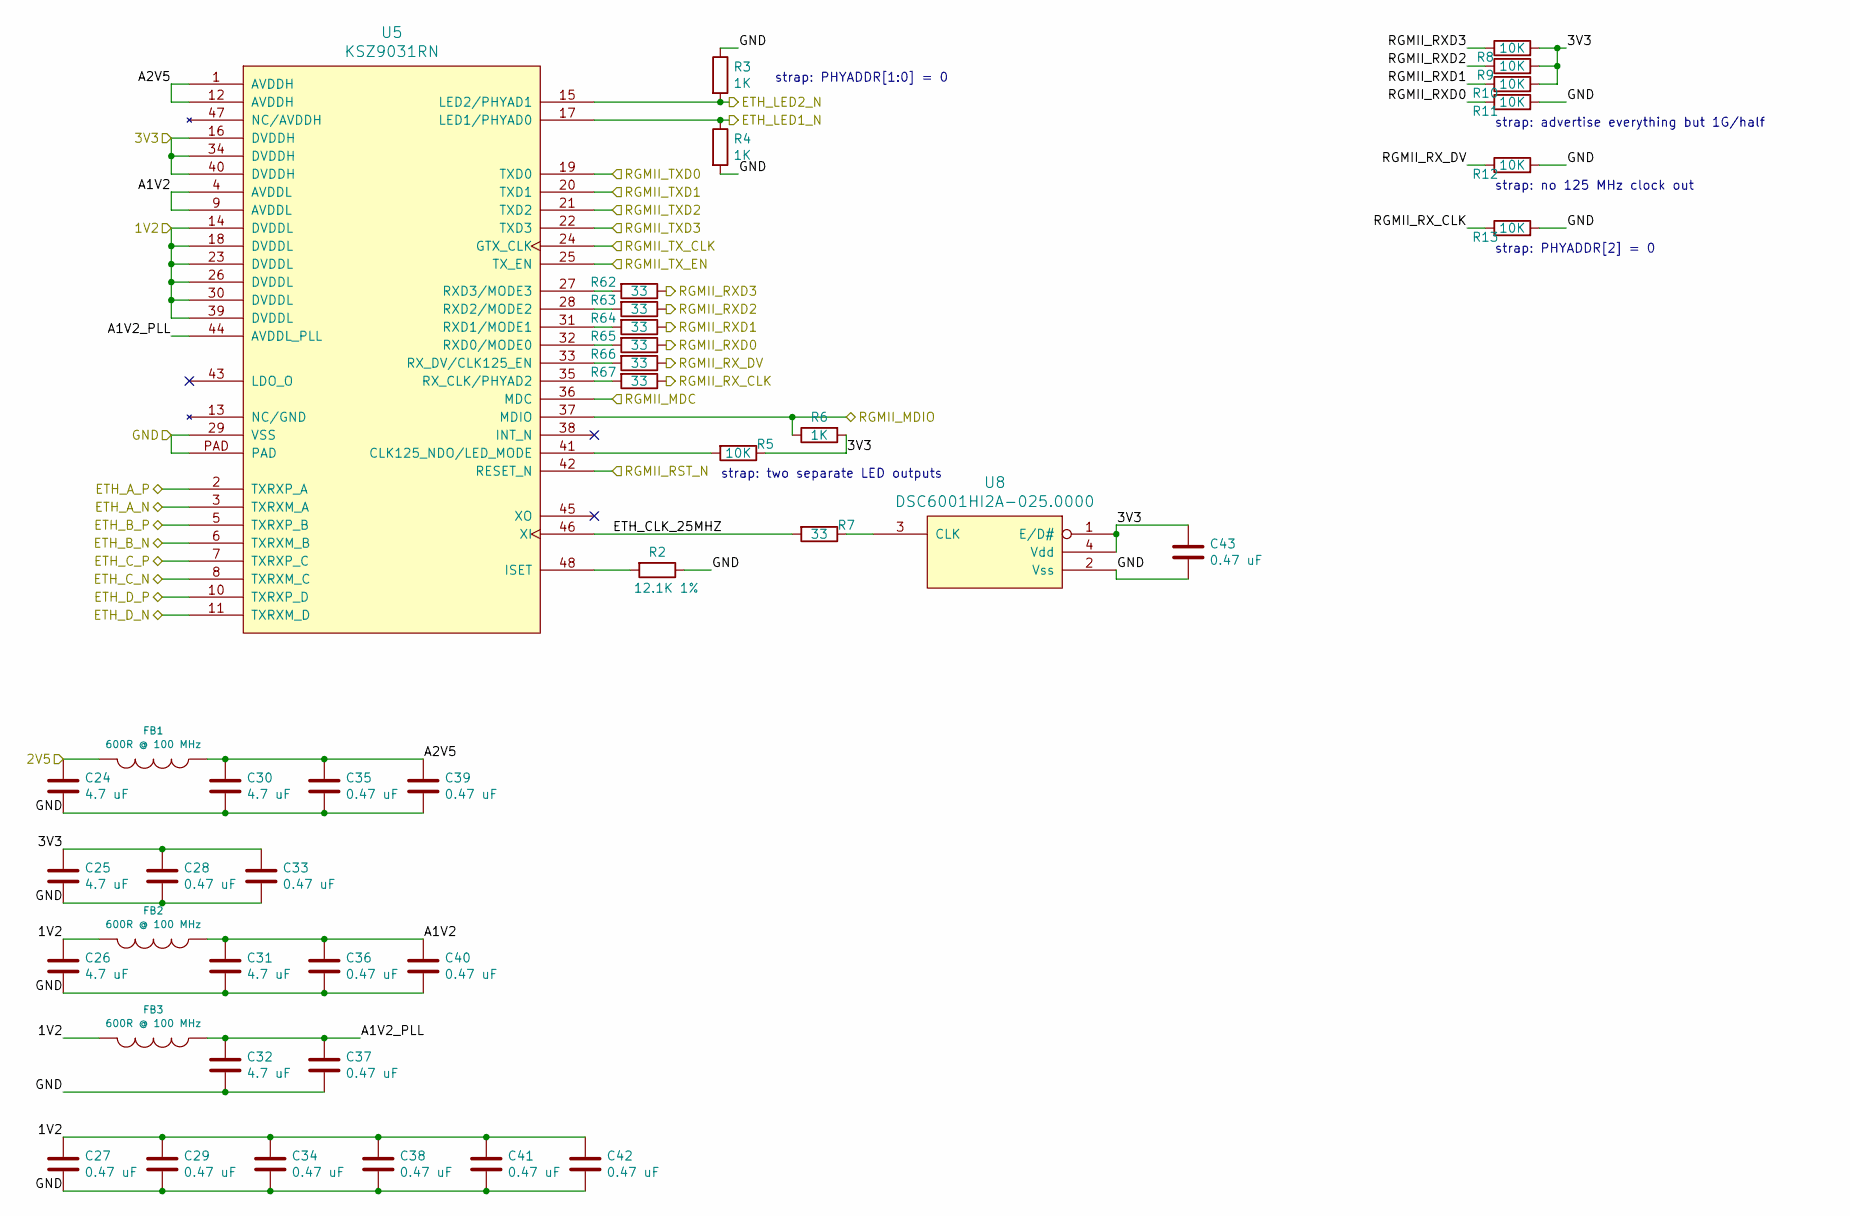
[picture p15: schematic ethernet.sch, INTEGRALSTICK Compute Module]

Parts:
C24, C25, C26, C30, C31, C32: 4.7 uF; EIA_0603_CAP_NOSILK
C27, C28, C29, C33, C34, C35, C36, C37, C38, C39, C40, C41, C42, C43: 0.47 uF; EIA_0402_CAP_NOSILK
FB1, FB2, FB3: 600R @ 100 MHz; EIA_0402_CAP_NOSILK
R2: 12.1K 1%; EIA_0402_RES_NOSILK
R3, R4, R6: 1K; EIA_0402_RES_NOSILK
R5, R8, R9, R10, R11, R12, R13: 10K; EIA_0402_RES_NOSILK
R7, R62, R63, R64, R65, R66, R67: 33; EIA_0402_RES_NOSILK
U5: KSZ9031RN; QFN_48_0.5MM_7x7MM
U8: DSC6001HI2A-025.0000; OSCILLATOR_1.6x1.2

Connections:
/1V2: C26.1, C27.1, C29.1, C34.1, C38.1, C41.1, C42.1, FB2.2, FB3.2, U5.14 (DVDDL), U5.18 (DVDDL), U5.23 (DVDDL), U5.26 (DVDDL), U5.30 (DVDDL), U5.39 (DVDDL); also elsewhere on the board
/2V5: C24.1, FB1.2; also elsewhere on the board
/3V3: C25.1, C28.1, C33.1, C43.1, R5.1, R6.2, R8.2, R9.2, R10.2, U5.16 (DVDDH), U5.34 (DVDDH), U5.40 (DVDDH), U8.1 (E/D#), U8.4 (Vdd); also elsewhere on the board
/ETH_LED1_N: R4.1, U5.17 (LED1/PHYAD0); also elsewhere on the board
/ETH_LED2_N: R3.2, U5.15 (LED2/PHYAD1); also elsewhere on the board
/Ethernet/A1V2: C31.1, C36.1, C40.1, FB2.1, U5.4 (AVDDL), U5.9 (AVDDL)
/Ethernet/A1V2_PLL: C32.1, C37.1, FB3.1, U5.44 (AVDDL_PLL)
/Ethernet/A2V5: C30.1, C35.1, C39.1, FB1.1, U5.1 (AVDDH), U5.12 (AVDDH)
/Ethernet/ETH_A_N: U5.3 (TXRXM_A); also elsewhere on the board
/Ethernet/ETH_A_P: U5.2 (TXRXP_A); also elsewhere on the board
/Ethernet/ETH_B_N: U5.6 (TXRXM_B); also elsewhere on the board
/Ethernet/ETH_B_P: U5.5 (TXRXP_B); also elsewhere on the board
/Ethernet/ETH_CLK_25MHZ: R7.2, U5.46 (XI)
/Ethernet/ETH_C_N: U5.8 (TXRXM_C); also elsewhere on the board
/Ethernet/ETH_C_P: U5.7 (TXRXP_C); also elsewhere on the board
/Ethernet/ETH_D_N: U5.11 (TXRXM_D); also elsewhere on the board
/Ethernet/ETH_D_P: U5.10 (TXRXP_D); also elsewhere on the board
/Ethernet/RGMII_MDC: U5.36 (MDC); also elsewhere on the board
/Ethernet/RGMII_MDIO: R6.1, U5.37 (MDIO); also elsewhere on the board
/Ethernet/RGMII_RST_N: U5.42 (RESET_N); also elsewhere on the board
/Ethernet/RGMII_RXD0: R11.1, R65.1; also elsewhere on the board
/Ethernet/RGMII_RXD1: R10.1, R64.1; also elsewhere on the board
/Ethernet/RGMII_RXD2: R9.1, R63.1; also elsewhere on the board
/Ethernet/RGMII_RXD3: R8.1, R62.1; also elsewhere on the board
/Ethernet/RGMII_RX_CLK: R13.1, R67.1; also elsewhere on the board
/Ethernet/RGMII_RX_DV: R12.1, R66.1; also elsewhere on the board
/Ethernet/RGMII_TXD0: U5.19 (TXD0); also elsewhere on the board
/Ethernet/RGMII_TXD1: U5.20 (TXD1); also elsewhere on the board
/Ethernet/RGMII_TXD2: U5.21 (TXD2); also elsewhere on the board
/Ethernet/RGMII_TXD3: U5.22 (TXD3); also elsewhere on the board
/Ethernet/RGMII_TX_CLK: U5.24 (GTX_CLK); also elsewhere on the board
/Ethernet/RGMII_TX_EN: U5.25 (TX_EN); also elsewhere on the board
/GND: C24.2, C25.2, C26.2, C27.2, C28.2, C29.2, C30.2, C31.2, C32.2, C33.2, C34.2, C35.2, C36.2, C37.2, C38.2, C39.2, C40.2, C41.2, C42.2, C43.2, R2.1, R3.1, R4.2, R11.2, R12.2, R13.2, U5.29 (VSS), U5.PAD, U8.2 (Vss); also elsewhere on the board
unnamed: R2.2, U5.48 (ISET)
unnamed: R5.2, U5.41 (CLK125_NDO/LED_MODE)
unnamed: R7.1, U8.3 (CLK)
unnamed: R62.2, U5.27 (RXD3/MODE3)
unnamed: R63.2, U5.28 (RXD2/MODE2)
unnamed: R64.2, U5.31 (RXD1/MODE1)
unnamed: R65.2, U5.32 (RXD0/MODE0)
unnamed: R66.2, U5.33 (RX_DV/CLK125_EN)
unnamed: R67.2, U5.35 (RX_CLK/PHYAD2)

Notes on the sheet:
strap: PHYADDR[1:0] = 0
strap: two separate LED outputs
strap: advertise everything but 1G/half
strap: no 125 MHz clock out
strap: PHYADDR[2] = 0
