azonenberg/integralstick/pcb/integralstick.kicad_pcb

## KiCad design pcb/integralstick.kicad_pcb (continued)

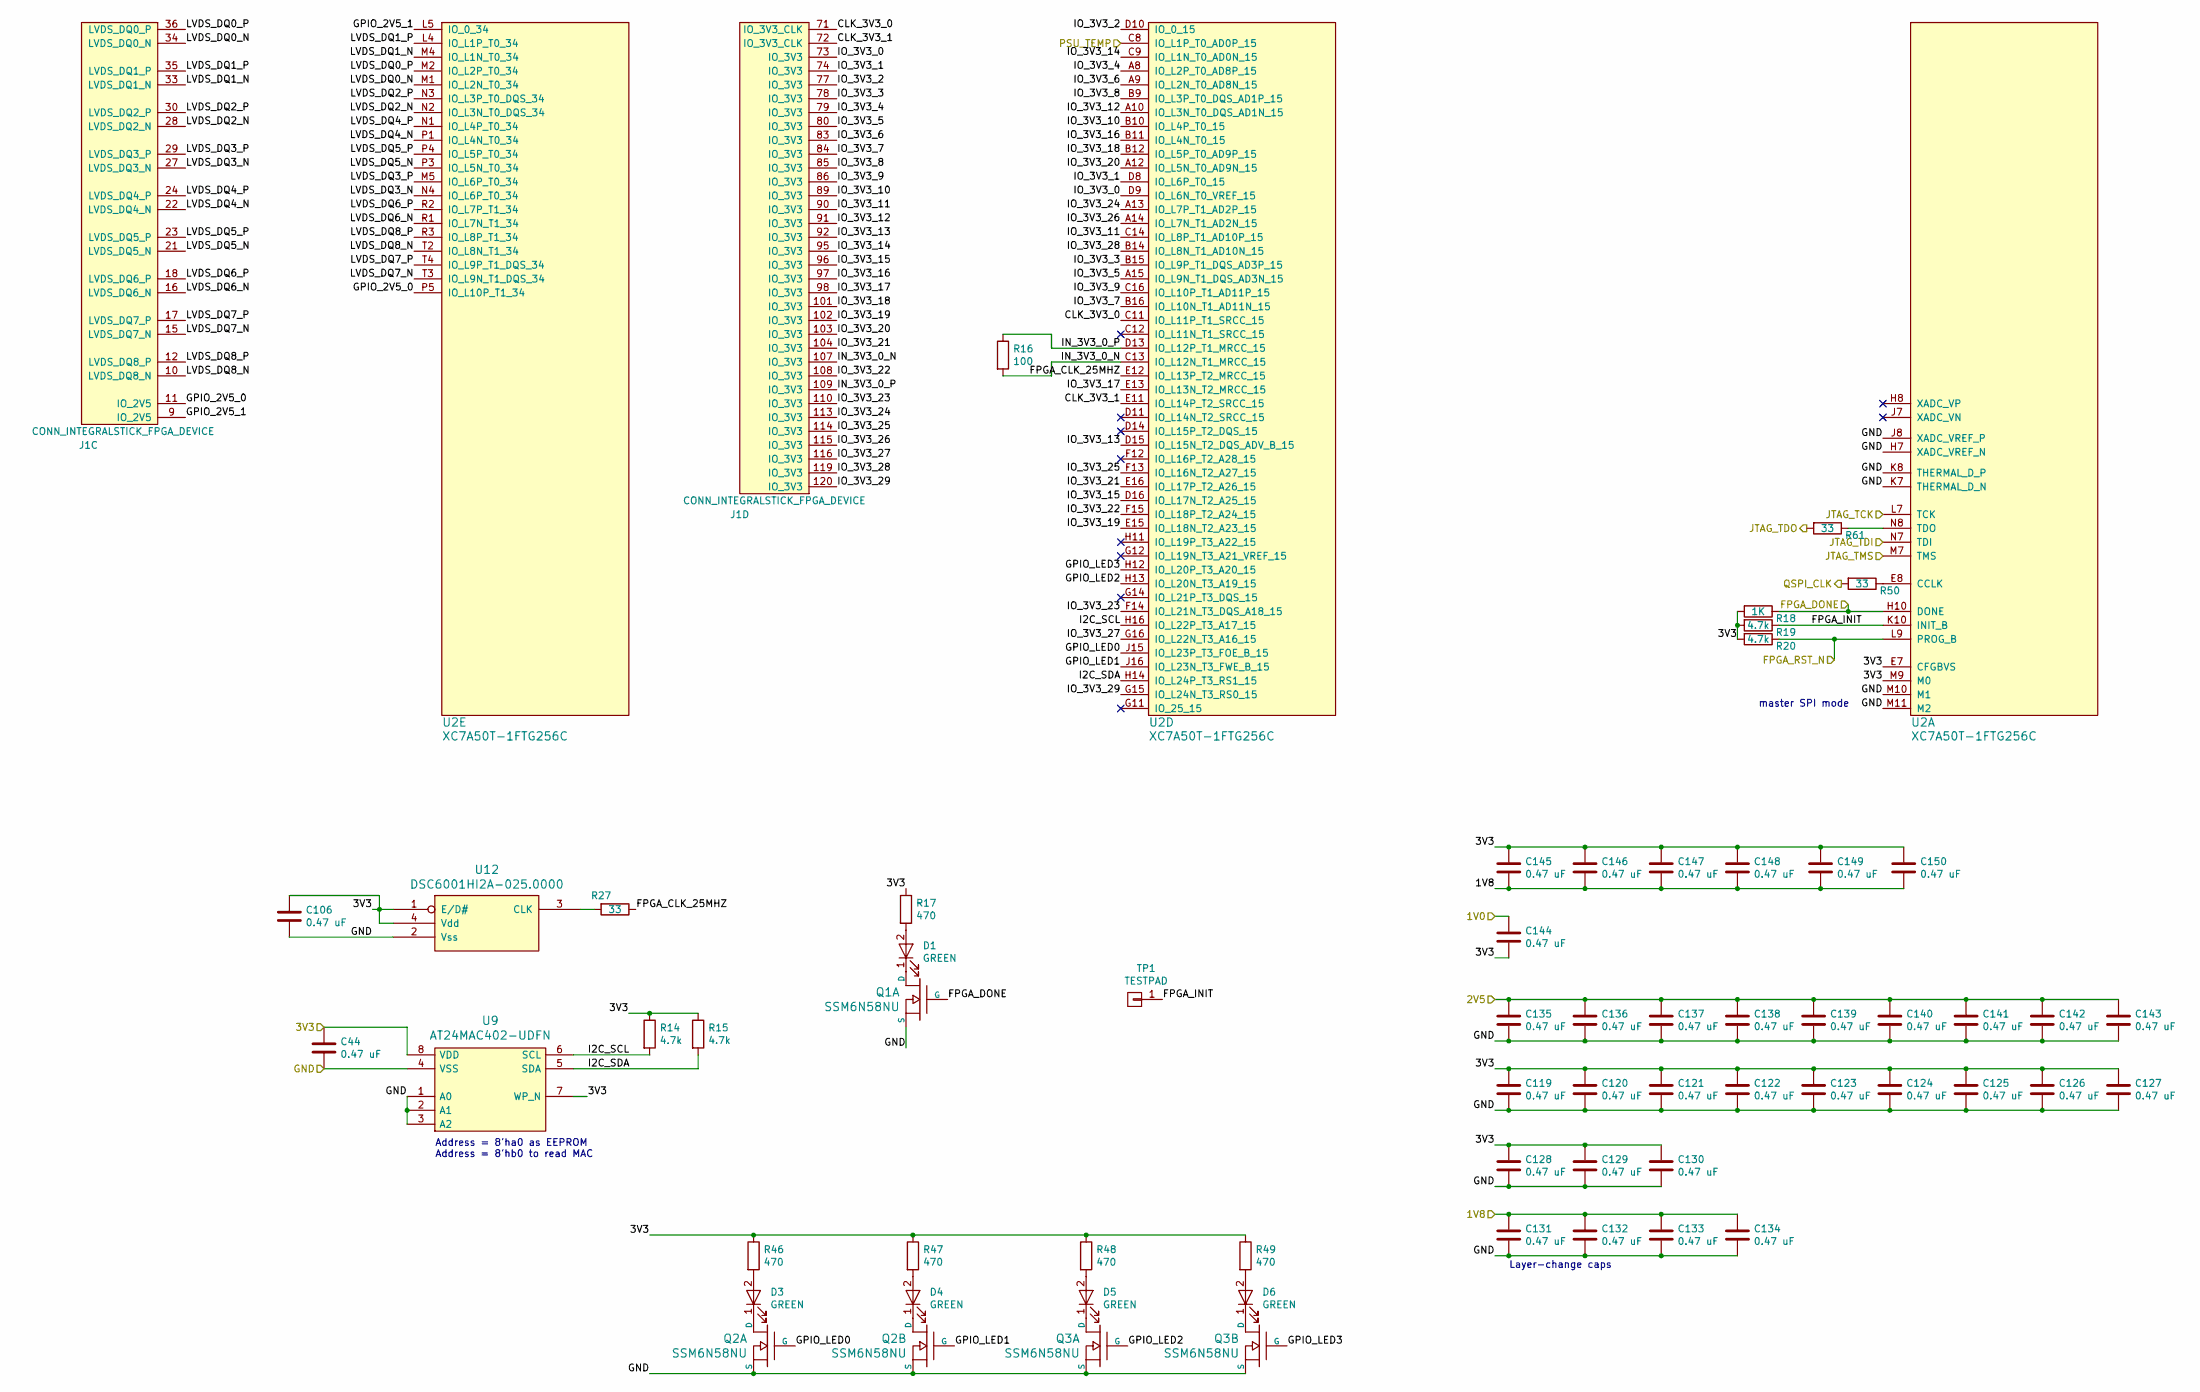
[picture p16: schematic fpga.sch, INTEGRALSTICK Compute Module]

Parts:
C44, C106, C119, C120, C121, C122, C123, C124, C125, C126, C127, C128, C129, C130, C131, C132, C133, C134, C135, C136, C137, C138, C139, C140, C141, C142, C143, C144, C145, C146, C147, C148, C149, C150: 0.47 uF; EIA_0402_CAP_NOSILK
D1, D3, D4, D5, D6: GREEN; EIA_0603_LED
J1: CONN_INTEGRALSTICK_FPGA_DEVICE; CONN_SAMTEC_QTH-060-01-L-D-A
Q1, Q2, Q3: SSM6N58NU; DFN_6_0.65MM_2x2MM_GDS
R14, R15, R19, R20: 4.7k; EIA_0402_RES_NOSILK
R16: 100; EIA_0402_RES_NOSILK
R17, R46, R47, R48, R49: 470; EIA_0402_RES_NOSILK
R18: 1K; EIA_0402_RES_NOSILK
R27, R50, R61: 33; EIA_0402_RES_NOSILK
TP1: TESTPAD; TESTPOINT_SMT_0.5MM
U2: XC7A50T-1FTG256C; BGA_256_17x17_FULLARRAY_1MM_0.4MM_FTG256
U9: AT24MAC402-UDFN; DFN_8_0.5MM_2x3MM
U12: DSC6001HI2A-025.0000‎; OSCILLATOR_1.6x1.2

Connections:
/1V0: C144.1; also elsewhere on the board
/1V8: C131.1, C132.1, C133.1, C134.1, C145.2, C146.2, C147.2, C148.2, C149.2, C150.2; also elsewhere on the board
/2V5: C135.1, C136.1, C137.1, C138.1, C139.1, C140.1, C141.1, C142.1, C143.1; also elsewhere on the board
/3V3: C44.1, C106.1, C119.1, C120.1, C121.1, C122.1, C123.1, C124.1, C125.1, C126.1, C127.1, C128.1, C129.1, C130.1, C144.2, C145.1, C146.1, C147.1, C148.1, C149.1, C150.1, R14.1, R15.1, R17.1, R18.2, R19.2, R20.2, R46.1, R47.1, R48.1, R49.1, U2.E7 (CFGBVS), U2.M9 (M0), U9.7 (WP_N), U9.8 (VDD), U12.1 (E/D#), U12.4 (Vdd); also elsewhere on the board
/FPGA/CLK_3V3_0: J1.71 (IO_3V3_CLK), U2.C11 (IO_L11P_T1_SRCC_15)
/FPGA/CLK_3V3_1: J1.72 (IO_3V3_CLK), U2.E11 (IO_L14P_T2_SRCC_15)
/FPGA/FPGA_CLK_25MHZ: R27.1, U2.E12 (IO_L13P_T2_MRCC_15)
/FPGA/FPGA_INIT: R19.1, TP1.1, U2.K10 (INIT_B)
/FPGA/GPIO_2V5_0: J1.11 (IO_2V5), U2.P5 (IO_L10P_T1_34)
/FPGA/GPIO_2V5_1: J1.9 (IO_2V5), U2.L5 (IO_0_34)
/FPGA/GPIO_LED0: Q2.G1 (G), U2.J15 (IO_L23P_T3_FOE_B_15)
/FPGA/GPIO_LED1: Q2.G2 (G), U2.J16 (IO_L23N_T3_FWE_B_15)
/FPGA/GPIO_LED2: Q3.G1 (G), U2.H13 (IO_L20N_T3_A19_15)
/FPGA/GPIO_LED3: Q3.G2 (G), U2.H12 (IO_L20P_T3_A20_15)
/FPGA/I2C_SCL: R14.2, U2.H16 (IO_L22P_T3_A17_15), U9.6 (SCL)
/FPGA/I2C_SDA: R15.2, U2.H14 (IO_L24P_T3_RS1_15), U9.5 (SDA)
/FPGA/IN_3V3_0_N: J1.107 (IO_3V3), R16.2, U2.C13 (IO_L12N_T1_MRCC_15)
/FPGA/IN_3V3_0_P: J1.109 (IO_3V3), R16.1, U2.D13 (IO_L12P_T1_MRCC_15)
/FPGA/IO_3V3_0: J1.73 (IO_3V3), U2.D9 (IO_L6N_T0_VREF_15)
/FPGA/IO_3V3_1: J1.74 (IO_3V3), U2.D8 (IO_L6P_T0_15)
/FPGA/IO_3V3_2: J1.77 (IO_3V3), U2.D10 (IO_0_15)
/FPGA/IO_3V3_3: J1.78 (IO_3V3), U2.B15 (IO_L9P_T1_DQS_AD3P_15)
/FPGA/IO_3V3_4: J1.79 (IO_3V3), U2.A8 (IO_L2P_T0_AD8P_15)
/FPGA/IO_3V3_5: J1.80 (IO_3V3), U2.A15 (IO_L9N_T1_DQS_AD3N_15)
/FPGA/IO_3V3_6: J1.83 (IO_3V3), U2.A9 (IO_L2N_T0_AD8N_15)
/FPGA/IO_3V3_7: J1.84 (IO_3V3), U2.B16 (IO_L10N_T1_AD11N_15)
/FPGA/IO_3V3_8: J1.85 (IO_3V3), U2.B9 (IO_L3P_T0_DQS_AD1P_15)
/FPGA/IO_3V3_9: J1.86 (IO_3V3), U2.C16 (IO_L10P_T1_AD11P_15)
/FPGA/IO_3V3_10: J1.89 (IO_3V3), U2.B10 (IO_L4P_T0_15)
/FPGA/IO_3V3_11: J1.90 (IO_3V3), U2.C14 (IO_L8P_T1_AD10P_15)
/FPGA/IO_3V3_12: J1.91 (IO_3V3), U2.A10 (IO_L3N_T0_DQS_AD1N_15)
/FPGA/IO_3V3_13: J1.92 (IO_3V3), U2.D15 (IO_L15N_T2_DQS_ADV_B_15)
/FPGA/IO_3V3_14: J1.95 (IO_3V3), U2.C9 (IO_L1N_T0_AD0N_15)
/FPGA/IO_3V3_15: J1.96 (IO_3V3), U2.D16 (IO_L17N_T2_A25_15)
/FPGA/IO_3V3_16: J1.97 (IO_3V3), U2.B11 (IO_L4N_T0_15)
/FPGA/IO_3V3_17: J1.98 (IO_3V3), U2.E13 (IO_L13N_T2_MRCC_15)
/FPGA/IO_3V3_18: J1.101 (IO_3V3), U2.B12 (IO_L5P_T0_AD9P_15)
/FPGA/IO_3V3_19: J1.102 (IO_3V3), U2.E15 (IO_L18N_T2_A23_15)
/FPGA/IO_3V3_20: J1.103 (IO_3V3), U2.A12 (IO_L5N_T0_AD9N_15)
/FPGA/IO_3V3_21: J1.104 (IO_3V3), U2.E16 (IO_L17P_T2_A26_15)
/FPGA/IO_3V3_22: J1.108 (IO_3V3), U2.F15 (IO_L18P_T2_A24_15)
/FPGA/IO_3V3_23: J1.110 (IO_3V3), U2.F14 (IO_L21N_T3_DQS_A18_15)
/FPGA/IO_3V3_24: J1.113 (IO_3V3), U2.A13 (IO_L7P_T1_AD2P_15)
/FPGA/IO_3V3_25: J1.114 (IO_3V3), U2.F13 (IO_L16N_T2_A27_15)
/FPGA/IO_3V3_26: J1.115 (IO_3V3), U2.A14 (IO_L7N_T1_AD2N_15)
/FPGA/IO_3V3_27: J1.116 (IO_3V3), U2.G16 (IO_L22N_T3_A16_15)
/FPGA/IO_3V3_28: J1.119 (IO_3V3), U2.B14 (IO_L8N_T1_AD10N_15)
/FPGA/IO_3V3_29: J1.120 (IO_3V3), U2.G15 (IO_L24N_T3_RS0_15)
/FPGA/LVDS_DQ0_N: J1.34 (LVDS_DQ0_N), U2.M1 (IO_L2N_T0_34)
/FPGA/LVDS_DQ0_P: J1.36 (LVDS_DQ0_P), U2.M2 (IO_L2P_T0_34)
/FPGA/LVDS_DQ1_N: J1.33 (LVDS_DQ1_N), U2.M4 (IO_L1N_T0_34)
/FPGA/LVDS_DQ1_P: J1.35 (LVDS_DQ1_P), U2.L4 (IO_L1P_T0_34)
/FPGA/LVDS_DQ2_N: J1.28 (LVDS_DQ2_N), U2.N2 (IO_L3N_T0_DQS_34)
/FPGA/LVDS_DQ2_P: J1.30 (LVDS_DQ2_P), U2.N3 (IO_L3P_T0_DQS_34)
/FPGA/LVDS_DQ3_N: J1.27 (LVDS_DQ3_N), U2.N4 (IO_L6P_T0_34)
/FPGA/LVDS_DQ3_P: J1.29 (LVDS_DQ3_P), U2.M5 (IO_L6P_T0_34)
/FPGA/LVDS_DQ4_N: J1.22 (LVDS_DQ4_N), U2.P1 (IO_L4N_T0_34)
/FPGA/LVDS_DQ4_P: J1.24 (LVDS_DQ4_P), U2.N1 (IO_L4P_T0_34)
/FPGA/LVDS_DQ5_N: J1.21 (LVDS_DQ5_N), U2.P3 (IO_L5N_T0_34)
/FPGA/LVDS_DQ5_P: J1.23 (LVDS_DQ5_P), U2.P4 (IO_L5P_T0_34)
/FPGA/LVDS_DQ6_N: J1.16 (LVDS_DQ6_N), U2.R1 (IO_L7N_T1_34)
/FPGA/LVDS_DQ6_P: J1.18 (LVDS_DQ6_P), U2.R2 (IO_L7P_T1_34)
/FPGA/LVDS_DQ7_N: J1.15 (LVDS_DQ7_N), U2.T3 (IO_L9N_T1_DQS_34)
/FPGA/LVDS_DQ7_P: J1.17 (LVDS_DQ7_P), U2.T4 (IO_L9P_T1_DQS_34)
/FPGA/LVDS_DQ8_N: J1.10 (LVDS_DQ8_N), U2.T2 (IO_L8N_T1_34)
/FPGA/LVDS_DQ8_P: J1.12 (LVDS_DQ8_P), U2.R3 (IO_L8P_T1_34)
/FPGA_DONE: Q1.G1 (G), R18.1, U2.H10 (DONE); also elsewhere on the board
/FPGA_RST_N: R20.1, U2.L9 (PROG_B); also elsewhere on the board
/FPGA_TDI: U2.N7 (TDI); also elsewhere on the board
/FPGA_TDO: R61.2; also elsewhere on the board
/GND: C44.2, C106.2, C119.2, C120.2, C121.2, C122.2, C123.2, C124.2, C125.2, C126.2, C127.2, C128.2, C129.2, C130.2, C131.2, C132.2, C133.2, C134.2, C135.2, C136.2, C137.2, C138.2, C139.2, C140.2, C141.2, C142.2, C143.2, Q1.S1 (S), Q2.S1 (S), Q2.S2 (S), Q3.S1 (S), Q3.S2 (S), U2.H7 (XADC_VREF_N), U2.J8 (XADC_VREF_P), U2.K7 (THERMAL_D_N), U2.K8 (THERMAL_D_P), U2.M10 (M1), U2.M11 (M2), U9.1 (A0), U9.2 (A1), U9.3 (A2), U9.4 (VSS), U12.2 (Vss); also elsewhere on the board
/JTAG_TCK: U2.L7 (TCK); also elsewhere on the board
/JTAG_TMS: U2.M7 (TMS); also elsewhere on the board
/PSU_TEMP: U2.C8 (IO_L1P_T0_AD0P_15); also elsewhere on the board
/QSPI_CLK: R50.2; also elsewhere on the board
unnamed: D1.1 (K), Q1.D1 (D)
unnamed: D1.2 (A), R17.2
unnamed: D3.1 (K), Q2.D1 (D)
unnamed: D3.2 (A), R46.2
unnamed: D4.1 (K), Q2.D2 (D)
unnamed: D4.2 (A), R47.2
unnamed: D5.1 (K), Q3.D1 (D)
unnamed: D5.2 (A), R48.2
unnamed: D6.1 (K), Q3.D2 (D)
unnamed: D6.2 (A), R49.2
unnamed: R27.2, U12.3 (CLK)
unnamed: R50.1, U2.E8 (CCLK)
unnamed: R61.1, U2.N8 (TDO)

Notes on the sheet:
Address = 8'ha0 as EEPROM Address = 8'hb0 to read MAC
master SPI mode
Layer-change caps

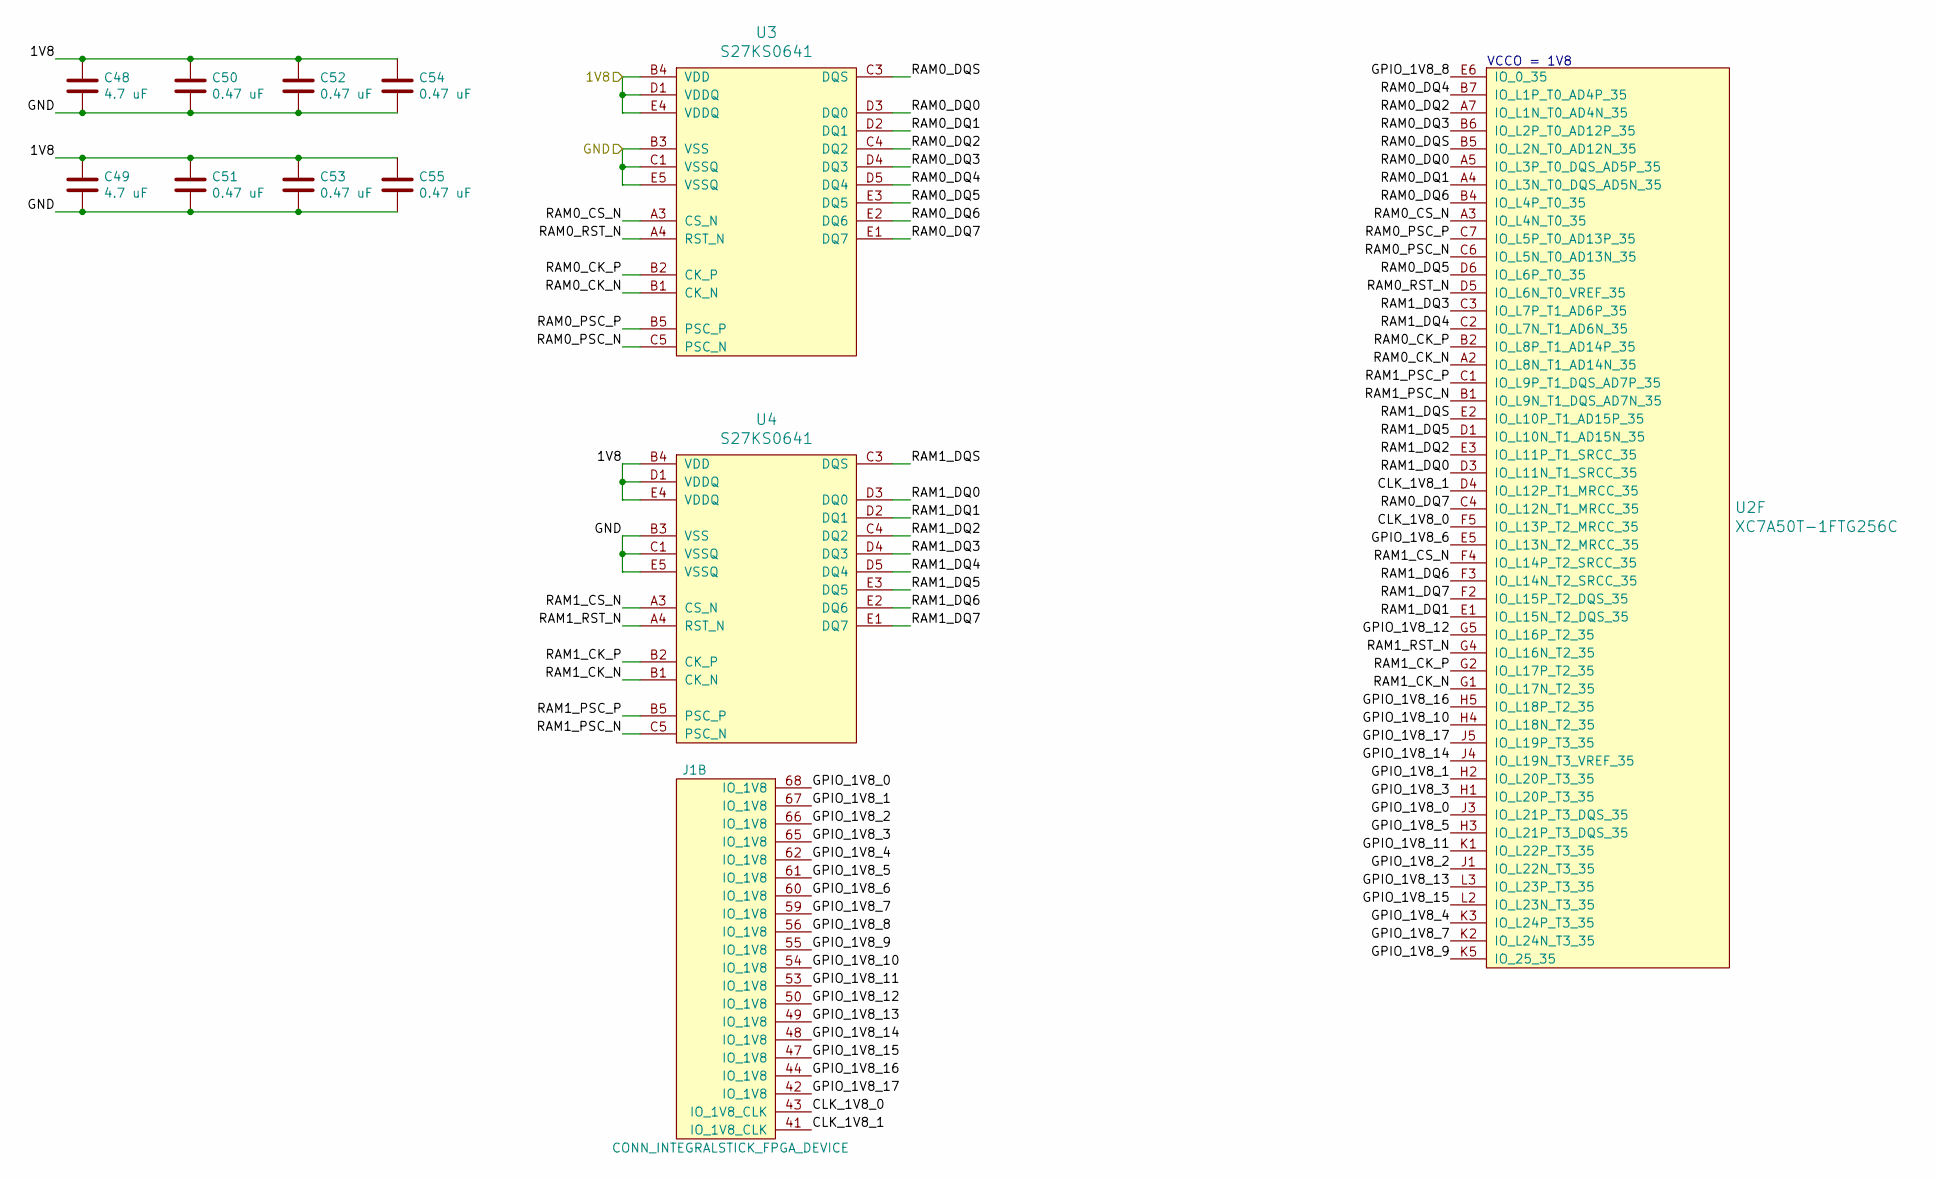
[picture p17: schematic ram.sch, INTEGRALSTICK Compute Module]

Parts:
C48, C49: 4.7 uF; EIA_0603_CAP_NOSILK
C50, C51, C52, C53, C54, C55: 0.47 uF; EIA_0402_CAP_NOSILK
J1: CONN_INTEGRALSTICK_FPGA_DEVICE; CONN_SAMTEC_QTH-060-01-L-D-A
U2: XC7A50T-1FTG256C; BGA_256_17x17_FULLARRAY_1MM_0.4MM_FTG256
U3, U4: S27KS0641; BGA_24_6x8_DEPOP1_1MM

Connections:
/1V8: C48.1, C49.1, C50.1, C51.1, C52.1, C53.1, C54.1, C55.1, U3.B4 (VDD), U3.D1 (VDDQ), U3.E4 (VDDQ), U4.B4 (VDD), U4.D1 (VDDQ), U4.E4 (VDDQ); also elsewhere on the board
/GND: C48.2, C49.2, C50.2, C51.2, C52.2, C53.2, C54.2, C55.2, U3.B3 (VSS), U3.C1 (VSSQ), U3.E5 (VSSQ), U4.B3 (VSS), U4.C1 (VSSQ), U4.E5 (VSSQ); also elsewhere on the board
/RAM/CLK_1V8_0: J1.43 (IO_1V8_CLK), U2.F5 (IO_L13P_T2_MRCC_35)
/RAM/CLK_1V8_1: J1.41 (IO_1V8_CLK), U2.D4 (IO_L12P_T1_MRCC_35)
/RAM/GPIO_1V8_0: J1.68 (IO_1V8), U2.J3 (IO_L21P_T3_DQS_35)
/RAM/GPIO_1V8_1: J1.67 (IO_1V8), U2.H2 (IO_L20P_T3_35)
/RAM/GPIO_1V8_2: J1.66 (IO_1V8), U2.J1 (IO_L22N_T3_35)
/RAM/GPIO_1V8_3: J1.65 (IO_1V8), U2.H1 (IO_L20P_T3_35)
/RAM/GPIO_1V8_4: J1.62 (IO_1V8), U2.K3 (IO_L24P_T3_35)
/RAM/GPIO_1V8_5: J1.61 (IO_1V8), U2.H3 (IO_L21P_T3_DQS_35)
/RAM/GPIO_1V8_6: J1.60 (IO_1V8), U2.E5 (IO_L13N_T2_MRCC_35)
/RAM/GPIO_1V8_7: J1.59 (IO_1V8), U2.K2 (IO_L24N_T3_35)
/RAM/GPIO_1V8_8: J1.56 (IO_1V8), U2.E6 (IO_0_35)
/RAM/GPIO_1V8_9: J1.55 (IO_1V8), U2.K5 (IO_25_35)
/RAM/GPIO_1V8_10: J1.54 (IO_1V8), U2.H4 (IO_L18N_T2_35)
/RAM/GPIO_1V8_11: J1.53 (IO_1V8), U2.K1 (IO_L22P_T3_35)
/RAM/GPIO_1V8_12: J1.50 (IO_1V8), U2.G5 (IO_L16P_T2_35)
/RAM/GPIO_1V8_13: J1.49 (IO_1V8), U2.L3 (IO_L23P_T3_35)
/RAM/GPIO_1V8_14: J1.48 (IO_1V8), U2.J4 (IO_L19N_T3_VREF_35)
/RAM/GPIO_1V8_15: J1.47 (IO_1V8), U2.L2 (IO_L23N_T3_35)
/RAM/GPIO_1V8_16: J1.44 (IO_1V8), U2.H5 (IO_L18P_T2_35)
/RAM/GPIO_1V8_17: J1.42 (IO_1V8), U2.J5 (IO_L19P_T3_35)
/RAM/RAM0_CK_N: U2.A2 (IO_L8N_T1_AD14N_35), U3.B1 (CK_N)
/RAM/RAM0_CK_P: U2.B2 (IO_L8P_T1_AD14P_35), U3.B2 (CK_P)
/RAM/RAM0_CS_N: U2.A3 (IO_L4N_T0_35), U3.A3 (CS_N)
/RAM/RAM0_DQ0: U2.A5 (IO_L3P_T0_DQS_AD5P_35), U3.D3 (DQ0)
/RAM/RAM0_DQ1: U2.A4 (IO_L3N_T0_DQS_AD5N_35), U3.D2 (DQ1)
/RAM/RAM0_DQ2: U2.A7 (IO_L1N_T0_AD4N_35), U3.C4 (DQ2)
/RAM/RAM0_DQ3: U2.B6 (IO_L2P_T0_AD12P_35), U3.D4 (DQ3)
/RAM/RAM0_DQ4: U2.B7 (IO_L1P_T0_AD4P_35), U3.D5 (DQ4)
/RAM/RAM0_DQ5: U2.D6 (IO_L6P_T0_35), U3.E3 (DQ5)
/RAM/RAM0_DQ6: U2.B4 (IO_L4P_T0_35), U3.E2 (DQ6)
/RAM/RAM0_DQ7: U2.C4 (IO_L12N_T1_MRCC_35), U3.E1 (DQ7)
/RAM/RAM0_DQS: U2.B5 (IO_L2N_T0_AD12N_35), U3.C3 (DQS)
/RAM/RAM0_PSC_N: U2.C6 (IO_L5N_T0_AD13N_35), U3.C5 (PSC_N)
/RAM/RAM0_PSC_P: U2.C7 (IO_L5P_T0_AD13P_35), U3.B5 (PSC_P)
/RAM/RAM0_RST_N: U2.D5 (IO_L6N_T0_VREF_35), U3.A4 (RST_N)
/RAM/RAM1_CK_N: U2.G1 (IO_L17N_T2_35), U4.B1 (CK_N)
/RAM/RAM1_CK_P: U2.G2 (IO_L17P_T2_35), U4.B2 (CK_P)
/RAM/RAM1_CS_N: U2.F4 (IO_L14P_T2_SRCC_35), U4.A3 (CS_N)
/RAM/RAM1_DQ0: U2.D3 (IO_L11N_T1_SRCC_35), U4.D3 (DQ0)
/RAM/RAM1_DQ1: U2.E1 (IO_L15N_T2_DQS_35), U4.D2 (DQ1)
/RAM/RAM1_DQ2: U2.E3 (IO_L11P_T1_SRCC_35), U4.C4 (DQ2)
/RAM/RAM1_DQ3: U2.C3 (IO_L7P_T1_AD6P_35), U4.D4 (DQ3)
/RAM/RAM1_DQ4: U2.C2 (IO_L7N_T1_AD6N_35), U4.D5 (DQ4)
/RAM/RAM1_DQ5: U2.D1 (IO_L10N_T1_AD15N_35), U4.E3 (DQ5)
/RAM/RAM1_DQ6: U2.F3 (IO_L14N_T2_SRCC_35), U4.E2 (DQ6)
/RAM/RAM1_DQ7: U2.F2 (IO_L15P_T2_DQS_35), U4.E1 (DQ7)
/RAM/RAM1_DQS: U2.E2 (IO_L10P_T1_AD15P_35), U4.C3 (DQS)
/RAM/RAM1_PSC_N: U2.B1 (IO_L9N_T1_DQS_AD7N_35), U4.C5 (PSC_N)
/RAM/RAM1_PSC_P: U2.C1 (IO_L9P_T1_DQS_AD7P_35), U4.B5 (PSC_P)
/RAM/RAM1_RST_N: U2.G4 (IO_L16N_T2_35), U4.A4 (RST_N)

Notes on the sheet:
VCCO = 1V8

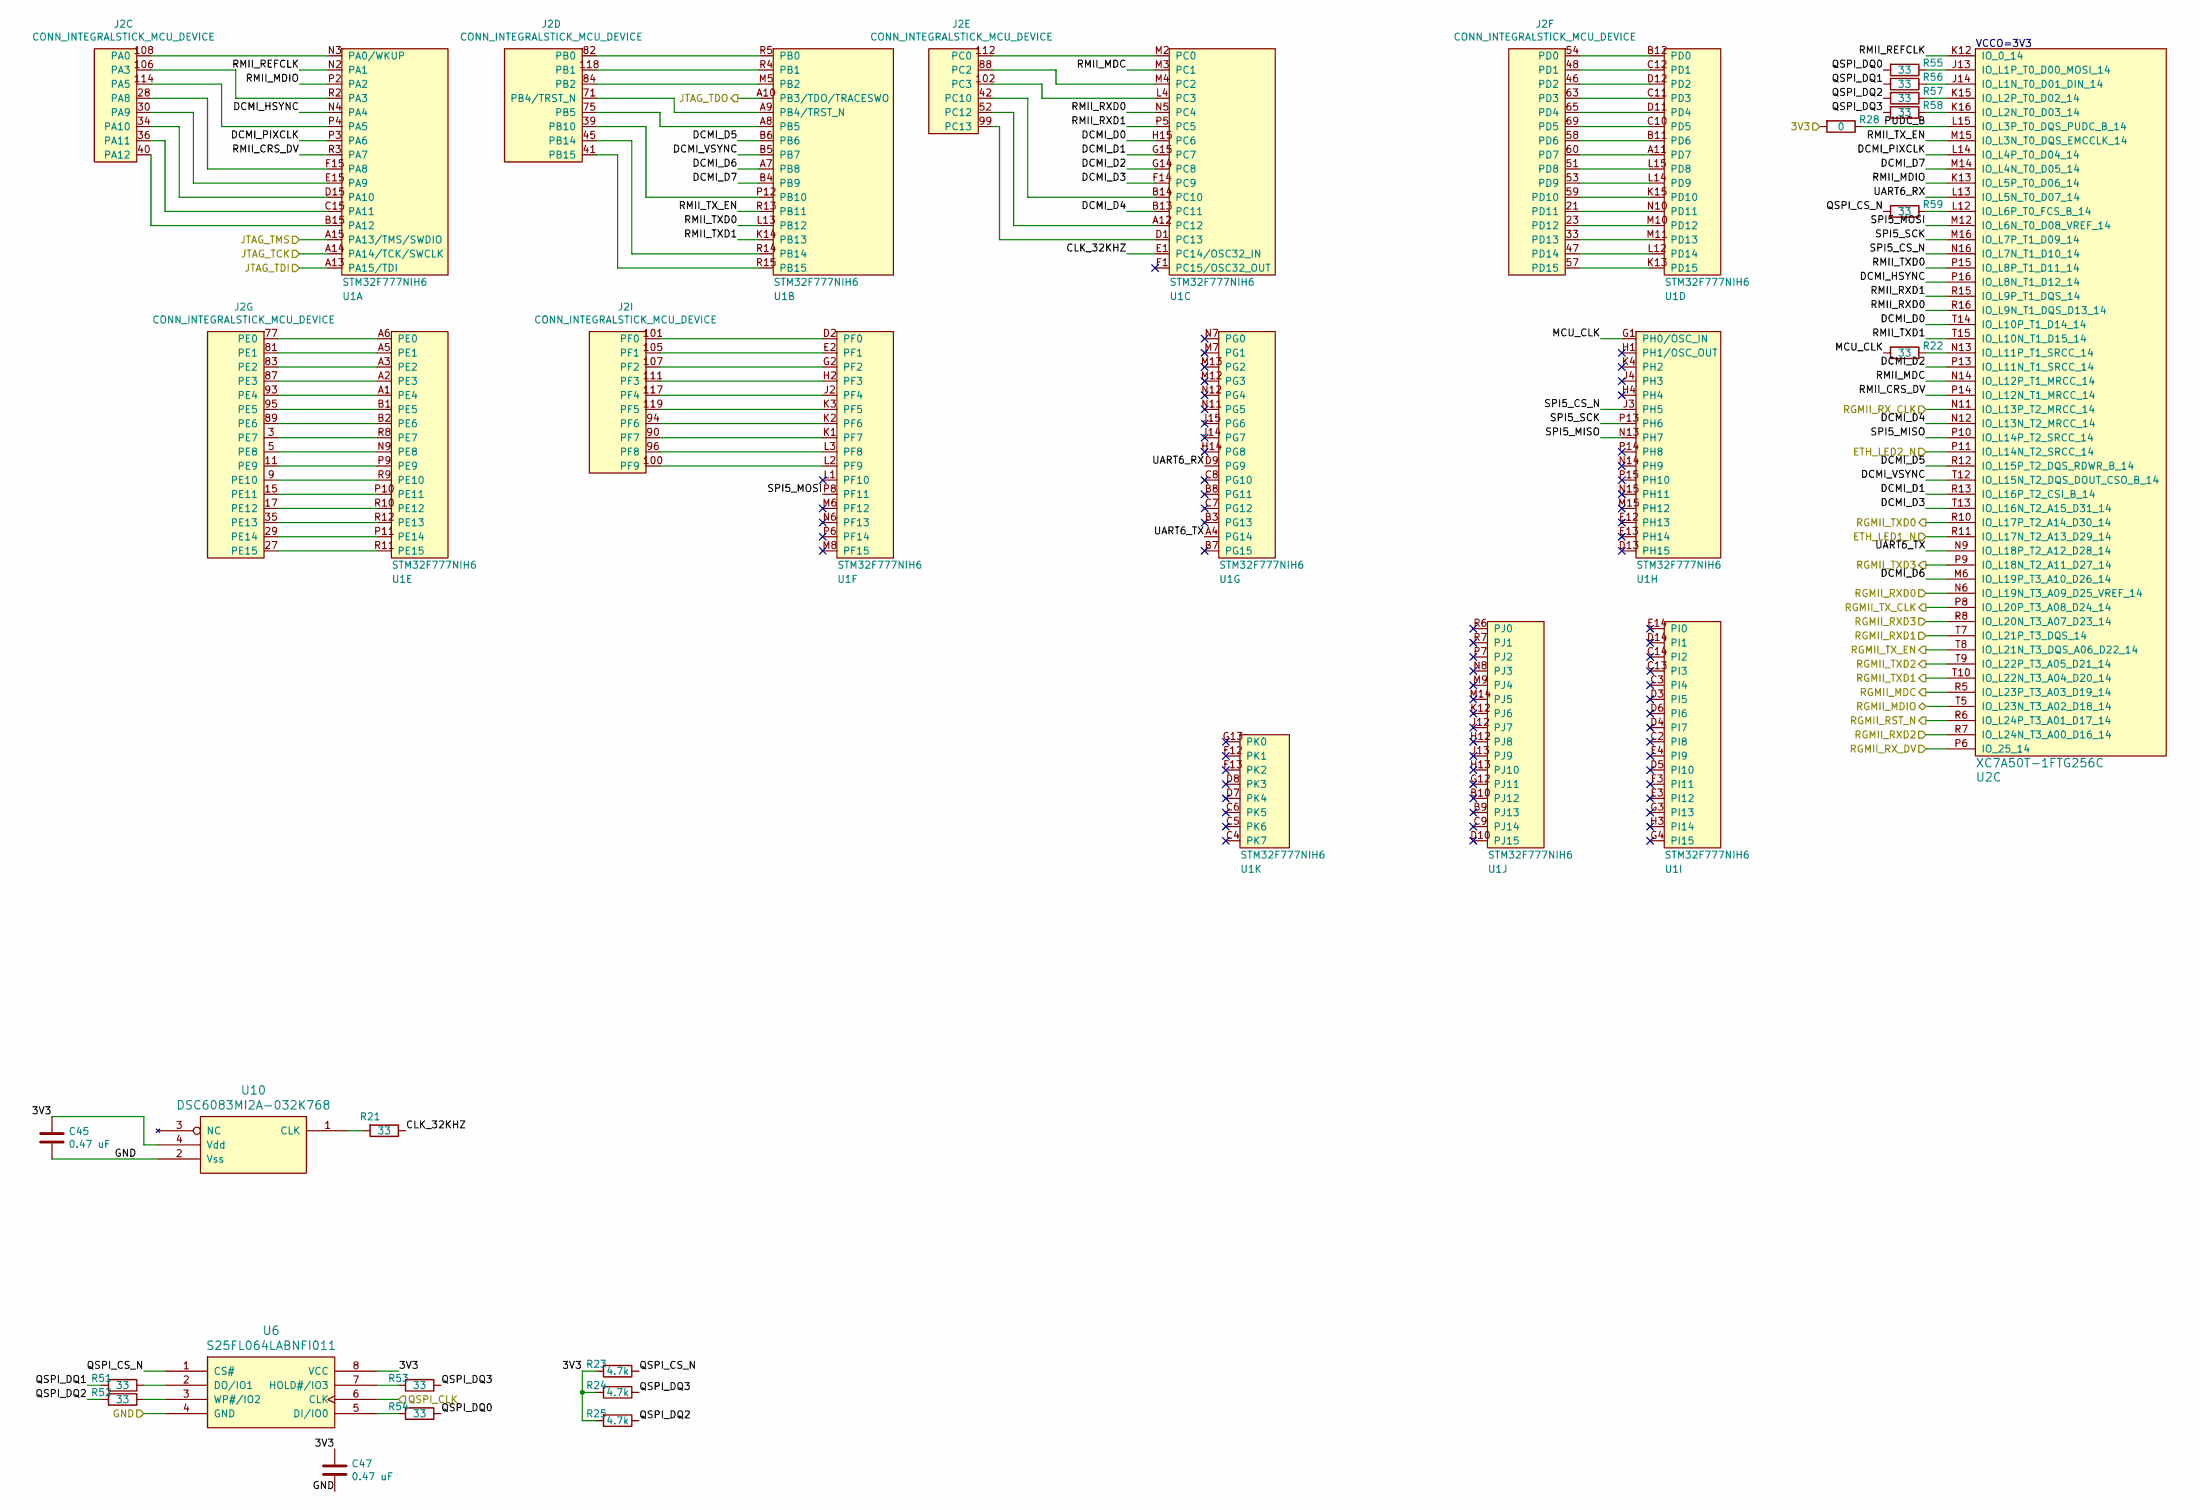
[picture p18: schematic mcu.sch, INTEGRALSTICK Compute Module]

Parts:
C45, C47: 0.47 uF; EIA_0402_CAP_NOSILK
J2: CONN_INTEGRALSTICK_MCU_DEVICE; CONN_SAMTEC_QTH-060-01-L-D-A
R21, R22, R51, R52, R53, R54, R55, R56, R57, R58, R59: 33; EIA_0402_RES_NOSILK
R23, R24, R25: 4.7k; EIA_0402_RES_NOSILK
R28: 0; EIA_0402_CAP_NOSILK
U1: STM32F777NIH6‎; BGA_216_13x13_DEPOP3x3_0.8MM
U2: XC7A50T-1FTG256C; BGA_256_17x17_FULLARRAY_1MM_0.4MM_FTG256
U6: S25FL064LABNFI011‎; DFN_8_1.27MM_6x5MM
U10: DSC6083MI2A-032K768; OSCILLATOR_2.0x1.6

Connections:
/3V3: C45.1, C47.1, R23.2, R24.2, R25.2, R28.2, U6.8 (VCC), U10.4 (Vdd); also elsewhere on the board
/ETH_LED1_N: U2.R11 (IO_L17N_T2_A13_D29_14); also elsewhere on the board
/ETH_LED2_N: U2.P11 (IO_L14N_T2_SRCC_14); also elsewhere on the board
/Ethernet/RGMII_MDC: U2.R5 (IO_L23P_T3_A03_D19_14); also elsewhere on the board
/Ethernet/RGMII_MDIO: U2.T5 (IO_L23N_T3_A02_D18_14); also elsewhere on the board
/Ethernet/RGMII_RST_N: U2.R6 (IO_L24P_T3_A01_D17_14); also elsewhere on the board
/Ethernet/RGMII_RXD0: U2.N6 (IO_L19N_T3_A09_D25_VREF_14); also elsewhere on the board
/Ethernet/RGMII_RXD1: U2.T7 (IO_L21P_T3_DQS_14); also elsewhere on the board
/Ethernet/RGMII_RXD2: U2.R7 (IO_L24N_T3_A00_D16_14); also elsewhere on the board
/Ethernet/RGMII_RXD3: U2.R8 (IO_L20N_T3_A07_D23_14); also elsewhere on the board
/Ethernet/RGMII_RX_CLK: U2.N11 (IO_L13P_T2_MRCC_14); also elsewhere on the board
/Ethernet/RGMII_RX_DV: U2.P6 (IO_25_14); also elsewhere on the board
/Ethernet/RGMII_TXD0: U2.R10 (IO_L17P_T2_A14_D30_14); also elsewhere on the board
/Ethernet/RGMII_TXD1: U2.T10 (IO_L22N_T3_A04_D20_14); also elsewhere on the board
/Ethernet/RGMII_TXD2: U2.T9 (IO_L22P_T3_A05_D21_14); also elsewhere on the board
/Ethernet/RGMII_TXD3: U2.P9 (IO_L18N_T2_A11_D27_14); also elsewhere on the board
/Ethernet/RGMII_TX_CLK: U2.P8 (IO_L20P_T3_A08_D24_14); also elsewhere on the board
/Ethernet/RGMII_TX_EN: U2.T8 (IO_L21N_T3_DQS_A06_D22_14); also elsewhere on the board
/FPGA_TDO: U1.A13 (PA15/TDI); also elsewhere on the board
/GND: C45.2, C47.2, U6.4 (GND), U10.2 (Vss); also elsewhere on the board
/JTAG_TCK: U1.A14 (PA14/TCK/SWCLK); also elsewhere on the board
/JTAG_TMS: U1.A15 (PA13/TMS/SWDIO); also elsewhere on the board
/MCU/CLK_32KHZ: R21.1, U1.E1 (PC14/OSC32_IN)
/MCU/DCMI_D0: U1.H15 (PC6), U2.T14 (IO_L10P_T1_D14_14)
/MCU/DCMI_D1: U1.G15 (PC7), U2.R13 (IO_L16P_T2_CSI_B_14)
/MCU/DCMI_D2: U1.G14 (PC8), U2.P13 (IO_L11N_T1_SRCC_14)
/MCU/DCMI_D3: U1.F14 (PC9), U2.T13 (IO_L16N_T2_A15_D31_14)
/MCU/DCMI_D4: U1.B13 (PC11), U2.N12 (IO_L13N_T2_MRCC_14)
/MCU/DCMI_D5: U1.B6, U2.R12 (IO_L15P_T2_DQS_RDWR_B_14)
/MCU/DCMI_D6: U1.A7 (PB8), U2.M6 (IO_L19P_T3_A10_D26_14)
/MCU/DCMI_D7: U1.B4 (PB9), U2.M14 (IO_L4N_T0_D05_14)
/MCU/DCMI_HSYNC: U1.N4 (PA4), U2.P16 (IO_L8N_T1_D12_14)
/MCU/DCMI_PIXCLK: U1.P3 (PA6), U2.L14 (IO_L4P_T0_D04_14)
/MCU/DCMI_VSYNC: U1.B5 (PB7), U2.T12 (IO_L15N_T2_DQS_DOUT_CSO_B_14)
/MCU/JTAG_TDO: U1.A10 (PB3/TDO/TRACESWO); also elsewhere on the board
/MCU/MCU_CLK: R22.2, U1.G1 (PH0/OSC_IN)
/MCU/PUDC_B: R28.1, U2.L15 (IO_L3P_T0_DQS_PUDC_B_14)
/MCU/QSPI_CS_N: R23.1, R59.2, U6.1 (CS#)
/MCU/QSPI_DQ0: R54.1, R55.2
/MCU/QSPI_DQ1: R51.2, R56.2
/MCU/QSPI_DQ2: R25.1, R52.2, R57.2
/MCU/QSPI_DQ3: R24.1, R53.1, R58.2
/MCU/RMII_CRS_DV: U1.R3 (PA7), U2.P14 (IO_L12N_T1_MRCC_14)
/MCU/RMII_MDC: U1.M3 (PC1), U2.N14 (IO_L12P_T1_MRCC_14)
/MCU/RMII_MDIO: U1.P2 (PA2), U2.K13 (IO_L5P_T0_D06_14)
/MCU/RMII_REFCLK: U1.N2 (PA1), U2.K12 (IO_0_14)
/MCU/RMII_RXD0: U1.N5 (PC4), U2.R16 (IO_L9N_T1_DQS_D13_14)
/MCU/RMII_RXD1: U1.P5 (PC5), U2.R15 (IO_L9P_T1_DQS_14)
/MCU/RMII_TXD0: U1.L13 (PB12), U2.P15 (IO_L8P_T1_D11_14)
/MCU/RMII_TXD1: U1.K14 (PB13), U2.T15 (IO_L10N_T1_D15_14)
/MCU/RMII_TX_EN: U1.R13 (PB11), U2.M15 (IO_L3N_T0_DQS_EMCCLK_14)
/MCU/SPI5_CS_N: U1.J3 (PH5), U2.N16 (IO_L7N_T1_D10_14)
/MCU/SPI5_MISO: U1.N13 (PH7), U2.P10 (IO_L14P_T2_SRCC_14)
/MCU/SPI5_MOSI: U1.P8 (PF11), U2.M12 (IO_L6N_T0_D08_VREF_14)
/MCU/SPI5_SCK: U1.P13 (PH6), U2.M16 (IO_L7P_T1_D09_14)
/MCU/UART6_RX: U1.D9 (PG9), U2.L13 (IO_L5N_T0_D07_14)
/MCU/UART6_TX: U1.A4 (PG14), U2.N9 (IO_L18P_T2_A12_D28_14)
/QSPI_CLK: U6.6 (CLK); also elsewhere on the board
unnamed: J2.3 (PE7), U1.R8 (PE7)
unnamed: J2.5 (PE8), U1.N9 (PE8)
unnamed: J2.9 (PE10), U1.R9 (PE10)
unnamed: J2.11 (PE9), U1.P9 (PE9)
unnamed: J2.15 (PE11), U1.P10 (PE11)
unnamed: J2.17 (PE12), U1.R10 (PE12)
unnamed: J2.21 (PD11), U1.N10 (PD11)
unnamed: J2.23 (PD12), U1.M10 (PD12)
unnamed: J2.27 (PE15), U1.R11 (PE15)
unnamed: J2.28 (PA8), U1.F15 (PA8)
unnamed: J2.29 (PE14), U1.P11 (PE14)
unnamed: J2.30 (PA9), U1.E15 (PA9)
unnamed: J2.33 (PD13), U1.M11 (PD13)
unnamed: J2.34 (PA10), U1.D15 (PA10)
unnamed: J2.35 (PE13), U1.R12 (PE13)
unnamed: J2.36 (PA11), U1.C15 (PA11)
unnamed: J2.39 (PB10), U1.P12 (PB10)
unnamed: J2.40 (PA12), U1.B15 (PA12)
unnamed: J2.41 (PB15), U1.R15 (PB15)
unnamed: J2.42 (PC10), U1.B14 (PC10)
unnamed: J2.45 (PB14), U1.R14 (PB14)
unnamed: J2.46 (PD2), U1.D12 (PD2)
unnamed: J2.47 (PD14), U1.L12 (PD14)
unnamed: J2.48 (PD1), U1.C12 (PD1)
unnamed: J2.51 (PD8), U1.L15 (PD8)
unnamed: J2.52 (PC12), U1.A12 (PC12)
unnamed: J2.53 (PD9), U1.L14 (PD9)
unnamed: J2.54 (PD0), U1.B12 (PD0)
unnamed: J2.57 (PD15), U1.K13 (PD15)
unnamed: J2.58 (PD6), U1.B11 (PD6)
unnamed: J2.59 (PD10), U1.K15 (PD10)
unnamed: J2.60 (PD7), U1.A11 (PD7)
unnamed: J2.63 (PD3), U1.C11 (PD3)
unnamed: J2.65 (PD4), U1.D11 (PD4)
unnamed: J2.69 (PD5), U1.C10 (PD5)
unnamed: J2.71 (PB4/TRST_N), U1.A9 (PB4/TRST_N)
unnamed: J2.75 (PB5), U1.A8 (PB5)
unnamed: J2.77 (PE0), U1.A6 (PE0)
unnamed: J2.81 (PE1), U1.A5 (PE1)
unnamed: J2.82 (PB0), U1.R5 (PB0)
unnamed: J2.83 (PE2), U1.A3 (PE2)
unnamed: J2.84 (PB2), U1.M5 (PB2)
unnamed: J2.87 (PE3), U1.A2 (PE3)
unnamed: J2.88 (PC2), U1.M4 (PC2)
unnamed: J2.89 (PE6), U1.B2 (PE6)
unnamed: J2.90 (PF7), U1.K1 (PF7)
unnamed: J2.93 (PE4), U1.A1 (PE4)
unnamed: J2.94 (PF6), U1.K2 (PF6)
unnamed: J2.95 (PE5), U1.B1 (PE5)
unnamed: J2.96 (PF8), U1.L3 (PF8)
unnamed: J2.99 (PC13), U1.D1 (PC13)
unnamed: J2.100 (PF9), U1.L2 (PF9)
unnamed: J2.101 (PF0), U1.D2 (PF0)
unnamed: J2.102 (PC3), U1.L4 (PC3)
unnamed: J2.105 (PF1), U1.E2 (PF1)
unnamed: J2.106 (PA3), U1.R2 (PA3)
unnamed: J2.107 (PF2), U1.G2 (PF2)
unnamed: J2.108 (PA0), U1.N3 (PA0/WKUP)
unnamed: J2.111 (PF3), U1.H2 (PF3)
unnamed: J2.112 (PC0), U1.M2 (PC0)
unnamed: J2.114 (PA5), U1.P4 (PA5)
unnamed: J2.117 (PF4), U1.J2 (PF4)
unnamed: J2.118 (PB1), U1.R4 (PB1)
unnamed: J2.119 (PF5), U1.K3 (PF5)
unnamed: R21.2, U10.1 (CLK)
unnamed: R22.1, U2.N13 (IO_L11P_T1_SRCC_14)
unnamed: R51.1, U6.2 (DO/IO1)
unnamed: R52.1, U6.3 (WP#/IO2)
unnamed: R53.2, U6.7 (HOLD#/IO3)
unnamed: R54.2, U6.5 (DI/IO0)
unnamed: R55.1, U2.J13 (IO_L1P_T0_D00_MOSI_14)
unnamed: R56.1, U2.J14 (IO_L1N_T0_D01_DIN_14)
unnamed: R57.1, U2.K15 (IO_L2P_T0_D02_14)
unnamed: R58.1, U2.K16 (IO_L2N_T0_D03_14)
unnamed: R59.1, U2.L12 (IO_L6P_T0_FCS_B_14)

Notes on the sheet:
VCCO=3V3

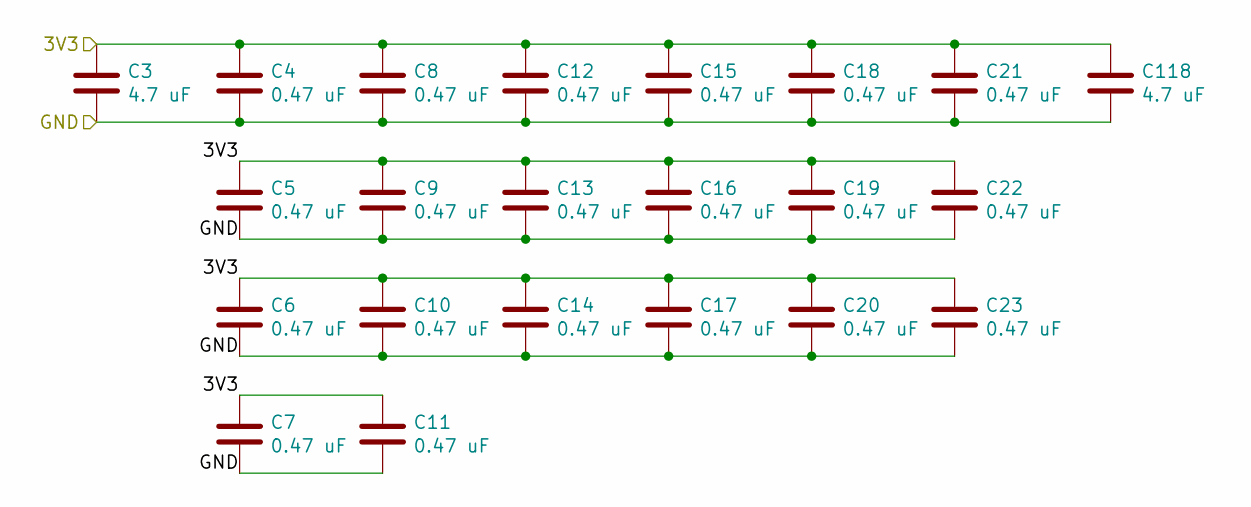
[picture p19: schematic mcu-decoupling.sch, INTEGRALSTICK Compute Module]

Parts:
C3, C118: 4.7 uF; EIA_0603_CAP_NOSILK
C4, C5, C6, C7, C8, C9, C10, C11, C12, C13, C14, C15, C16, C17, C18, C19, C20, C21, C22, C23: 0.47 uF; EIA_0402_CAP_NOSILK

Connections:
/3V3: C3.1, C4.1, C5.1, C6.1, C7.1, C8.1, C9.1, C10.1, C11.1, C12.1, C13.1, C14.1, C15.1, C16.1, C17.1, C18.1, C19.1, C20.1, C21.1, C22.1, C23.1, C118.1; also elsewhere on the board
/GND: C3.2, C4.2, C5.2, C6.2, C7.2, C8.2, C9.2, C10.2, C11.2, C12.2, C13.2, C14.2, C15.2, C16.2, C17.2, C18.2, C19.2, C20.2, C21.2, C22.2, C23.2, C118.2; also elsewhere on the board

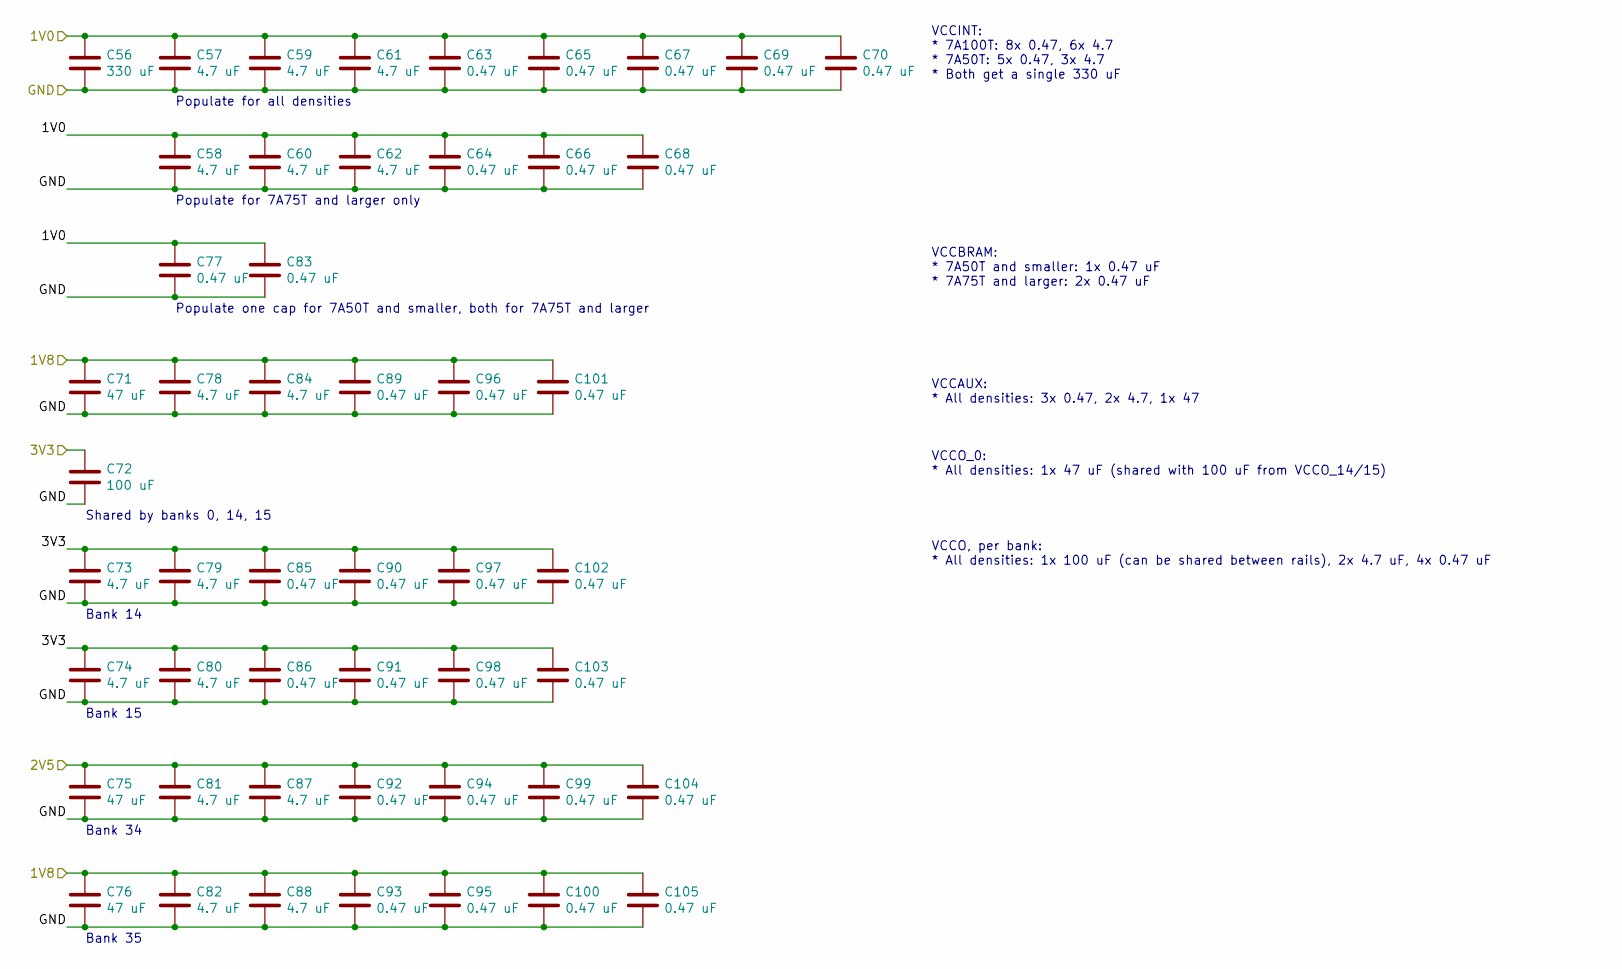
[picture p20: schematic fpga-decoupling.sch, INTEGRALSTICK Compute Module]

Parts:
C56: 330 uF; EIA_1210_CAP_NOSILK
C57, C58, C59, C60, C61, C62, C73, C74, C78, C79, C80, C81, C82, C84, C87, C88: 4.7 uF; EIA_0603_CAP_NOSILK
C63, C64, C65, C66, C67, C68, C69, C70, C77, C83, C85, C86, C89, C90, C91, C92, C93, C94, C95, C96, C97, C98, C99, C100, C101, C102, C103, C104, C105: 0.47 uF; EIA_0402_CAP_NOSILK
C71, C75, C76: 47 uF; EIA_1206_CAP_NOSILK
C72: 100 uF; EIA_1206_CAP_NOSILK

Connections:
/1V0: C56.1, C57.1, C58.1, C59.1, C60.1, C61.1, C62.1, C63.1, C64.1, C65.1, C66.1, C67.1, C68.1, C69.1, C70.1, C77.1, C83.1; also elsewhere on the board
/1V8: C71.1, C76.1, C78.1, C82.1, C84.1, C88.1, C89.1, C93.1, C95.1, C96.1, C100.1, C101.1, C105.1; also elsewhere on the board
/2V5: C75.1, C81.1, C87.1, C92.1, C94.1, C99.1, C104.1; also elsewhere on the board
/3V3: C72.1, C73.1, C74.1, C79.1, C80.1, C85.1, C86.1, C90.1, C91.1, C97.1, C98.1, C102.1, C103.1; also elsewhere on the board
/GND: C56.2, C57.2, C58.2, C59.2, C60.2, C61.2, C62.2, C63.2, C64.2, C65.2, C66.2, C67.2, C68.2, C69.2, C70.2, C71.2, C72.2, C73.2, C74.2, C75.2, C76.2, C77.2, C78.2, C79.2, C80.2, C81.2, C82.2, C83.2, C84.2, C85.2, C86.2, C87.2, C88.2, C89.2, C90.2, C91.2, C92.2, C93.2, C94.2, C95.2, C96.2, C97.2, C98.2, C99.2, C100.2, C101.2, C102.2, C103.2, C104.2, C105.2; also elsewhere on the board

Notes on the sheet:
VCCINT: * 7A100T: 8x 0.47, 6x 4.7 * 7A50T: 5x 0.47, 3x 4.7 * Both get a single 330 uF
Populate for 7A75T and larger only
Populate for all densities
VCCBRAM: * 7A50T and smaller: 1x 0.47 uF * 7A75T and larger: 2x 0.47 uF
Populate one cap for 7A50T and smaller, both for 7A75T and larger
VCCAUX: * All densities: 3x 0.47, 2x 4.7, 1x 47
VCCO_0: * All densities: 1x 47 uF (shared with 100 uF from VCCO_14/15)
VCCO, per bank: * All densities: 1x 100 uF (can be shared between rails), 2x 4.7 uF, 4x 0.47 uF
Shared by banks 0, 14, 15
Bank 14
Bank 15
Bank 34
Bank 35
