azonenberg/integralstick/pcb/integralstick.kicad_pcb

## KiCad design pcb/integralstick.kicad_pcb (continued)

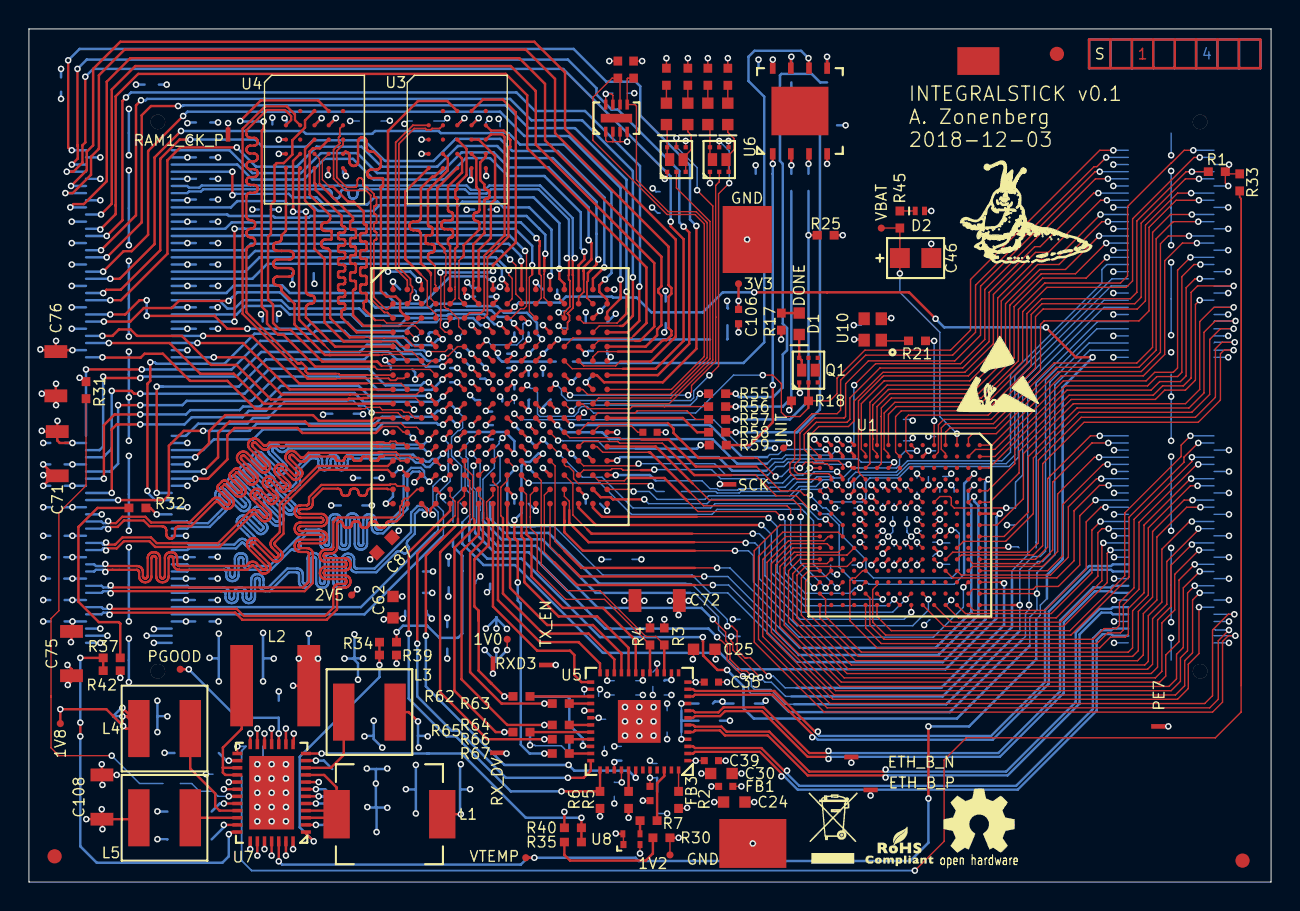
[picture p21: board integralstick.kicad_pcb from above]

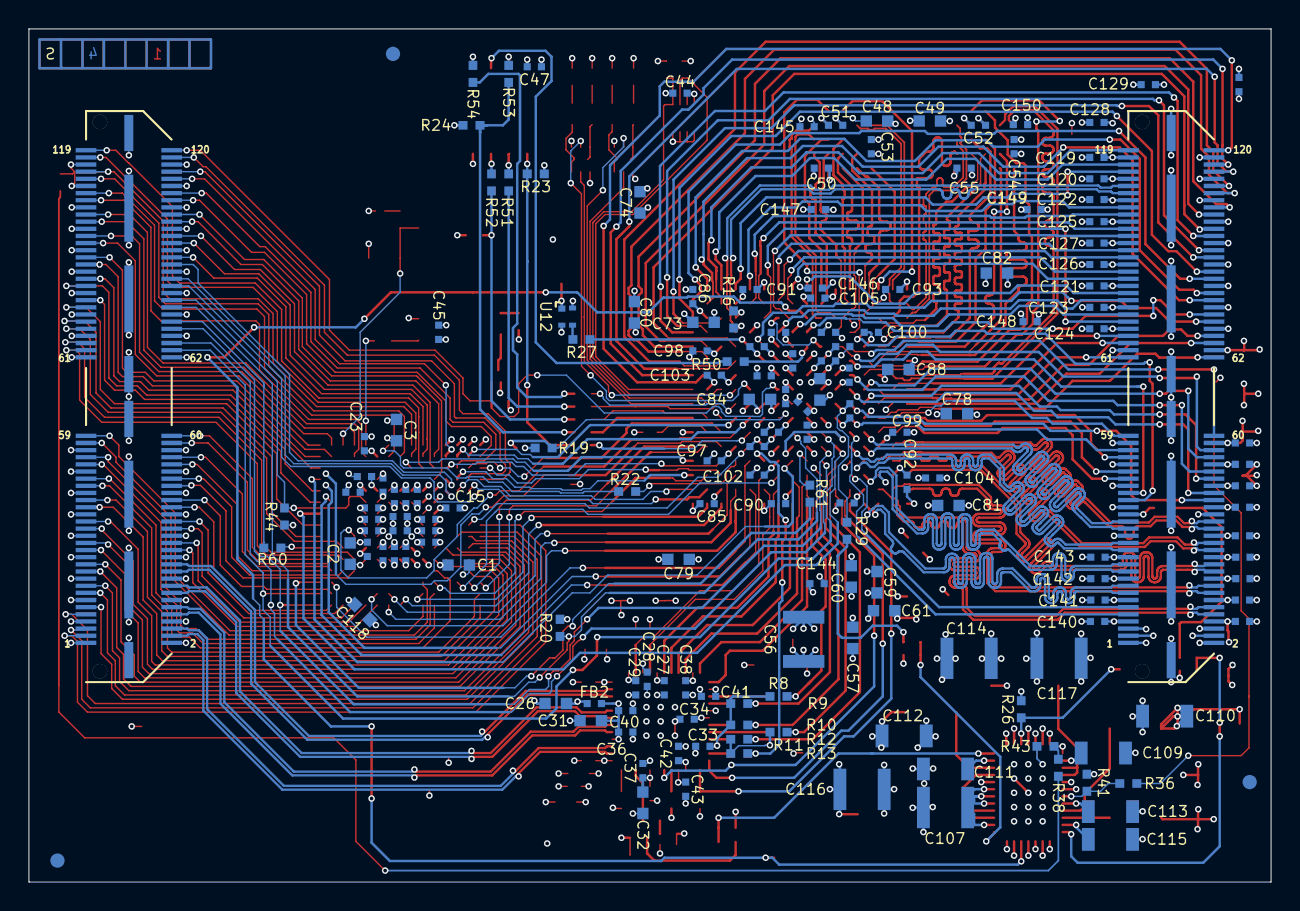
[picture p22: board integralstick.kicad_pcb from below]

Board: 4 copper layers, 87.0 x 59.8 mm, 272 parts (170 on the bottom side), 311 nets.

Other parts of the board:
FIDUCIAL_1MM, FIDUCIAL_1MM#2, FIDUCIAL_1MM#3, FIDUCIAL_1MM#4, FIDUCIAL_1MM#5, FIDUCIAL_1MM#6: VAL**; FIDUCIAL_1MM
