azonenberg/integralstick/(commit log)

2018-11-06 Initial schematic. Still needs PSU and review plus FPGA decoupling.
    [ethernet.sch, fpga-decoupling.sch, fpga.sch, integralstick.kicad_pcb, integralstick.sch, mcu-decoupling.sch, mcu.sch, psu.sch]
2018-11-07 Finished initial schematic. Pin assignments will likely change during routing. Ready for test point insertion and signoff review.
    [ethernet.sch, fpga-decoupling.sch, fpga.sch, integralstick.kicad_pcb, integralstick.sch, mcu-decoupling.sch, mcu.sch, psu.sch]
2018-11-07 Initial schematic for design review
2018-11-07 Changed IN_3V3_0_P/N to be on a MRCC pin so we can use it as an LVDS input clock
    [fpga.sch]
2018-11-07 Added pulldown to BOOT0 on MCU, brought it out to previously unused connector pin
    [integralstick.sch, psu.sch]
2018-11-07 Re-rendered design review schematic with recent board changes
2018-11-08 Updated design review schematic
2018-11-08 Added capacitor for bbRAM on STM32. Removed MCU config oscillator, we now use the FPGA or internal oscillator as clock. Added SPI bus from FPGA to MCU.
    [mcu.sch, psu.sch]
2018-11-08 Added four GPIO LEDs
    [fpga.sch]
2018-11-09 Finished schematic signoff review. Fixed oscillator pinout bug, added some test points.
    [ethernet.sch, fpga-decoupling.sch, fpga.sch, integralstick.sch, mcu-decoupling.sch, mcu.sch, psu.sch, ram.sch]
2018-11-09 Updated schematic after design review
2018-11-09 Assigned lots of footprints. Still have a few to go.
    [ethernet.sch, fpga-decoupling.sch, fpga.sch, integralstick.kicad_pcb, integralstick.sch, mcu-decoupling.sch, mcu.sch, psu.sch]
2018-11-09 Assigned inductor footprints
    [fpga.sch, integralstick.kicad_pcb, psu.sch]
2018-11-09 Initial design rules
    [integralstick.kicad_pcb]
2018-11-10 Finished initial footprint assignments
    [ethernet.sch, fpga.sch, integralstick.kicad_pcb, mcu.sch, psu.sch]
2018-11-11 Initial work on FPGA fanout
    [fpga.sch, integralstick.kicad_pcb, mcu.sch]
2018-11-12 Finished first iteration layout of RAM. Lots of pin swaps.
    [ethernet.sch, fpga-decoupling.sch, fpga.sch, integralstick.kicad_pcb, integralstick.sch, mcu-decoupling.sch, mcu.sch, psu.sch]
2018-11-12 Initial BGA fanout for 3.3V GPIO. Not complete.
    [integralstick.kicad_pcb]
2018-11-13 Lots more routing of 3.3V GPIO bus
    [ethernet.sch, fpga-decoupling.sch, fpga.sch, integralstick.kicad_pcb, integralstick.sch, mcu-decoupling.sch, mcu.sch, psu.sch]
2018-11-13 Continued routing 3.3V GPIO bus. Everything that can be fanned out on top metal is done.
    [fpga.sch, integralstick.kicad_pcb]
2018-11-13 Finished routing 3.3V GPIO bus
    [fpga.sch, integralstick.kicad_pcb]
2018-11-13 Added layer-change caps by Q-strip
    [ethernet.sch, fpga-decoupling.sch, fpga.sch, integralstick.kicad_pcb, integralstick.sch, mcu-decoupling.sch, mcu.sch, psu.sch]
2018-11-13 Initial FPGA plane layout
    [fpga.sch, integralstick.kicad_pcb]
2018-11-13 Began work on LVCMOS18 GPIOs. Swapped a lot of pins around.
    [integralstick.kicad_pcb]
2018-11-13 More efficient use of top right area above FPGA
    [integralstick.kicad_pcb, ram.sch]
2018-11-13 Initial routing of LVCMOS18 GPIO bus. Hooked up a few 0603 decoupling caps.
    [fpga.sch, integralstick.kicad_pcb, integralstick.sch, ram.sch]
2018-11-14 Initial layout of LVDS bank
    [fpga.sch, integralstick.kicad_pcb, psu.sch]
2018-11-14 Added missing 1V8 clock. Tweaked planes. Added some layer change caps.
    [fpga.sch, integralstick.kicad_pcb, integralstick.sch]
2018-11-17 Continued FPGA layout. Fanned out most signals going to MCU but pin assignments aren't final.
    [ethernet.sch, fpga-decoupling.sch, fpga.sch, integralstick.kicad_pcb, integralstick.sch, mcu-decoupling.sch, mcu.sch, psu.sch]
2018-11-17 Fixed diffpair DRC issues
    [integralstick.kicad_pcb]
2018-11-19 Initial placement of SMPS and inductors. No caps.
    [integralstick.kicad_pcb, psu.sch]
2018-11-20 Continued work on layout. Added some layer crossing caps. Initial power plane placement.
    [ethernet.sch, fpga-decoupling.sch, fpga.sch, integralstick.kicad_pcb, integralstick.sch, mcu-decoupling.sch, mcu.sch, psu.sch]
2018-11-21 Initial STM32 fanout
    [ethernet.sch, fpga-decoupling.sch, fpga.sch, integralstick.kicad_pcb, integralstick.sch, mcu-decoupling.sch, mcu.sch, psu.sch]
2018-11-24 Finished initial routing
    [ethernet.sch, fpga-decoupling.sch, fpga.sch, integralstick.kicad_pcb, integralstick.sch, mcu-decoupling.sch, mcu.sch, psu.sch]
2018-11-28 Updated pin cache
    [integralstick.kicad_pcb]
2018-11-30 Added lots of test points
    [ethernet.sch, fpga-decoupling.sch, fpga.sch, integralstick.kicad_pcb, integralstick.sch, mcu-decoupling.sch, mcu.sch, psu.sch]
2018-12-03 Final PCB design being sent to fab for quotes
    [ethernet.sch, fpga-decoupling.sch, fpga.sch, integralstick.kicad_pcb, integralstick.sch, mcu-decoupling.sch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]
2018-12-03 Changed soldermask web size to something more sane
    [integralstick.kicad_pcb]
2018-12-03 Fixed C124 silkscreen over component pad
    [integralstick.kicad_pcb]
2018-12-03 Updated project with correct soldermask width
2019-01-11 Updated integralstick schematic to fix library paths. No content changes.
    [fpga.sch, integralstick.sch, psu.sch]
2019-01-11 Initial version of mintest-left
    [mintest-left.kicad_pcb, mintest-left.sch]
2019-01-11 Initial version of mintest-right board
    [mintest-left.kicad_pcb, mintest-right.kicad_pcb, mintest-right.sch]
2019-11-04 Updated caches and hello test
    [ethernet.sch, fpga-decoupling.sch, fpga.sch, integralstick.sch, mcu-decoupling.sch, mcu.sch, psu.sch, ram.sch]
2019-11-04 Initial version of host-full board
    [ethernet.sch, host-full.kicad_pcb, host-full.sch, mcu.sch, psu.sch]
2019-11-05 Finished initial schematic review
    [ethernet.sch, host-full.sch, mcu.sch, psu.sch]
2019-11-08 Initial layout on host-full. Rough floorplan is finalized, all MCU PMODs routed.
    [ethernet.sch, host-full.kicad_pcb, host-full.sch, mcu.sch, psu.sch]
2019-11-10 Continued host-full layout. Almost all PHY RGMII routing done
    [ethernet.sch, host-full.kicad_pcb, host-full.sch, mcu.sch, psu.sch]
2019-11-11 Finished initial routing, still need to do planes and design review
    [host-full.kicad_pcb, psu.sch]
2019-11-11 Initial plane layout. Still need more work on power layers.
    [host-full.kicad_pcb]
2019-11-11 Finished tweaking zone fills. Ready for signoff review.
    [host-full.kicad_pcb]
2019-11-11 Various fixes during layout review, added some silkscreen labels and a layer-change cap
    [ethernet.sch, host-full.kicad_pcb, host-full.sch, mcu.sch, psu.sch]
2019-11-18 Updated ignore for gerber zip
2019-11-28 Removed stray noconnect marker
    [host-full.sch]
